Zephurah/ME250-103/MS5 Submission/ME 250 Team 103 CAD Drawings _ Screenshots.pdf

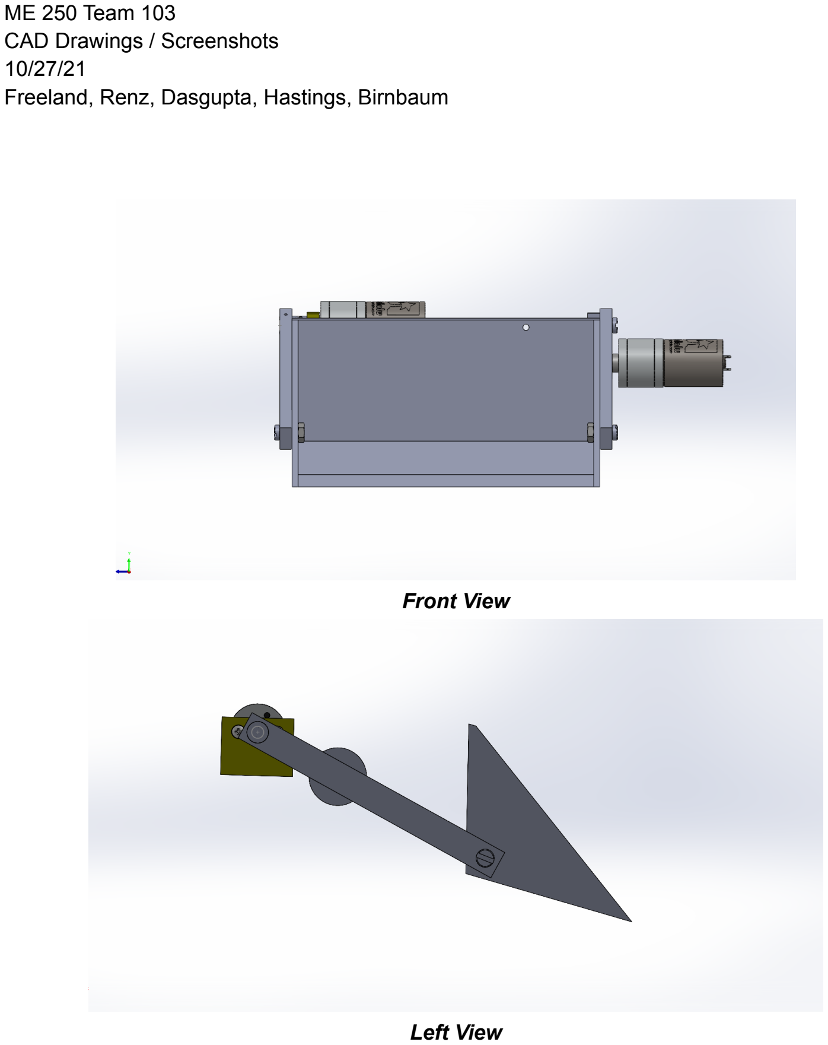
[picture p1: page 1]

ME 250 Team 103
CAD Drawings / Screenshots
10/27/21
Freeland, Renz, Dasgupta, Hastings, Birnbaum

Front View

Left View

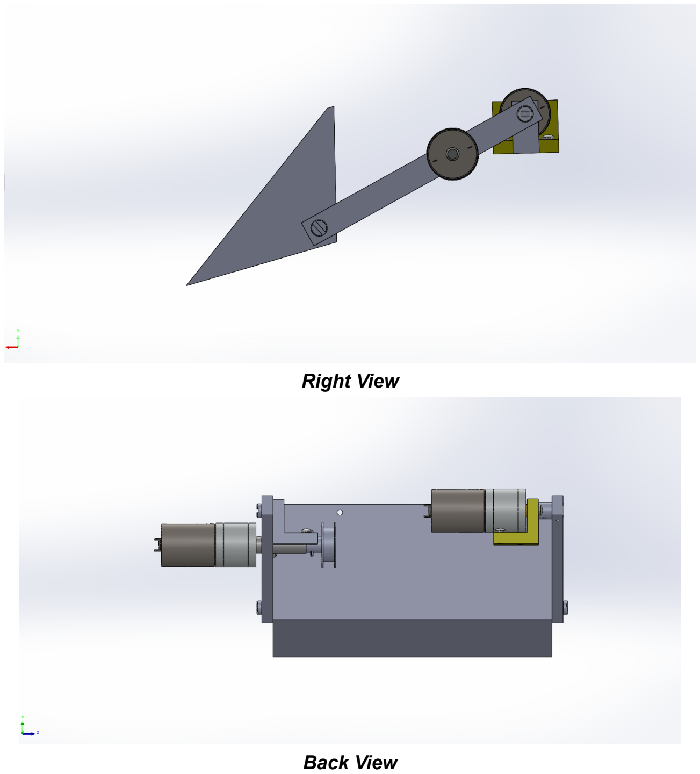
[picture p2: page 2]

Right View

Back View

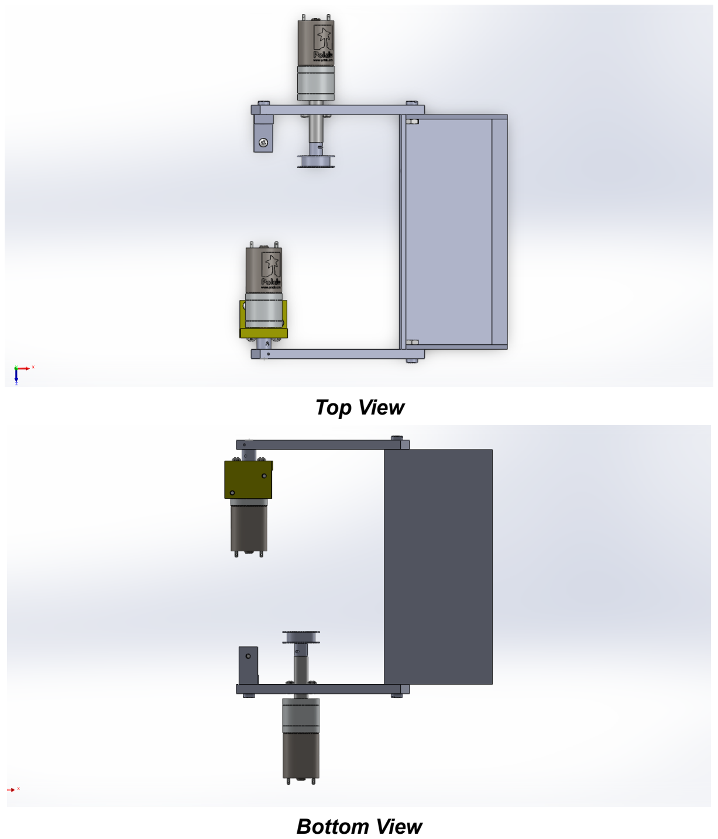
[picture p3: page 3]

Top View

Bottom View

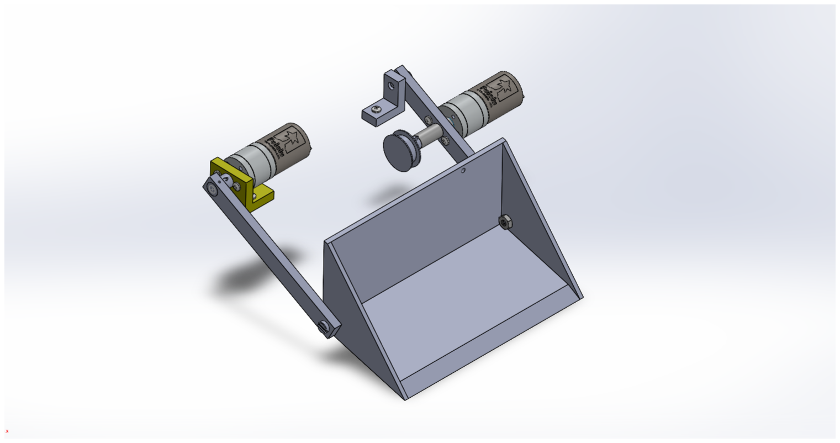
[picture p4: figure]

Isometric 1

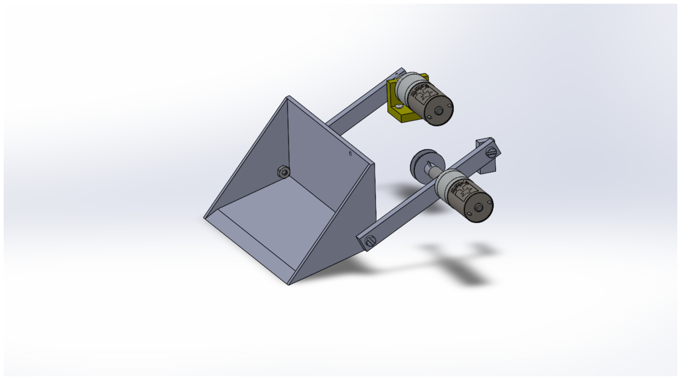
[picture p5: figure]

Isometric 2
