Zephurah/ME250-103/CAD RMP/111 Pre-made parts/Example SetScrew SpringPin/Screenshot.pdf

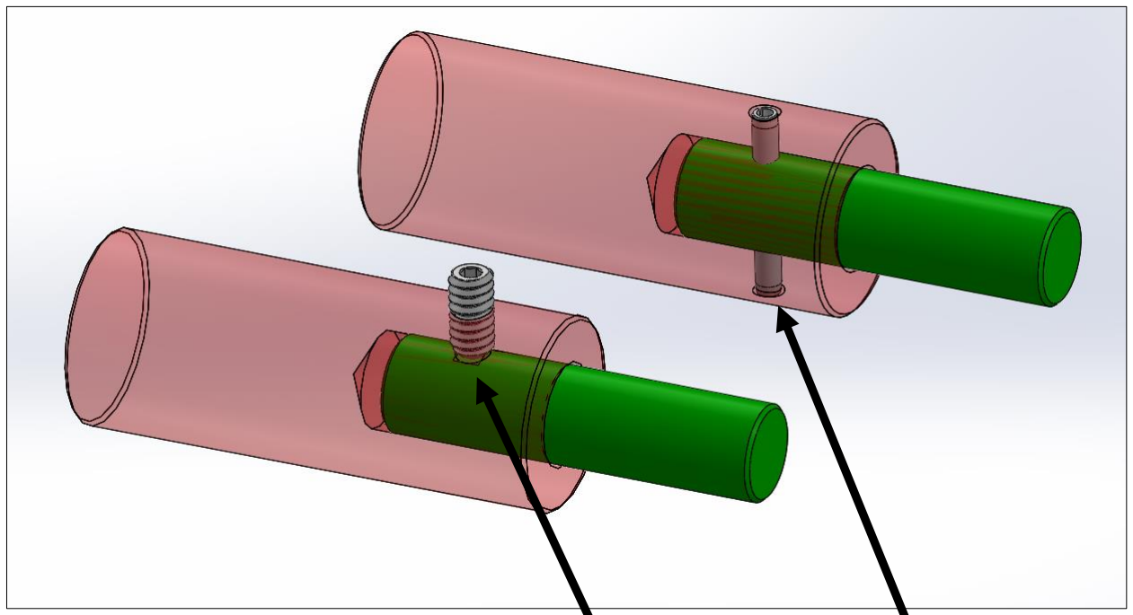
[picture p6: figure]

Set Screw Spring Pin
