Zephurah/ME250-103/CAD RMP/111 Pre-made parts/Planetary Gear Box/TanSunGear.SLDASM

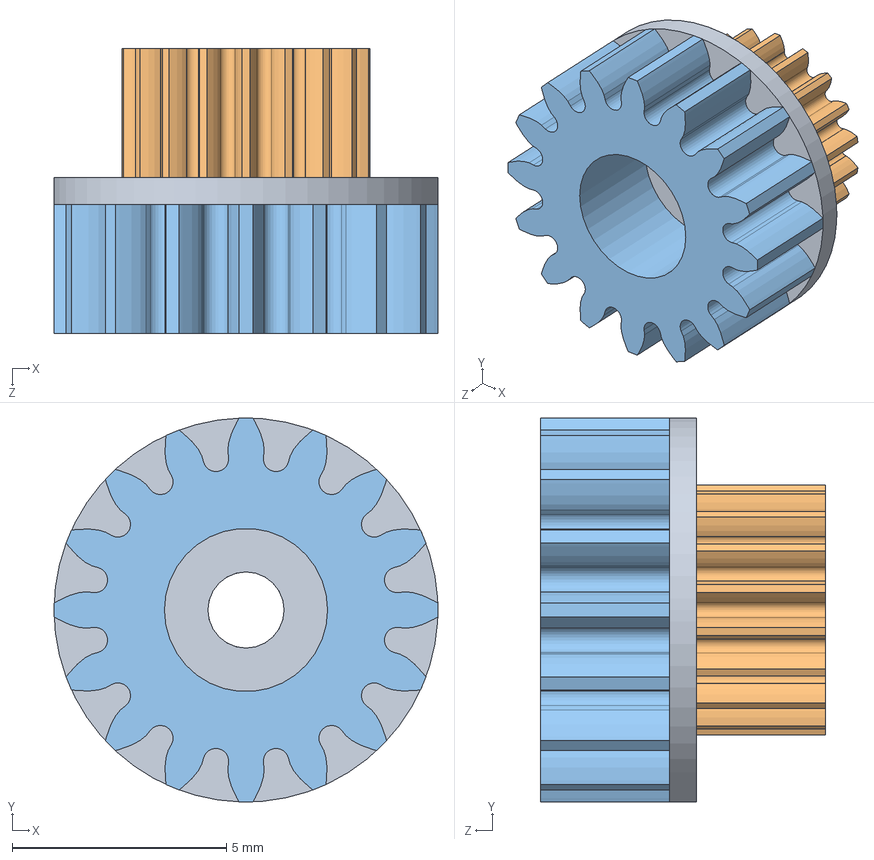
[picture p7: CAD file, 2021-10-25]
CAD RMP/111 Pre-made parts/Planetary Gear Box/TanSunGear.SLDASM
8.97 x 8.96 x 6.65 mm
TanIntermediaryPlate
TanSpurSmall
TanSpurLarge
