Zephurah/ME250-103/CAD RMP/Frame/Concept 4 WO frame.SLDASM

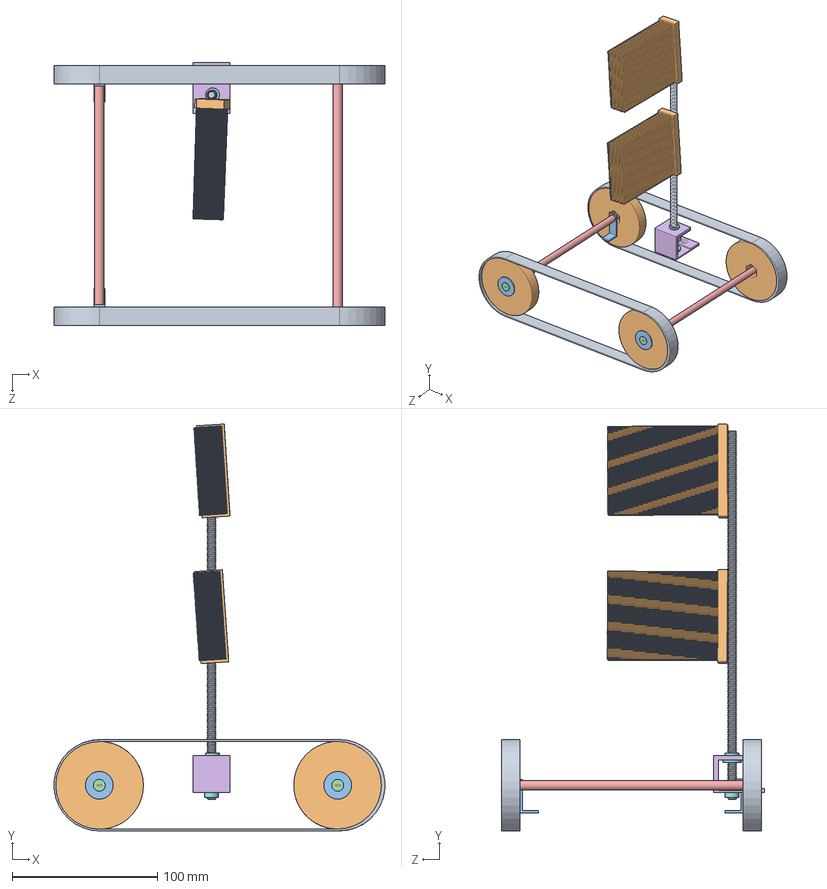
[picture p8: CAD file, 2021-10-25]
CAD RMP/Frame/Concept 4 WO frame.SLDASM
227.7 x 280.2 x 181.0 mm
RMPTread1 x 2
RMPWheel1 x 4
washer 3-4 OD 1-8 ID x 4
Screw 1-8in ID .75in length x 4
Axle x 2
Bracket
Locking pin
1-4 bushing x 2
94210A125_Medium-Strength Threaded Rod - 10in
Brush x 2
.3 X.5 .0625TH L bracket x 2
