Zephurah/ME250-103/CAD RMP/Wheel Axle/Front axle.SLDASM

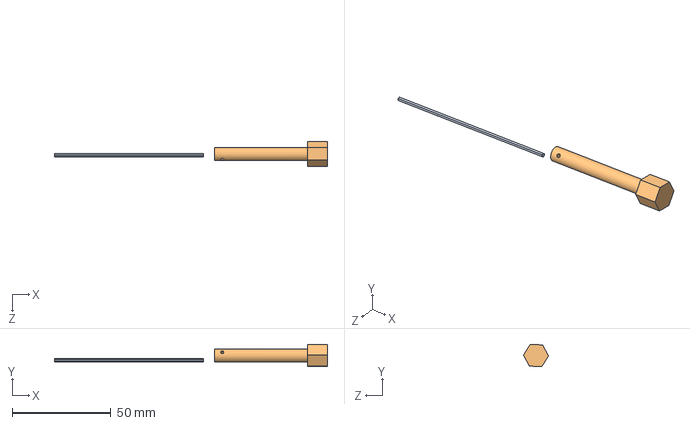
[picture p9: CAD file, 2021-11-29]
CAD RMP/Wheel Axle/Front axle.SLDASM
138.4 x 11.2 x 12.7 mm
motor shaft
Wheel axle
