Zephurah/ME250-103/CAD RMP/Brush/Brush Arm.SLDASM

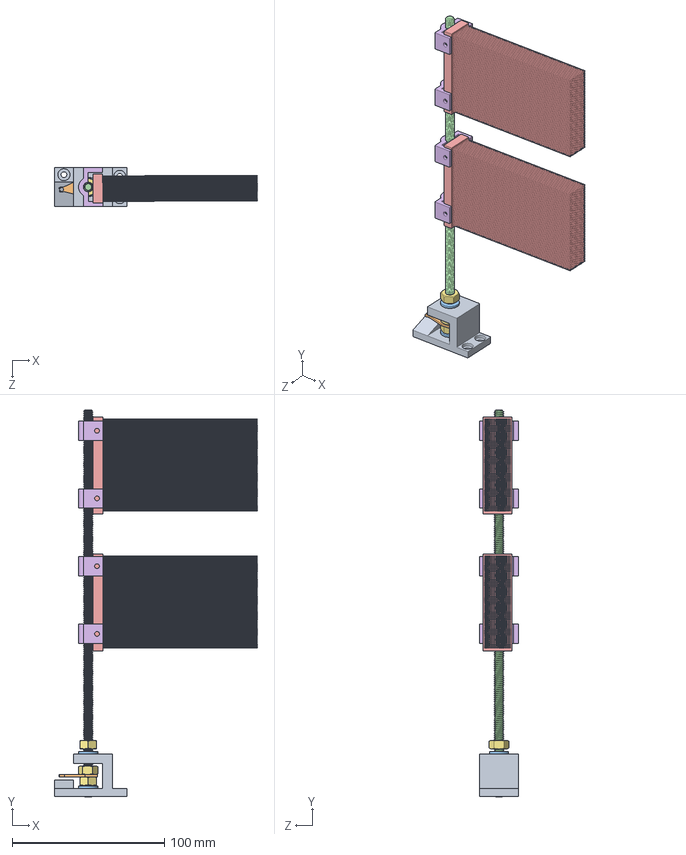
[picture p10: CAD file, 2021-11-11]
CAD RMP/Brush/Brush Arm.SLDASM
133.4 x 254.0 x 25.5 mm
Bracket
Locking pin
1-4 bushing x 2
94210A125_Medium-Strength Threaded Rod - 10in
Brush x 2
support x 4
95462A029_Medium-Strength Steel Hex Nut x 3
