Zephurah/ME250-103/CAD RMP/Frame/New final frame/New Frame with individual sides.SLDASM

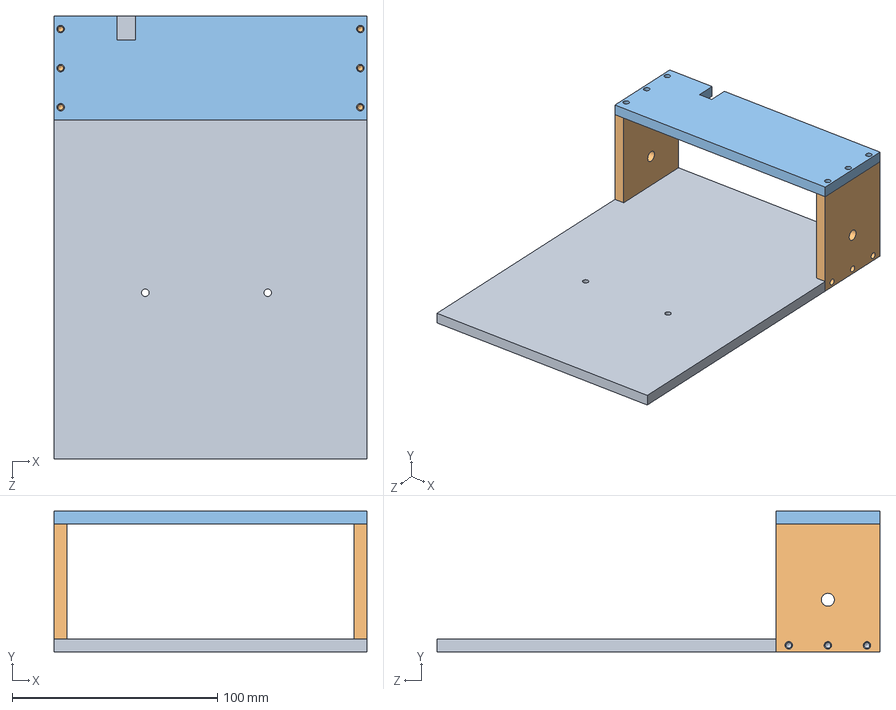
[picture p11: CAD file, 2021-11-11]
CAD RMP/Frame/New final frame/New Frame with individual sides.SLDASM
152.4 x 68.6 x 215.9 mm
Bottom frame
Side frame x 2
Top frame
