Zephurah/ME250-103/CAD RMP/Project/Gear Motor Bracket Assy with String.SLDASM

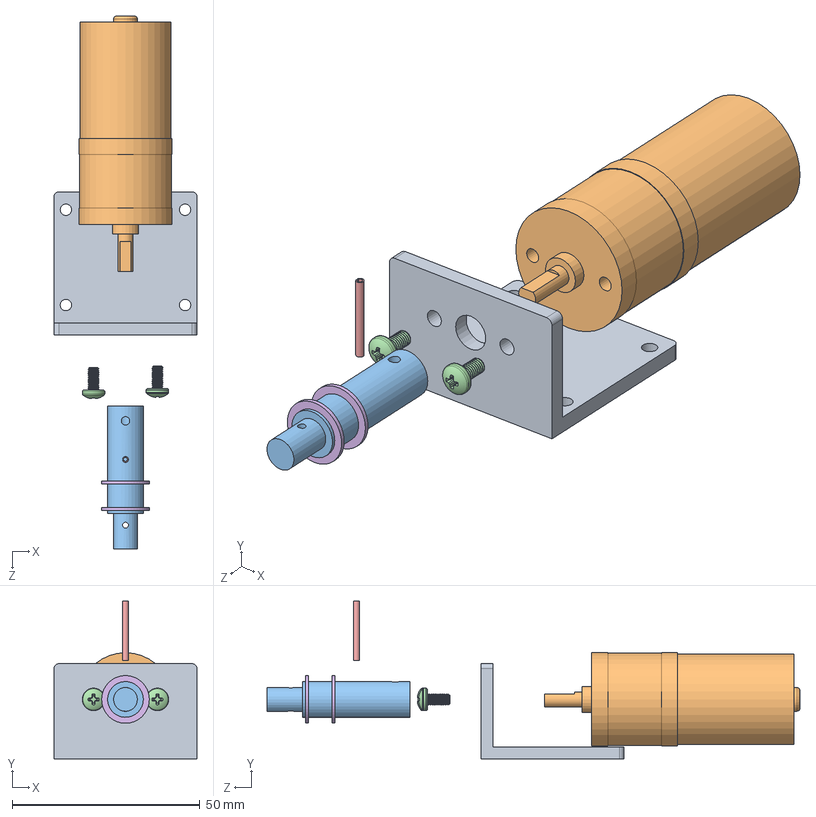
[picture p12: CAD file, 2021-11-11]
CAD RMP/Project/Gear Motor Bracket Assy with String.SLDASM
38.1 x 42.1 x 142.0 mm
Motor Bracket
Gear Motor
Connecting Shaft
3 mm screw x 2
Spring Pin
String Winder
