Zephurah/ME250-103/CAD RMP/Project/Treads/drive-download-20211011T011059Z-001/Finished treads with axle.SLDASM

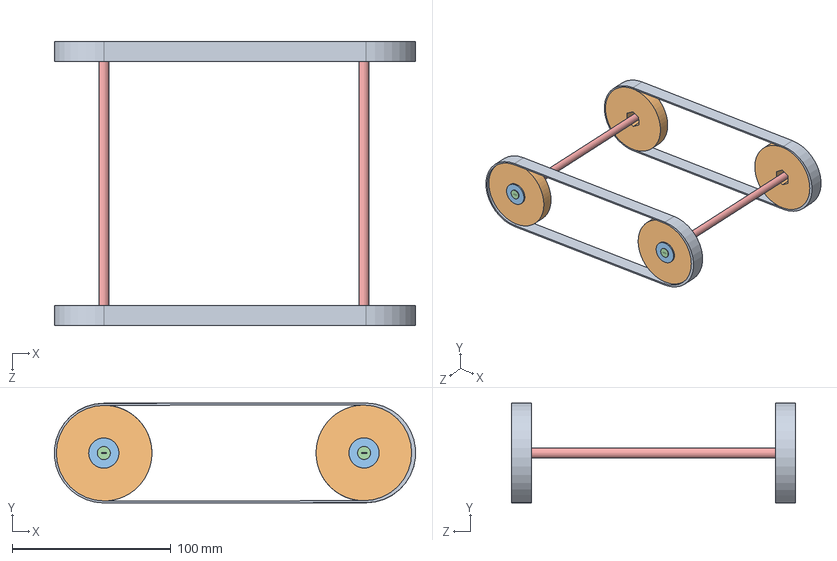
[picture p13: CAD file, 2021-10-25]
CAD RMP/Project/Treads/drive-download-20211011T011059Z-001/Finished treads with axle.SLDASM
227.7 x 63.0 x 179.1 mm
RMPTread1 x 2
RMPWheel1 x 4
washer 3-4 OD 1-8 ID x 4
Screw 1-8in ID .75in length x 4
Axle x 2
