Zephurah/ME250-103/CAD RMP/Treads/RMPtread_Wheel_final.SLDASM

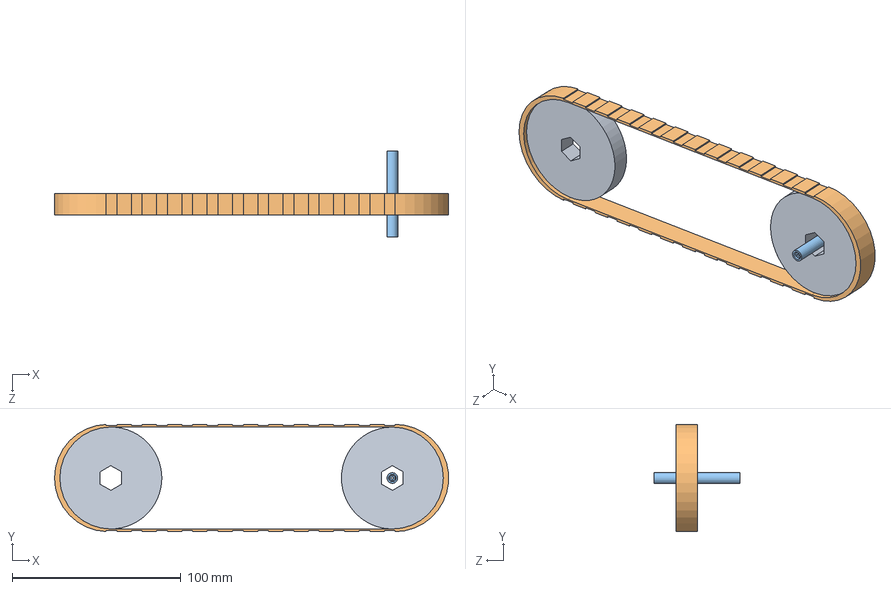
[picture p14: CAD file, 2021-11-06]
CAD RMP/Treads/RMPtread_Wheel_final.SLDASM
233.2 x 63.5 x 50.8 mm
RMPWheel1 x 2
RMPtreadFINALFINALFINAL
myAxle
