Zephurah/ME250-103/CAD RMP/Project/Final Arm Assembly.SLDASM

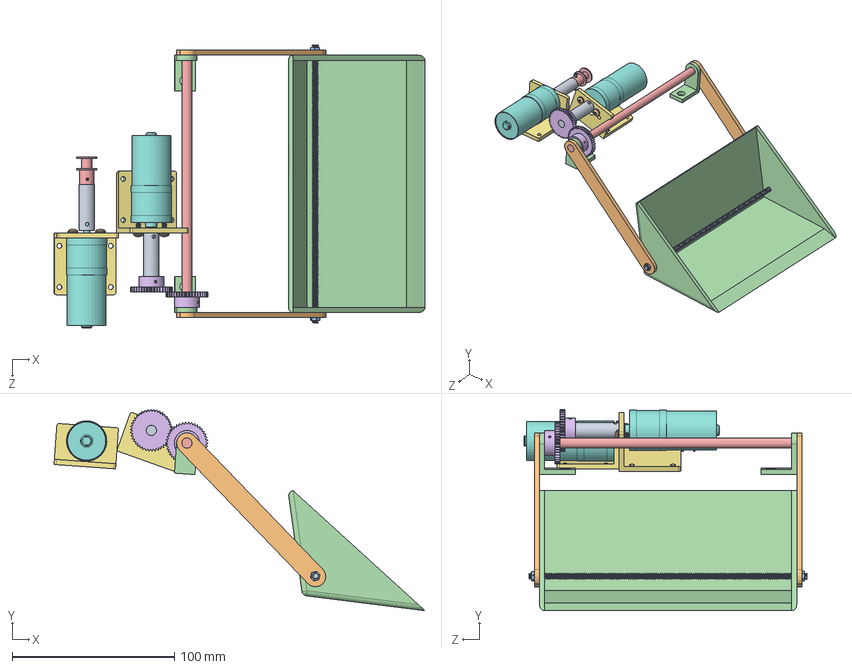
[picture p15: CAD file, 2021-11-11]
CAD RMP/Project/Final Arm Assembly.SLDASM
228.9 x 124.2 x 174.7 mm
Axel
lever Bar x 2
M3Nut x 2
Scooper
Gear Axel
Gear 1 x 2
Motor Bracket x 2
Gear Motor x 2
Connecting Shaft x 2
3 mm screw x 4
Spring Pin x 2
Small L Backet x 2
String Winder
