Zephurah/ME250-103/CAD RMP/Arm/Final Arm Assembly.SLDASM

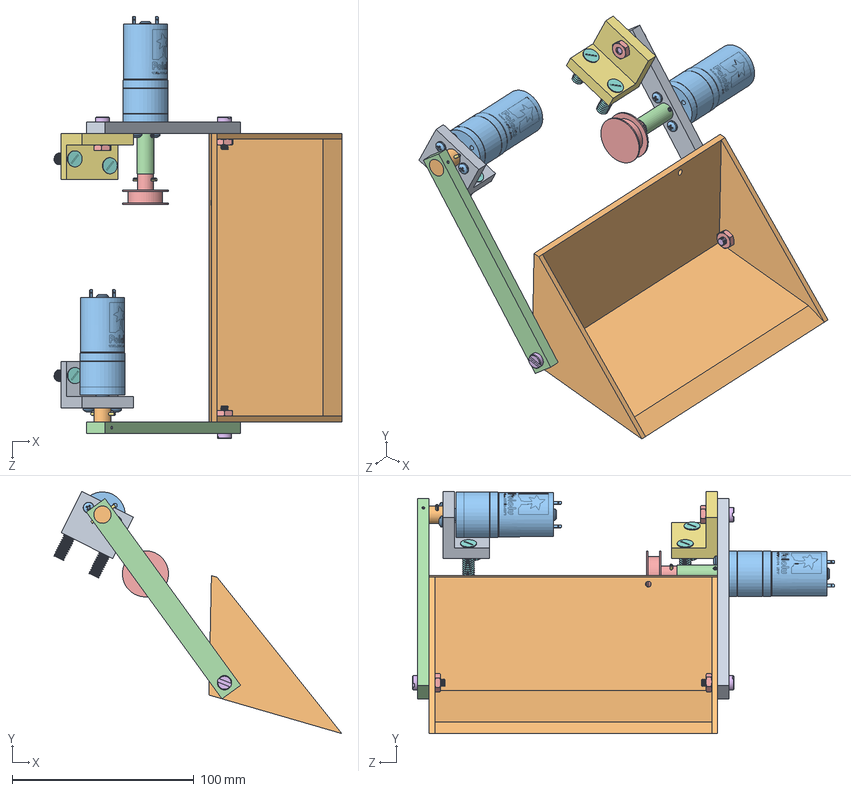
[picture p16: CAD file, 2021-11-05]
CAD RMP/Arm/Final Arm Assembly.SLDASM
158.4 x 133.3 x 232.2 mm
lever Bar
Scooper
Metal Motor x 2
Connecting Shaft
String Winder
screw with shoulder REAL x 3
Spring Pin x 2
4-40 set screw
Motor Bracket
Motor Arm Connecting shaft
3 mm screw x 4
lever Bar(DRIVING)
90480A009_Low-Strength Steel Hex Nut x 3
0.500 inch Spring Pin
Small L Bracket V2
Screw 1-4in ID .75in length x 4
