Zephurah/ME250-103/CAD RMP/Project/The Final Assembly.SLDASM

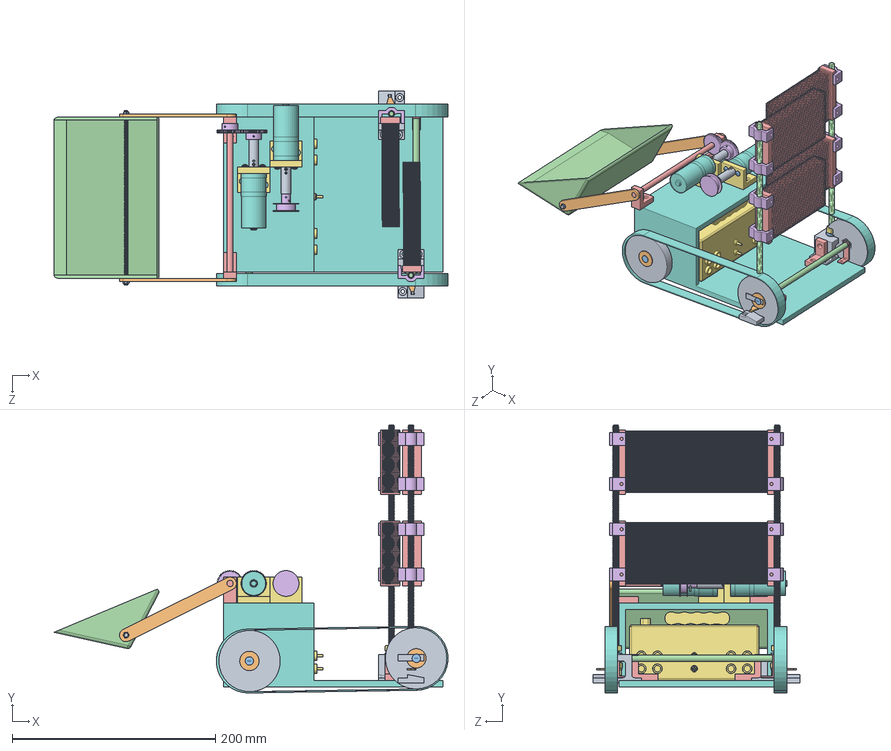
[picture p17: CAD file, 2021-11-11]
CAD RMP/Project/The Final Assembly.SLDASM
387.4 x 263.5 x 203.2 mm
Axel
lever Bar x 2
M3Nut x 2
Scooper
Gear Axel
Gear 1 x 2
Motor Bracket x 2
Gear Motor x 2
Connecting Shaft x 2
4-40 Set Screw x 2
3 mm screw x 4
Spring Pin x 2
Small L Backet x 4
String Winder
Control Box
Frame final
Bracket x 2
Locking pin x 2
1-4 bushing x 4
94210A125_Medium-Strength Threaded Rod - 10in x 2
Brush x 4
support x 8
95462A029_Medium-Strength Steel Hex Nut x 6
RMPTread1 x 2
RMPWheel1 x 4
washer 3-4 OD 1-8 ID x 4
Screw 1-8in ID .75in length x 4
Axle x 2
3 X.5 .0625TH L bracket x 2
