Zephurah/ME250-103/CAD RMP/Treads/Finished treads with axle.SLDASM

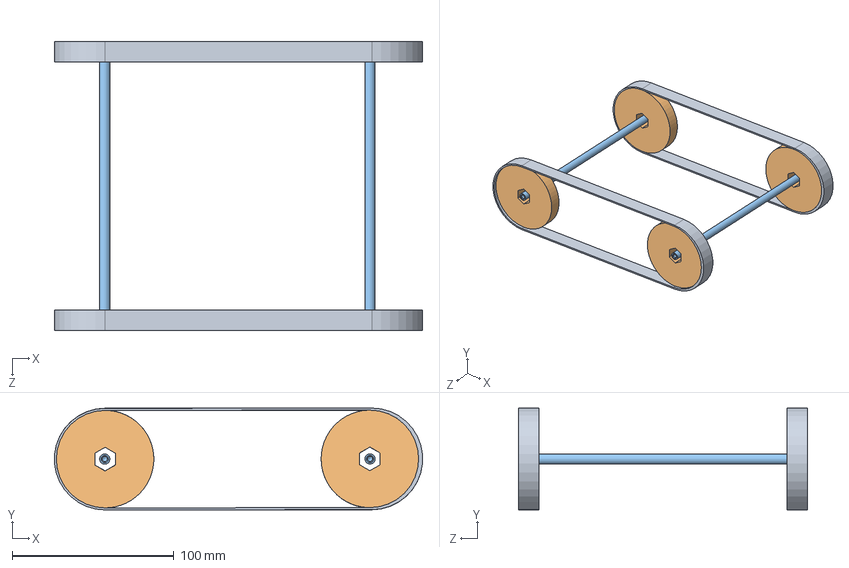
[picture p18: CAD file, 2021-11-06]
CAD RMP/Treads/Finished treads with axle.SLDASM
227.7 x 63.0 x 179.1 mm
RMPTread1 x 2
RMPWheel1 x 4
Axle x 2
