Zephurah/ME250-103/CAD RMP/Wheel Axle/Back wheel axle.SLDASM

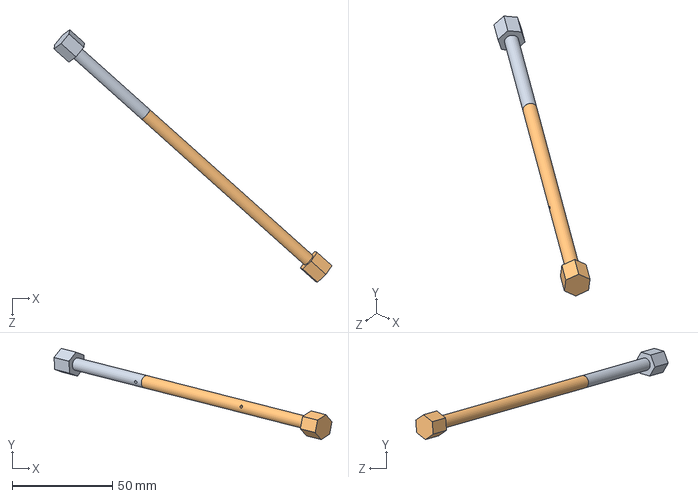
[picture p19: CAD file, 2021-11-09]
CAD RMP/Wheel Axle/Back wheel axle.SLDASM
138.8 x 45.6 x 126.1 mm
Wheel axle
Back axle
