Zephurah/ME250-103/CAD RMP/111 Pre-made parts/Mounting_Examples/Double GearBox Motor Base Plate.SLDASM

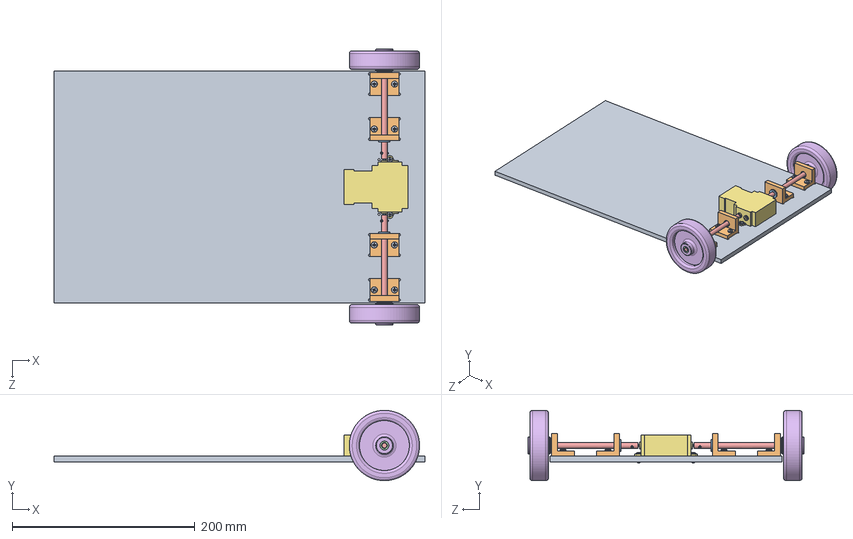
[picture p20: CAD file, 2021-10-25]
CAD RMP/111 Pre-made parts/Mounting_Examples/Double GearBox Motor Base Plate.SLDASM
406.4 x 77.0 x 302.1 mm
Base Plate with Bushing Mount pockets
Bushing Mount 2 x 4
Bushing x 4
Wheel Bushing x 2
Wheel connecting shaft x 2
Wheel for Slotbot x 2
Motor Blank
Motor Shaft
Pan Cross Head_AI x 10
Socket Set Screw Cup Point_AI x 4
