Zephurah/ME250-103/CAD RMP/Arm/Final Driving Lever Arm.SLDASM

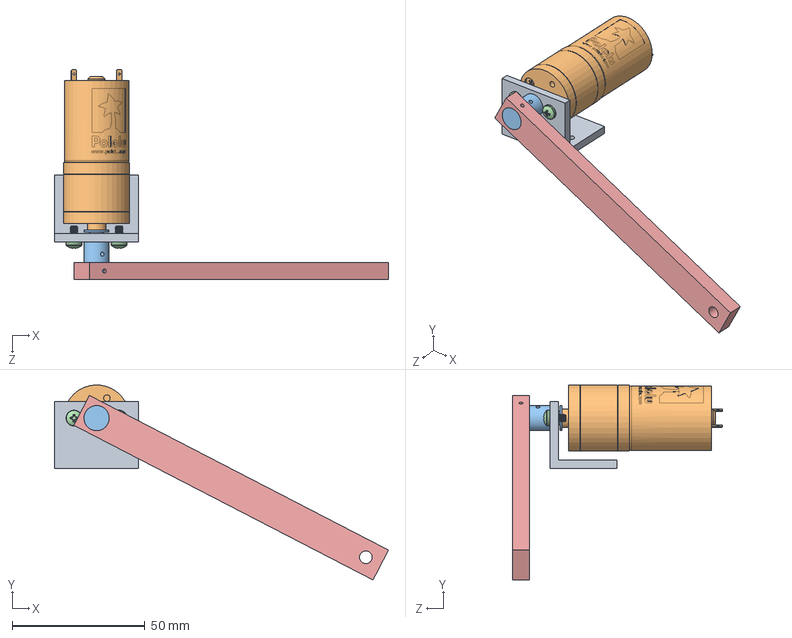
[picture p21: CAD file, 2021-11-04]
CAD RMP/Arm/Final Driving Lever Arm.SLDASM
126.0 x 73.5 x 79.1 mm
Motor Bracket
Metal Motor
Motor Arm Connecting shaft
3 mm screw x 2
lever Bar(DRIVING)
