Zephurah/ME250-103/CAD RMP/Project/Gear Motor Bracket Assy 2.SLDASM

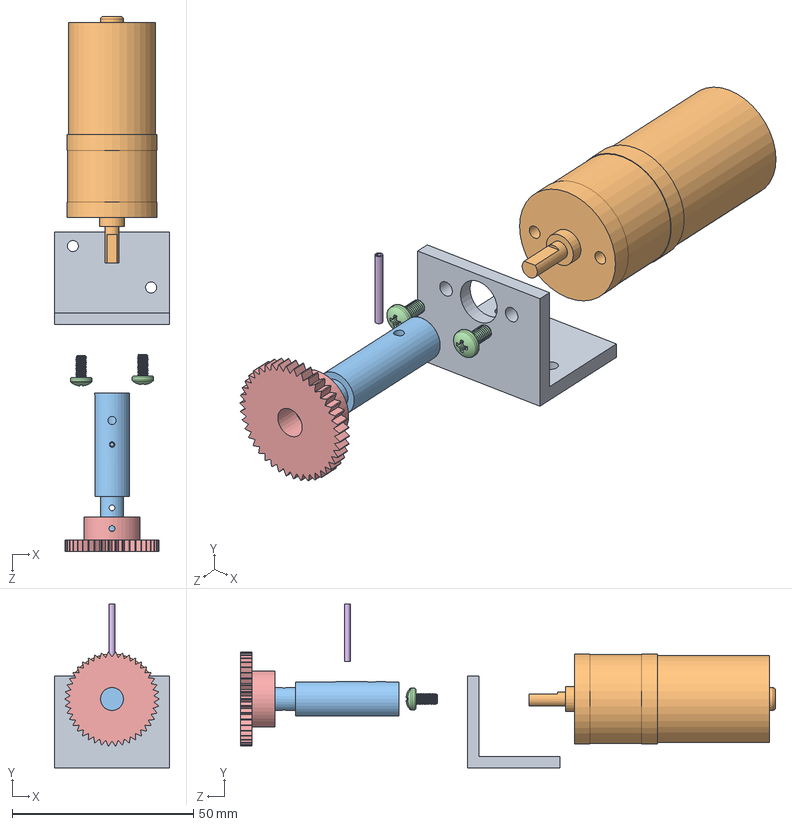
[picture p22: CAD file, 2021-11-11]
CAD RMP/Project/Gear Motor Bracket Assy 2.SLDASM
31.8 x 45.3 x 147.7 mm
Motor Bracket
Gear Motor
Connecting Shaft
3 mm screw x 2
Gear 1
Spring Pin
