Zephurah/ME250-103/CAD RMP/Treads/WheelTreadAssem.SLDASM

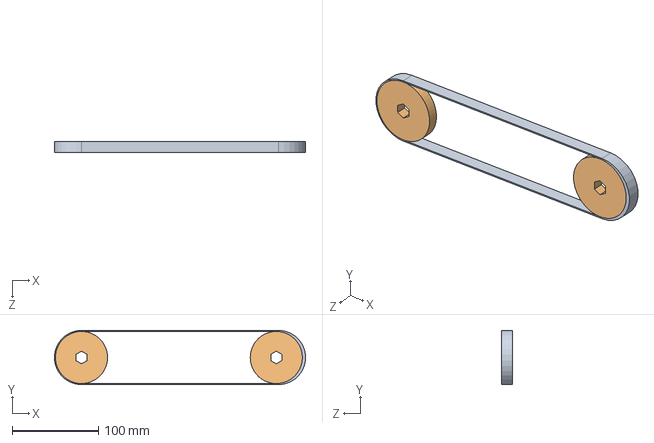
[picture p23: CAD file, 2021-11-01]
CAD RMP/Treads/WheelTreadAssem.SLDASM
290.5 x 62.9 x 12.7 mm
RMPTread1
RMPWheel1 x 2
