Zephurah/ME250-103/CAD RMP/111 Pre-made parts/Mounting_Examples/Assembled Shaft Mount Bracket and Bushing.SLDASM

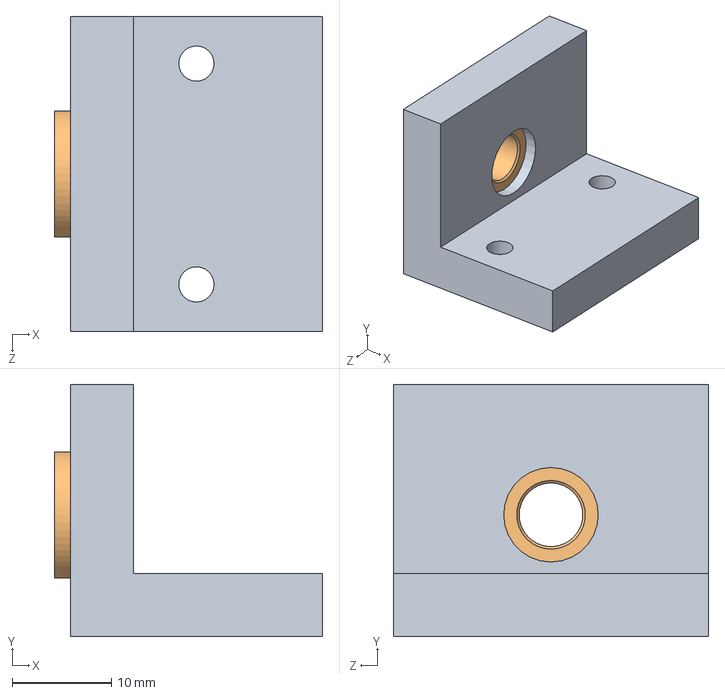
[picture p24: CAD file, 2021-10-25]
CAD RMP/111 Pre-made parts/Mounting_Examples/Assembled Shaft Mount Bracket and Bushing.SLDASM
27.0 x 25.4 x 31.8 mm
Bushing Mount 2
Bushing
