Zephurah/ME250-103/CAD RMP/111 Pre-made parts/Mounting_Examples/24 tooth Gear.SLDASM

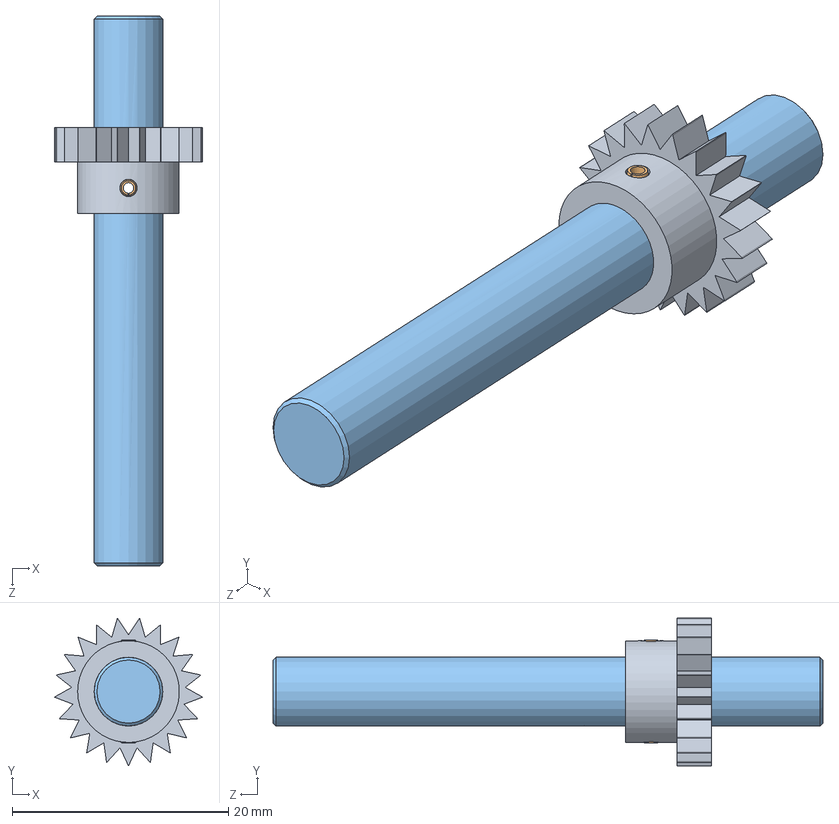
[picture p25: CAD file, 2021-10-25]
CAD RMP/111 Pre-made parts/Mounting_Examples/24 tooth Gear.SLDASM
13.7 x 13.6 x 50.8 mm
24 tooth Gear
Spring Pin Slotted_AI
Sample Gear Shaft 24 tooth
