Zephurah/ME250-103/CAD RMP/111 Pre-made parts/Mounting_Examples/Exploded Gear Rack Assy..SLDASM

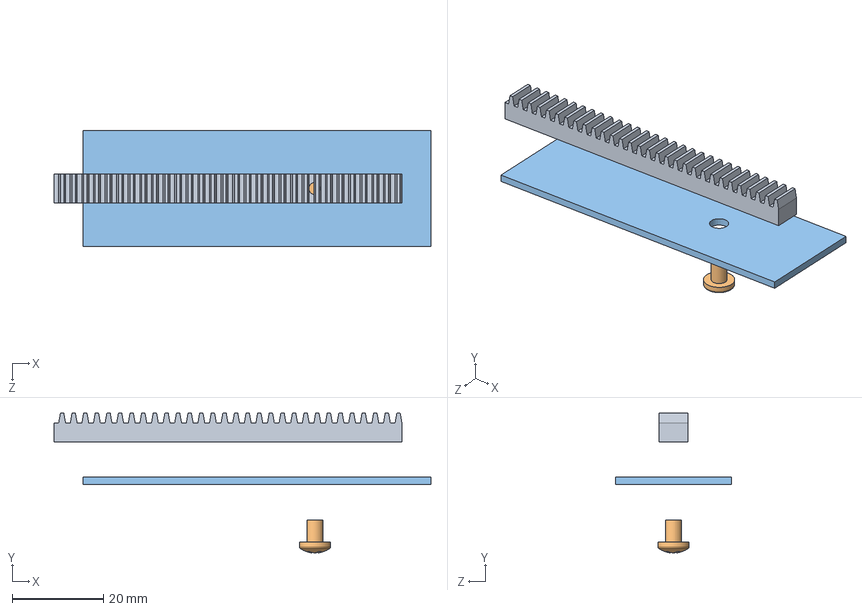
[picture p26: CAD file, 2021-10-25]
CAD RMP/111 Pre-made parts/Mounting_Examples/Exploded Gear Rack Assy..SLDASM
82.6 x 30.6 x 25.4 mm
Gear Rack Example
Pan Cross Head_AI
.063 Alum Plate
