Zephurah/ME250-103/CAD RMP/111 Pre-made parts/Mounting_Examples/Motor Assem.SLDASM

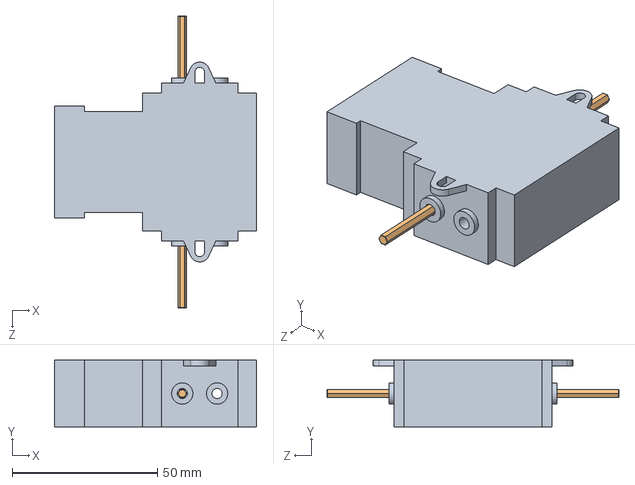
[picture p27: CAD file, 2021-10-25]
CAD RMP/111 Pre-made parts/Mounting_Examples/Motor Assem.SLDASM
69.6 x 23.0 x 100.5 mm
Motor Blank
Motor Shaft
