Zephurah/ME250-103/CAD RMP/111 Pre-made parts/Planetary Gear Box/OrangeDriveDiskCut.SLDASM

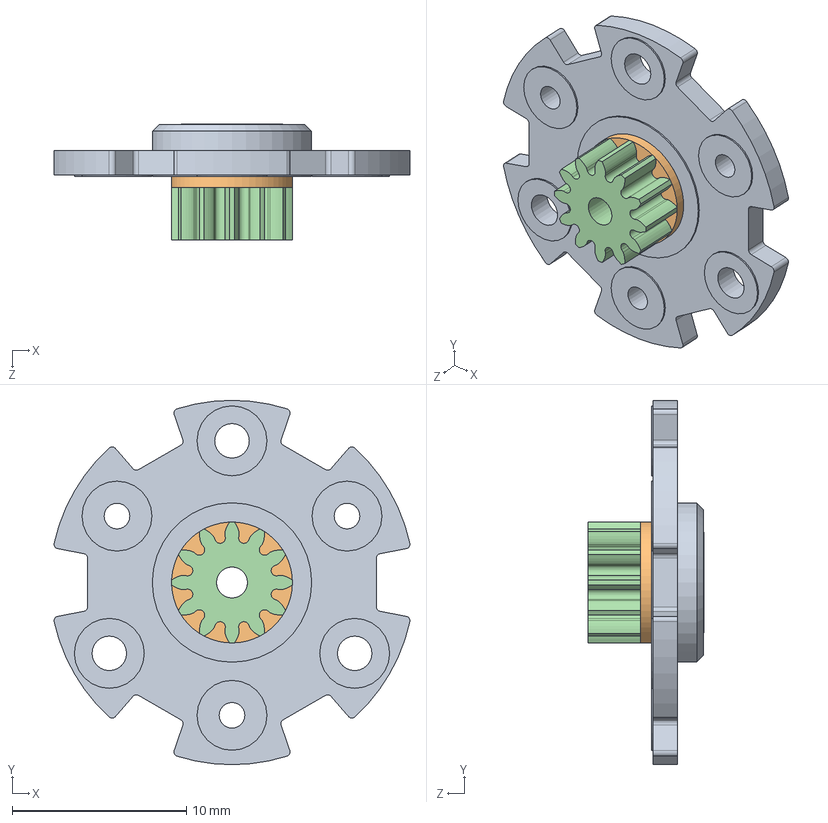
[picture p28: CAD file, 2021-10-25]
CAD RMP/111 Pre-made parts/Planetary Gear Box/OrangeDriveDiskCut.SLDASM
20.4 x 20.9 x 6.64 mm
OrangeDriveDisk
OrangeIntermediaryPlate
OrangeSpurSmall
OrangeSpurLarge
