Zephurah/ME250-103/CAD RMP/111 Pre-made parts/Planetary Gear Box/A_Outlet.SLDASM

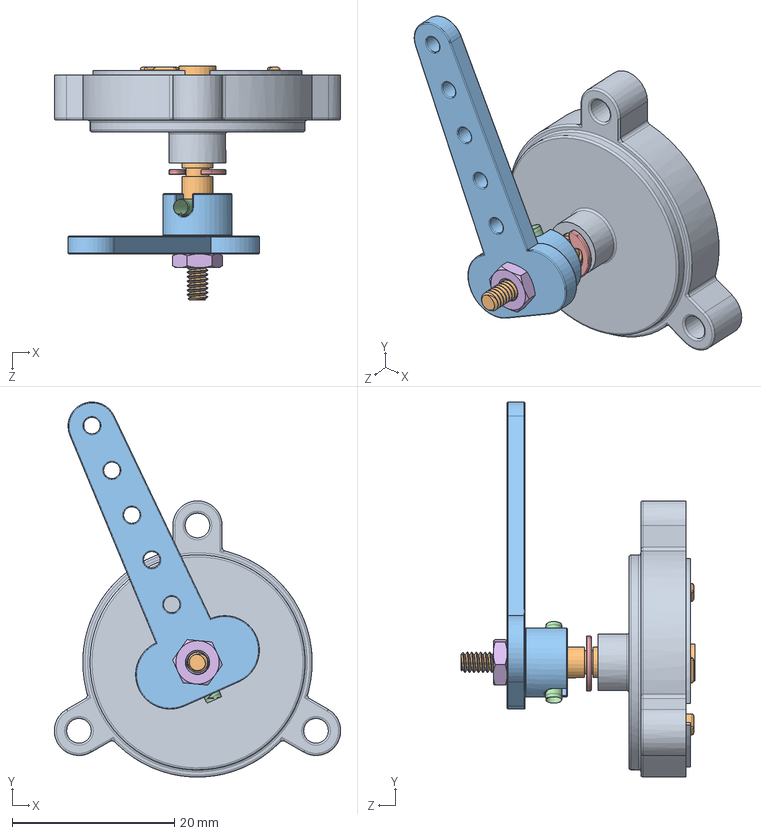
[picture p29: CAD file, 2021-10-25]
CAD RMP/111 Pre-made parts/Planetary Gear Box/A_Outlet.SLDASM
35.4 x 46.3 x 28.8 mm
OutletCase
DriveDiskJoint
SingleHorn
SpringPin
EClip
M3Nut
