Zephurah/ME250-103/CAD RMP/111 Pre-made parts/Planetary Gear Box/A_TanSet.SLDASM

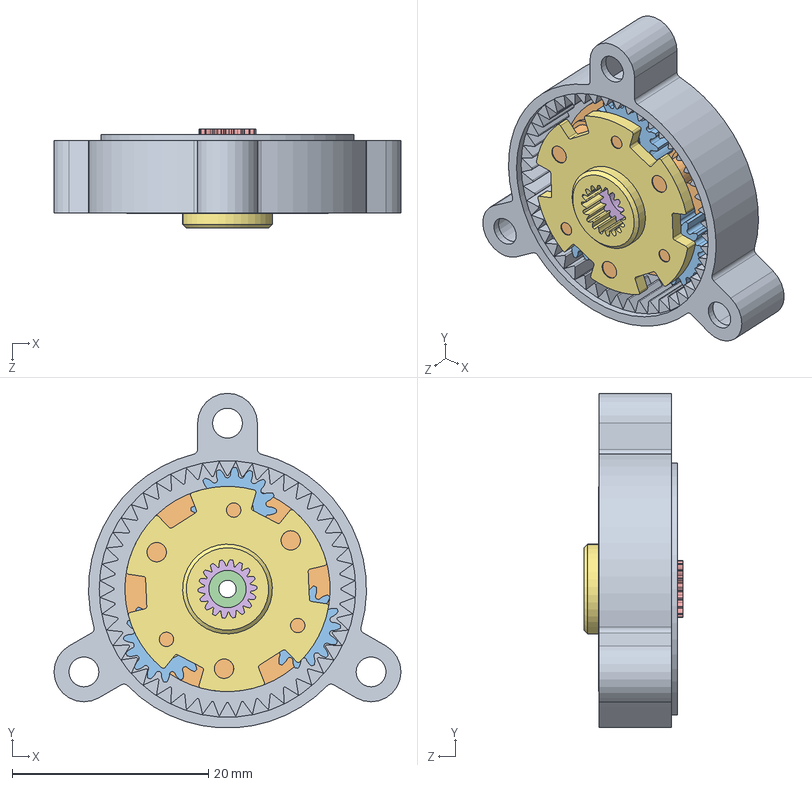
[picture p30: CAD file, 2021-10-25]
CAD RMP/111 Pre-made parts/Planetary Gear Box/A_TanSet.SLDASM
35.4 x 34.1 x 10.1 mm
HousingCase
TanArmDisk
TanPlanetGear x 3
TanIntermediaryPlate
TanSpurSmall
TanSpurLarge
TanDriveDisk
