Zephurah/ME250-103/CAD RMP/111 Pre-made parts/Planetary Gear Box/TanStack.SLDASM

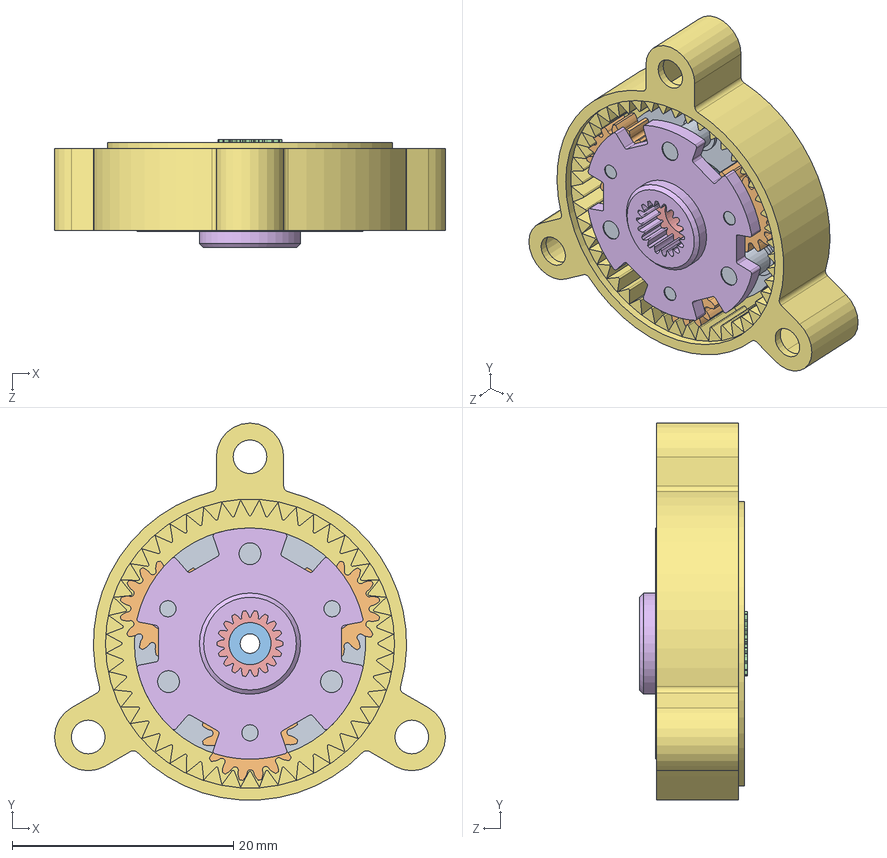
[picture p31: CAD file, 2021-10-25]
CAD RMP/111 Pre-made parts/Planetary Gear Box/TanStack.SLDASM
35.4 x 34.1 x 9.80 mm
TanArmDisk
TanPlanetGear x 3
TanIntermediaryPlate
TanSpurSmall
TanSpurLarge
HousingCase
