Zephurah/ME250-103/CAD RMP/111 Pre-made parts/Planetary Gear Box/TanSet.SLDASM

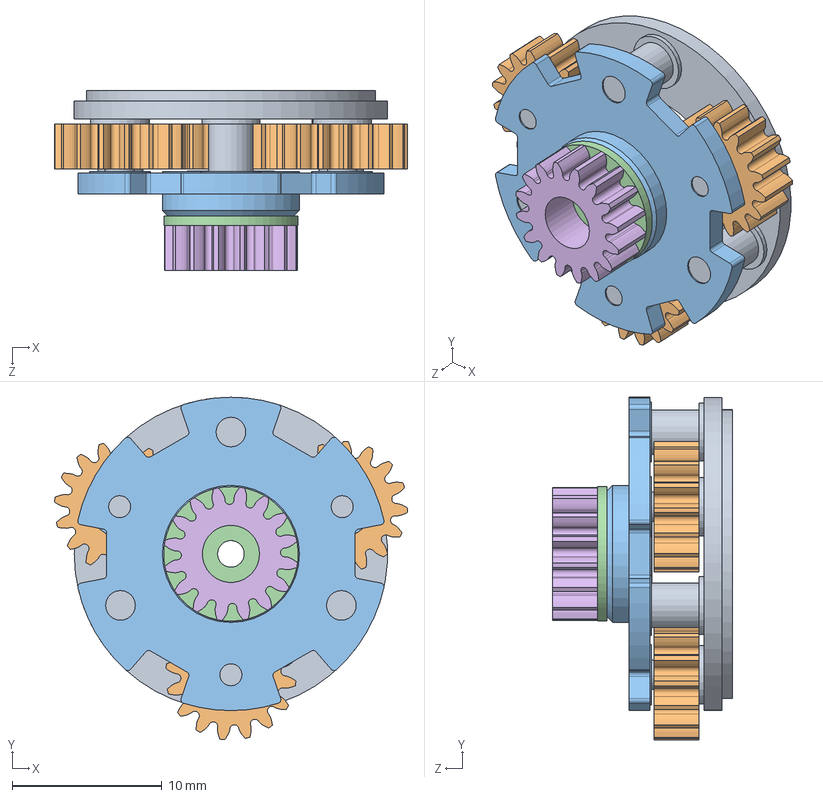
[picture p33: CAD file, 2021-10-25]
CAD RMP/111 Pre-made parts/Planetary Gear Box/TanSet.SLDASM
23.5 x 22.9 x 12.0 mm
TanArmDisk
TanPlanetGear x 3
TanDriveDisk
TanIntermediaryPlate
TanSpurSmall
TanSpurLarge
