Zephurah/ME250-103/CAD RMP/111 Pre-made parts/Mounting_Examples/Gear Assy..SLDASM

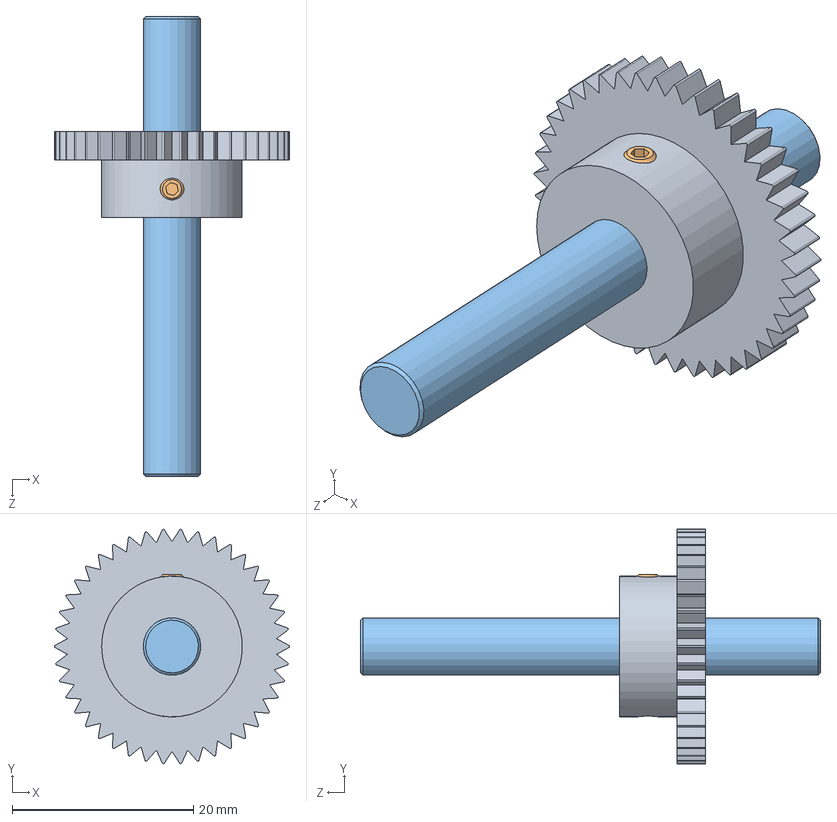
[picture p34: CAD file, 2021-10-25]
CAD RMP/111 Pre-made parts/Mounting_Examples/Gear Assy..SLDASM
26.0 x 25.9 x 50.8 mm
Gear
Socket Set Screw Cup Point_AI
Sample Gear Shaft
