Zephurah/ME250-103/CAD RMP/111 Pre-made parts/Planetary Gear Box/A_PlanetaryGearbox.SLDASM

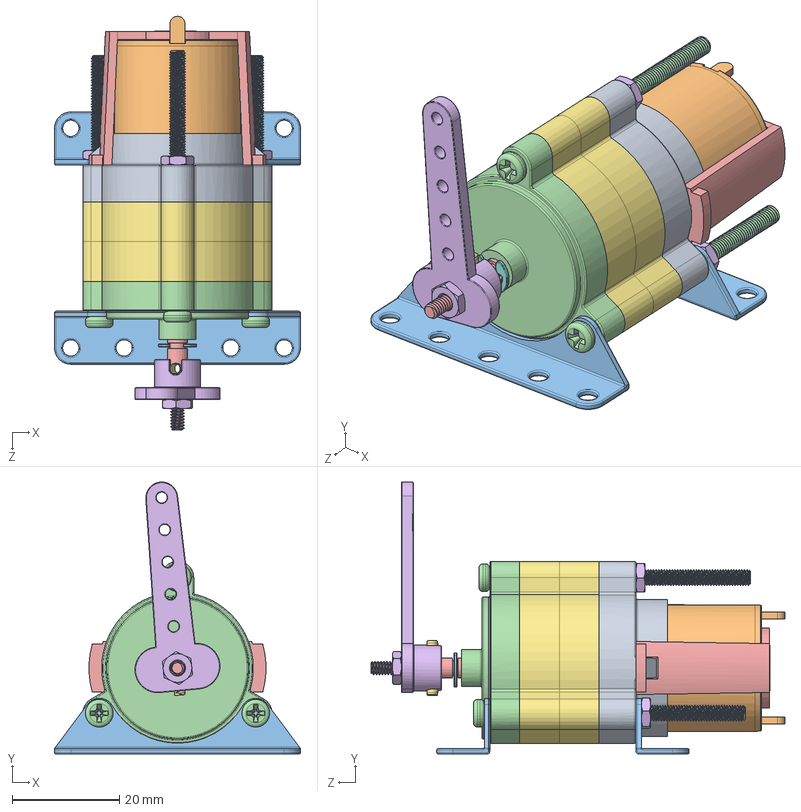
[picture p35: CAD file, 2021-10-25]
CAD RMP/111 Pre-made parts/Planetary Gear Box/A_PlanetaryGearbox.SLDASM
46.0 x 50.8 x 77.3 mm
MotorCase
Motor
GearboxMount x 2
M3TieBolt x 3
MotorStay
M3Nut x 4
HousingCase x 2
OrangeArmDisk
OrangePlanetGear x 3
OrangeIntermediaryPlate
OrangeSpurSmall
OrangeSpurLarge
OrangeDriveDisk
TanArmDisk
TanPlanetGear x 3
TanIntermediaryPlate
TanSpurSmall
TanSpurLarge
TanDriveDisk
OutletCase
DriveDiskJoint
SingleHorn
SpringPin
EClip
