Zephurah/ME250-103/CAD RMP/111 Pre-made parts/Mounting_Examples/Full length Gear Rack Example.SLDPRT

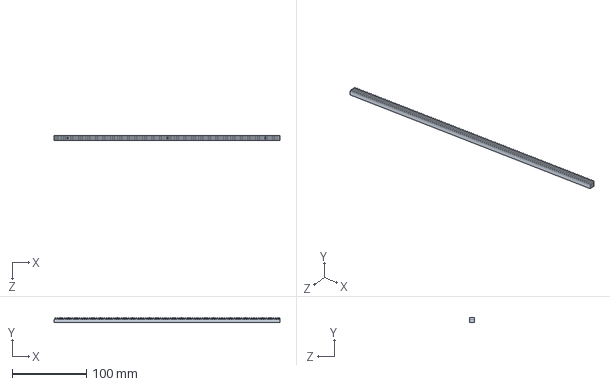
[picture p36: CAD file, 2021-10-25]
CAD RMP/111 Pre-made parts/Mounting_Examples/Full length Gear Rack Example.SLDPRT
304.8 x 6.35 x 6.35 mm
