Zephurah/ME250-103/CAD RMP/111 Pre-made parts/Planetary Gear Box/A_Root.SLDASM

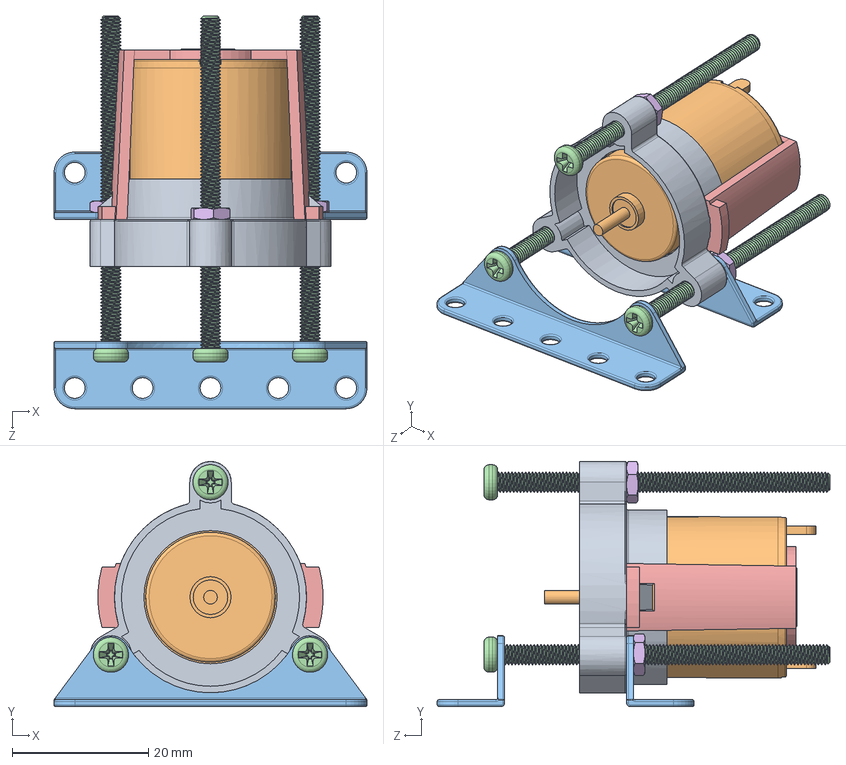
[picture p37: CAD file, 2021-10-25]
CAD RMP/111 Pre-made parts/Planetary Gear Box/A_Root.SLDASM
46.0 x 36.0 x 57.7 mm
MotorCase
Motor
GearboxMount x 2
M3TieBolt x 3
MotorStay
M3Nut x 3
