Zephurah/ME250-103/CAD RMP/111 Pre-made parts/Mounting_Examples/Gear Motor Bracket Assy..SLDASM

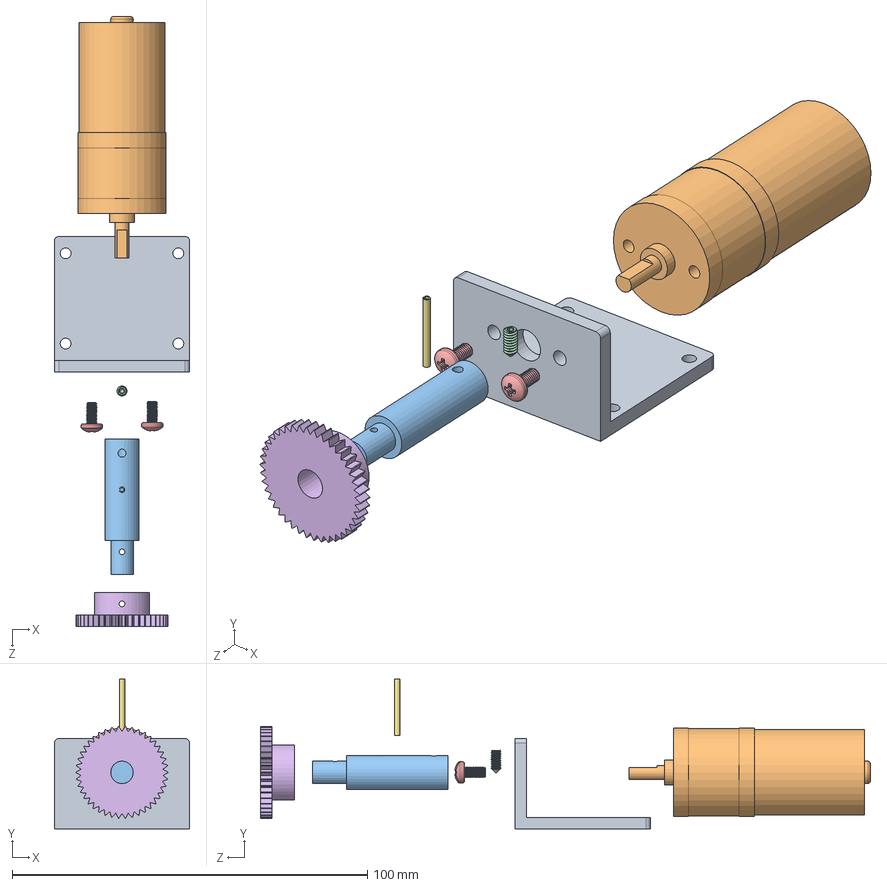
[picture p38: CAD file, 2021-10-25]
CAD RMP/111 Pre-made parts/Mounting_Examples/Gear Motor Bracket Assy..SLDASM
38.1 x 42.1 x 171.7 mm
Motor Bracket
Gear Motor
Connecting Shaft
4-40 Set Screw
3 mm screw x 2
Gear 1
Spring Pin
