Zephurah/ME250-103/CAD RMP/111 Pre-made parts/Planetary Gear Box/A_OrangeSet.SLDASM

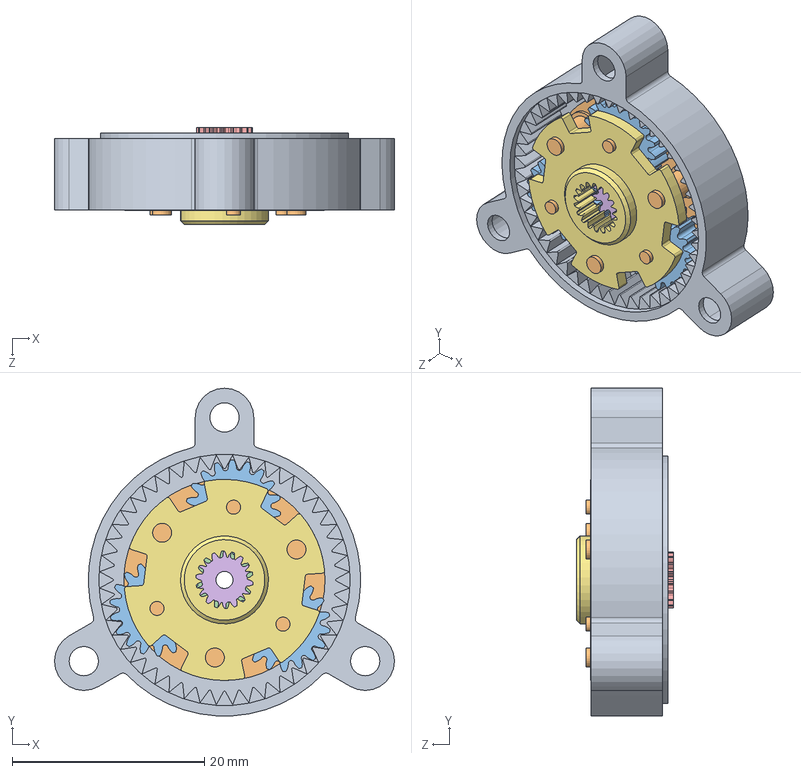
[picture p39: CAD file, 2021-10-25]
CAD RMP/111 Pre-made parts/Planetary Gear Box/A_OrangeSet.SLDASM
35.4 x 34.1 x 10.1 mm
HousingCase
OrangeArmDisk
OrangePlanetGear x 3
OrangeIntermediaryPlate
OrangeSpurSmall
OrangeSpurLarge
OrangeDriveDisk
