Zephurah/ME250-103/CAD RMP/111 Pre-made parts/Planetary Gear Box/OrangeSet.SLDASM

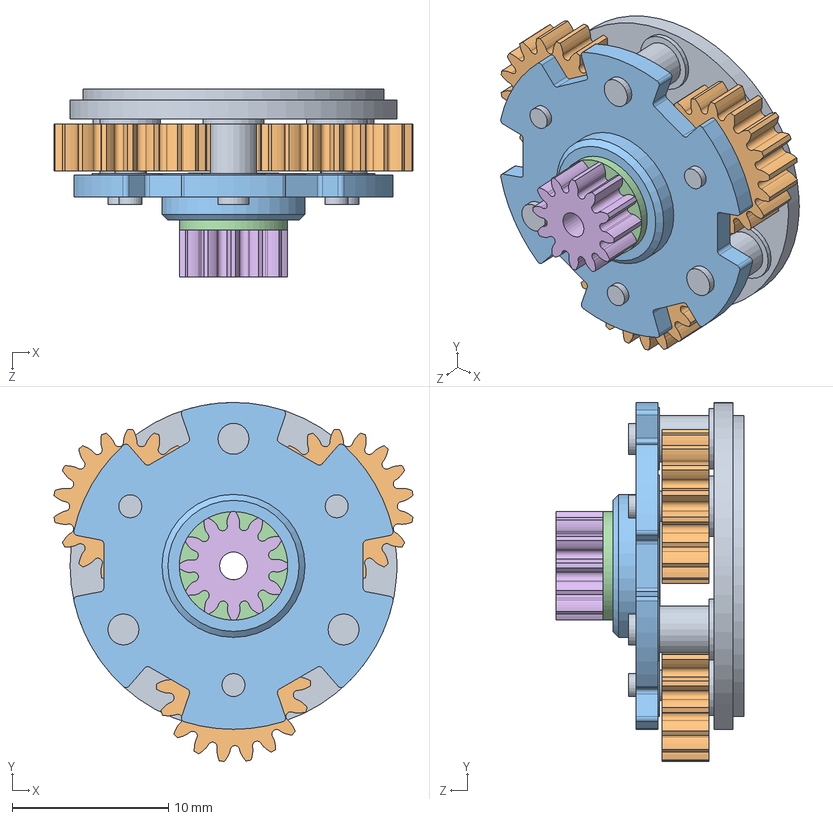
[picture p40: CAD file, 2021-10-25]
CAD RMP/111 Pre-made parts/Planetary Gear Box/OrangeSet.SLDASM
23.0 x 23.0 x 12.0 mm
OrangeArmDisk
OrangePlanetGear x 3
OrangeDriveDisk
OrangeIntermediaryPlate
OrangeSpurSmall
OrangeSpurLarge
