Zephurah/ME250-103/CAD RMP/111 Pre-made parts/Planetary Gear Box/OrangeSunGear.SLDASM

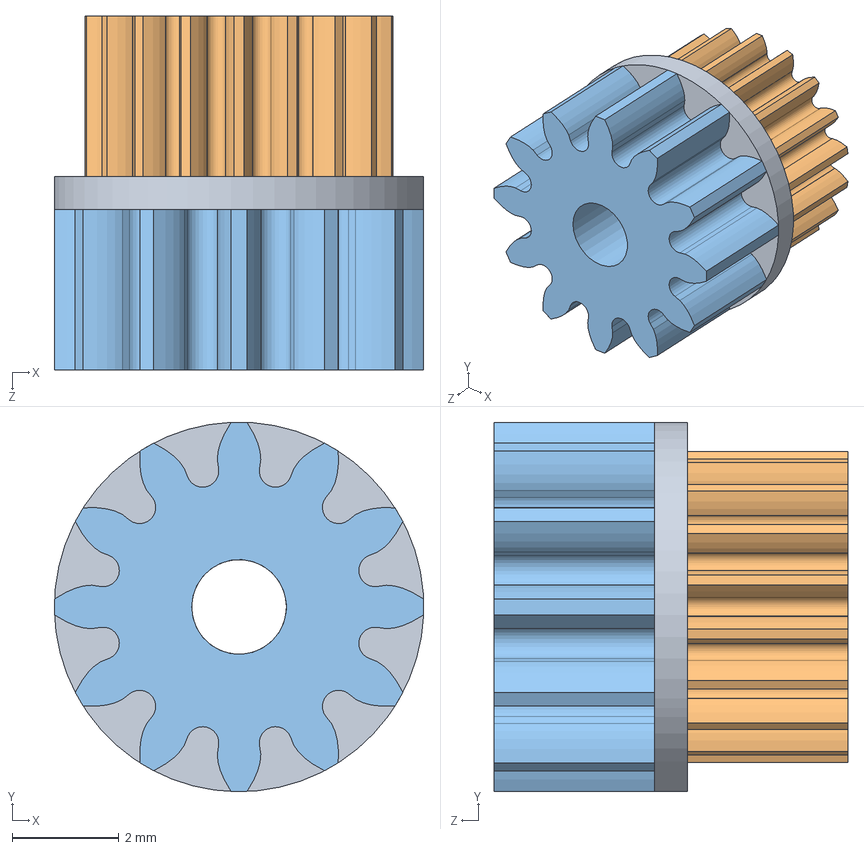
[picture p41: CAD file, 2021-10-25]
CAD RMP/111 Pre-made parts/Planetary Gear Box/OrangeSunGear.SLDASM
6.93 x 6.93 x 6.64 mm
OrangeIntermediaryPlate
OrangeSpurSmall
OrangeSpurLarge
