Zephurah/ME250-103/CAD RMP/111 Pre-made parts/Planetary Gear Box/OrangeStack.SLDASM

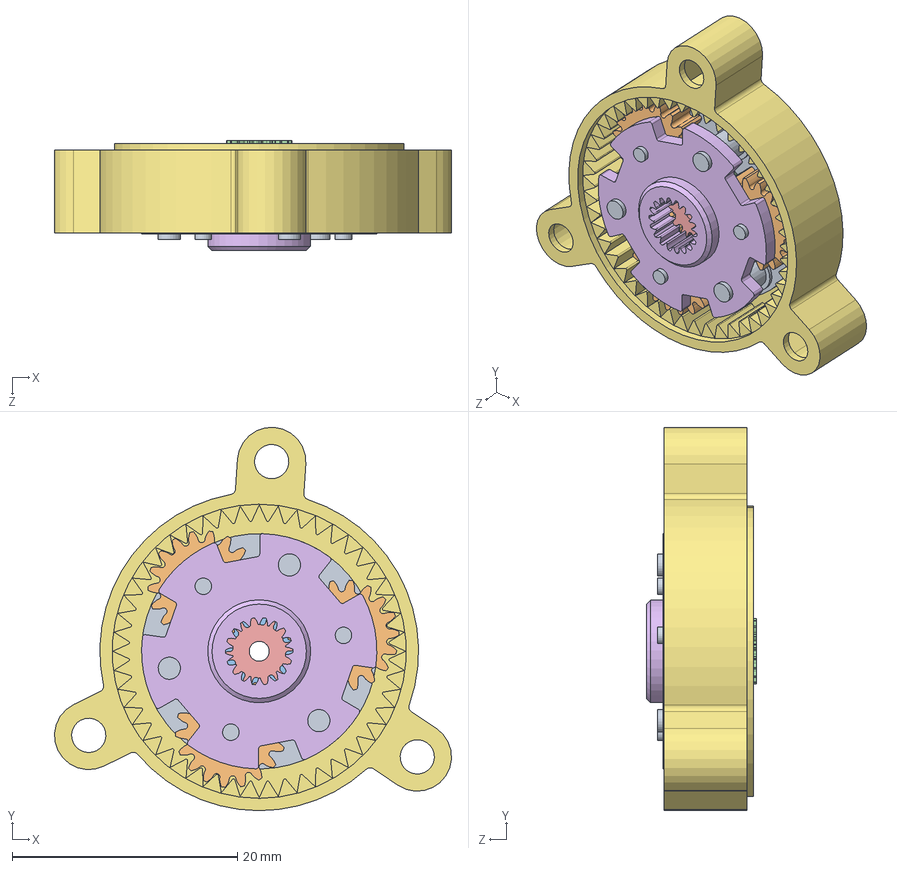
[picture p42: CAD file, 2021-10-25]
CAD RMP/111 Pre-made parts/Planetary Gear Box/OrangeStack.SLDASM
35.3 x 34.1 x 9.79 mm
OrangeArmDisk
OrangePlanetGear x 3
OrangeIntermediaryPlate
OrangeSpurSmall
OrangeSpurLarge
HousingCase
