Zephurah/ME250-103/CAD RMP/Arm/Small L Bracket V2.SLDPRT

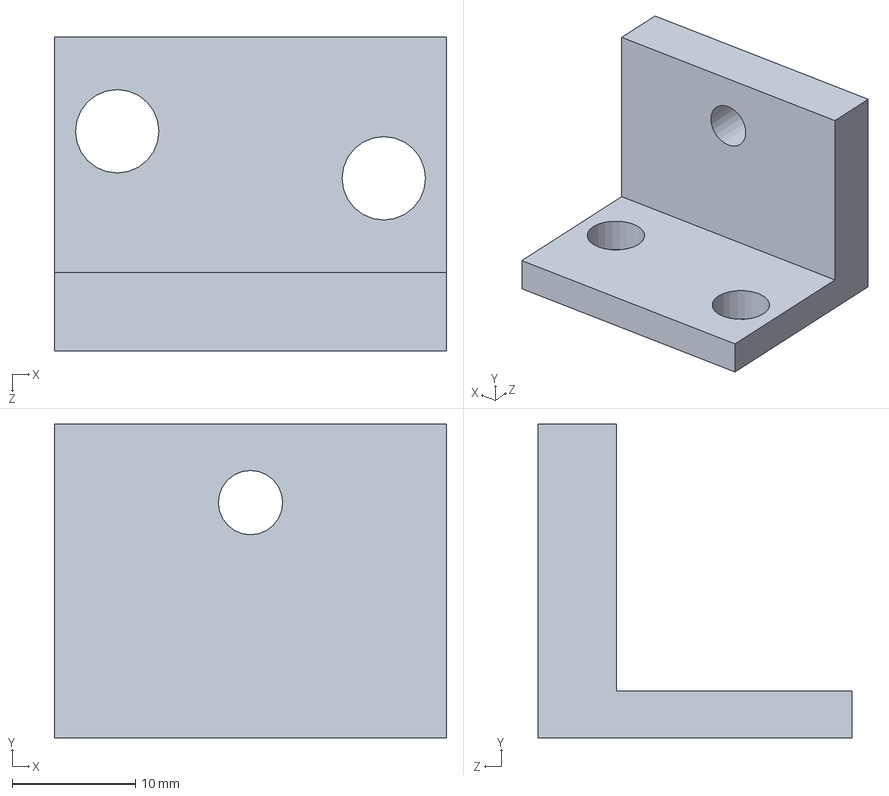
[picture p43: CAD file, 2021-11-22]
CAD RMP/Arm/Small L Bracket V2.SLDPRT
31.8 x 25.4 x 25.4 mm
