Zephurah/ME250-103/CAD RMP/Brush/support.SLDPRT

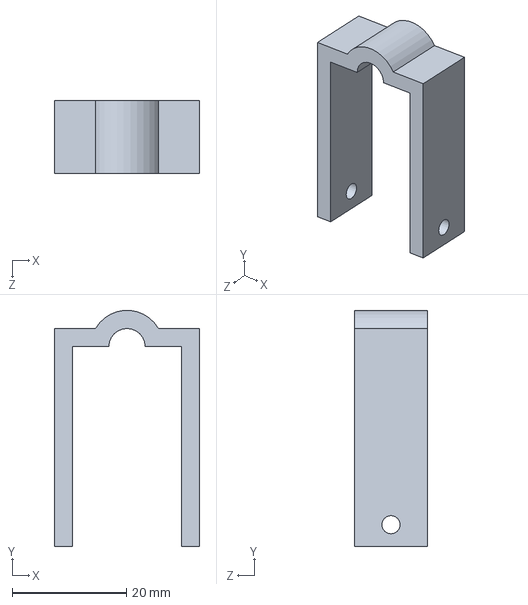
[picture p44: CAD file, 2021-12-02]
CAD RMP/Brush/support.SLDPRT
25.4 x 41.2 x 12.7 mm
