Zephurah/ME250-103/CAD RMP/Frame/New final frame/Bottom frame.SLDPRT

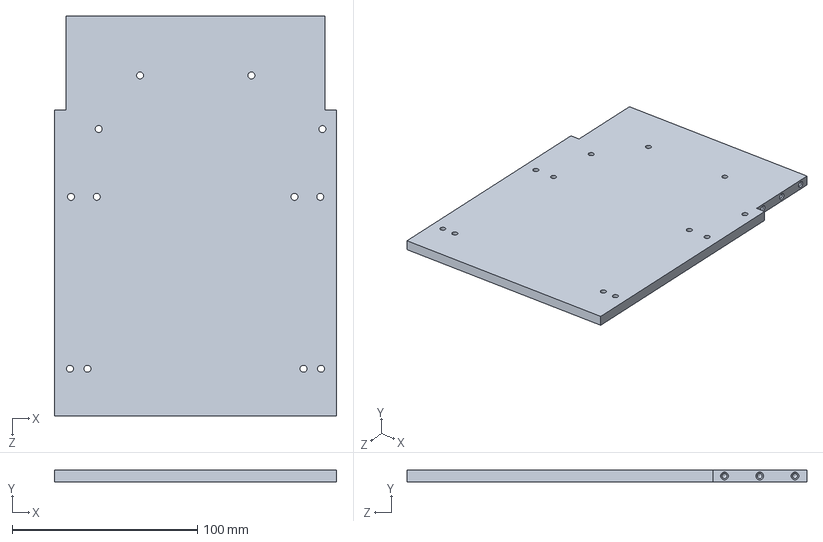
[picture p45: CAD file, 2021-11-24]
CAD RMP/Frame/New final frame/Bottom frame.SLDPRT
152.4 x 6.35 x 215.9 mm
