Zephurah/ME250-103/CAD RMP/MS4/Small parts/.3 X.5 .0625TH L bracket.SLDPRT

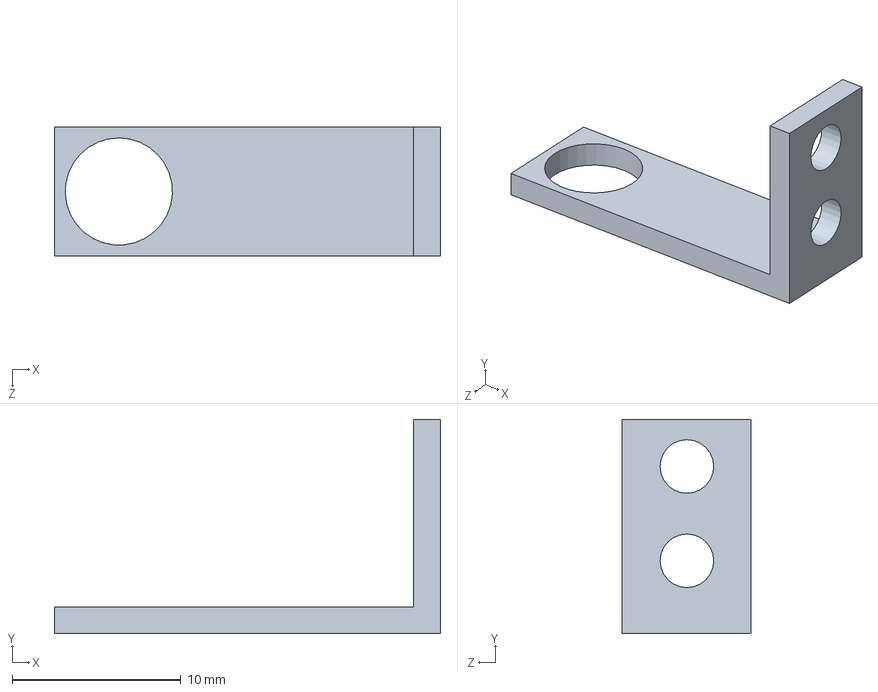
[picture p46: CAD file, 2021-10-25]
CAD RMP/MS4/Small parts/.3 X.5 .0625TH L bracket.SLDPRT
22.9 x 12.7 x 7.62 mm
