Zephurah/ME250-103/CAD RMP/Pre-made parts/Mounting_Examples/.063 Alum Plate.SLDPRT

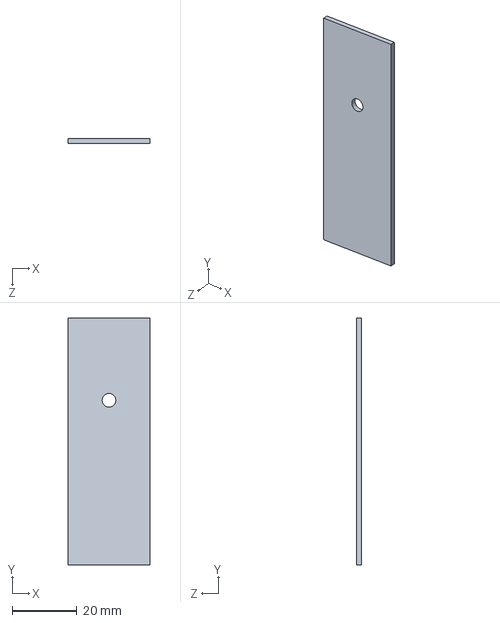
[picture p47: CAD file, 2021-10-25]
CAD RMP/Pre-made parts/Mounting_Examples/.063 Alum Plate.SLDPRT
25.4 x 76.2 x 1.60 mm
