Zephurah/ME250-103/CAD RMP/Project/square bracket.SLDPRT

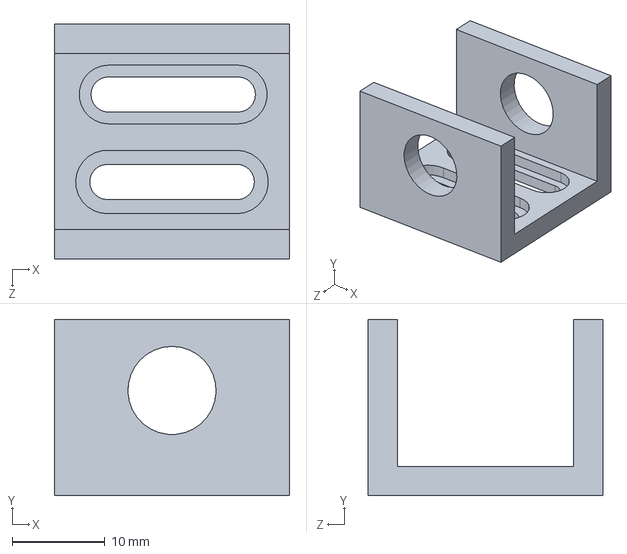
[picture p48: CAD file, 2021-11-12]
CAD RMP/Project/square bracket.SLDPRT
25.4 x 19.1 x 25.4 mm
