Zephurah/ME250-103/CAD RMP/111 Pre-made parts/Metal Motor.SLDPRT

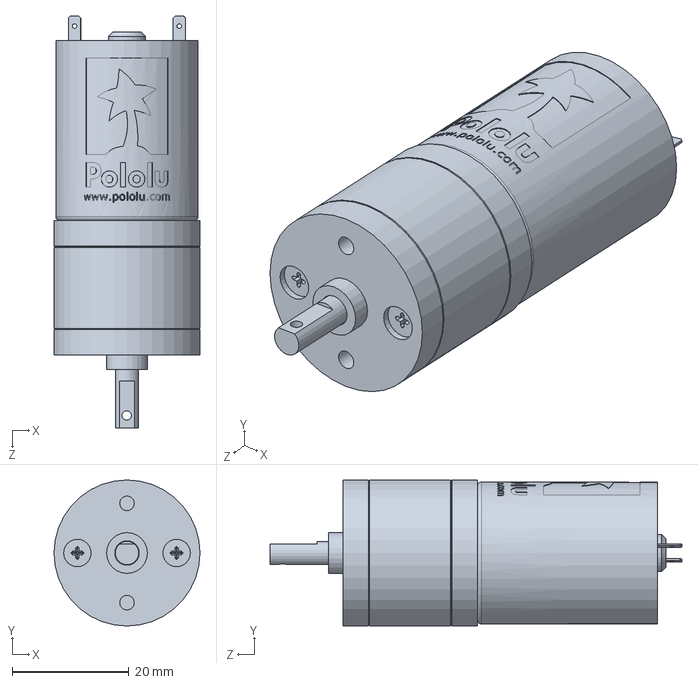
[picture p49: CAD file, 2021-11-04]
CAD RMP/111 Pre-made parts/Metal Motor.SLDPRT
25.0 x 25.0 x 70.5 mm
