Zephurah/ME250-103/CAD RMP/111 Pre-made parts/Planetary Gear Box/TanArmDisk.SLDPRT

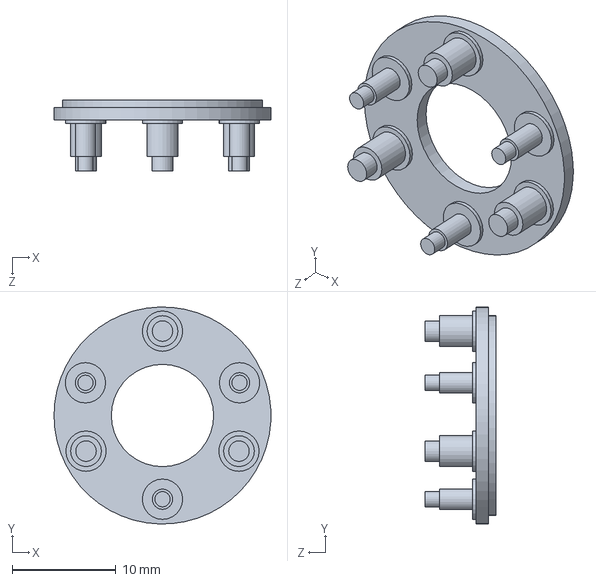
[picture p50: CAD file, 2021-10-25]
CAD RMP/111 Pre-made parts/Planetary Gear Box/TanArmDisk.SLDPRT
20.9 x 20.9 x 6.81 mm
