Zephurah/ME250-103/CAD RMP/Arm/Connecting Shaft.SLDPRT

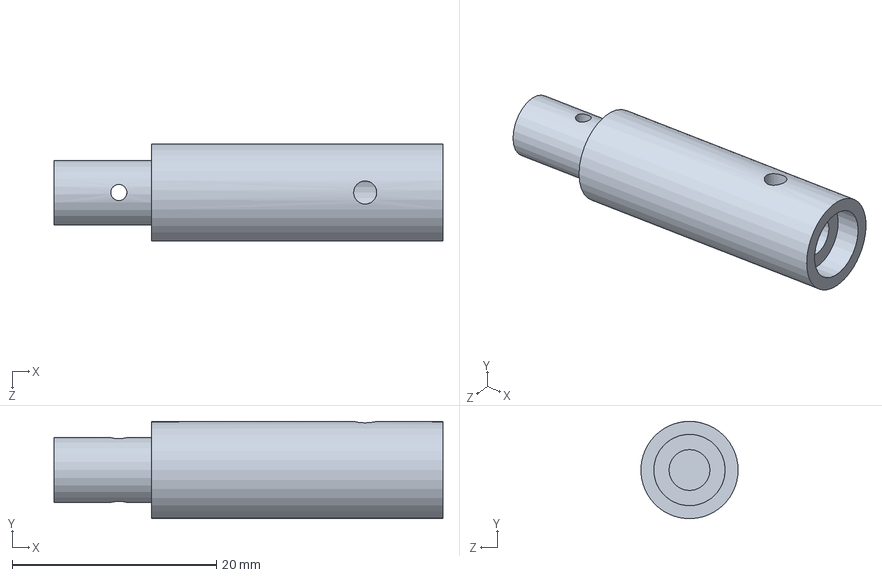
[picture p51: CAD file, 2021-11-22]
CAD RMP/Arm/Connecting Shaft.SLDPRT
38.1 x 9.52 x 9.53 mm
