Zephurah/ME250-103/CAD RMP/Frame/Frame final.SLDPRT

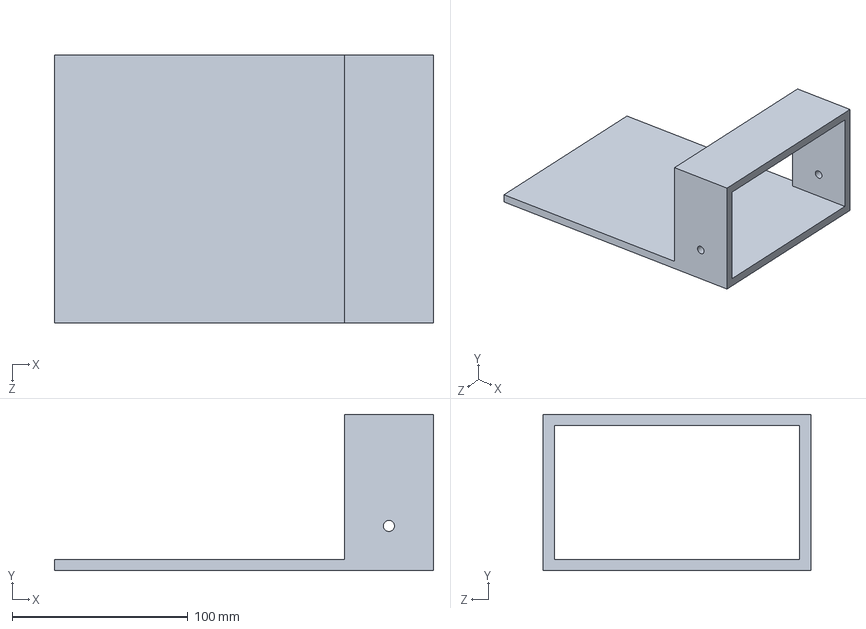
[picture p52: CAD file, 2021-10-25]
CAD RMP/Frame/Frame final.SLDPRT
215.9 x 88.9 x 152.4 mm
