Zephurah/ME250-103/CAD RMP/Wheel Axle/Wheel axle.SLDPRT

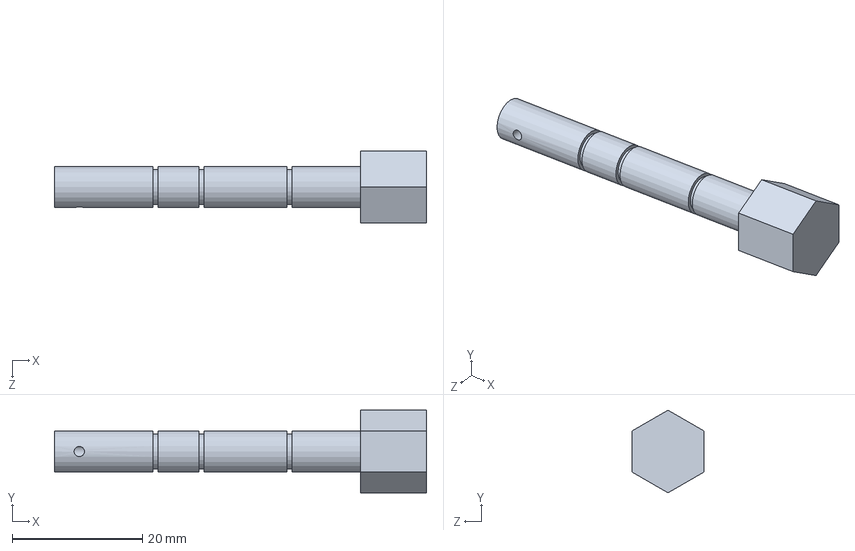
[picture p53: CAD file, 2021-11-29]
CAD RMP/Wheel Axle/Wheel axle.SLDPRT
57.1 x 12.7 x 11.0 mm
