Zephurah/ME250-103/CAD RMP/111 Pre-made parts/Mounting_Examples/Spring Pin.SLDPRT

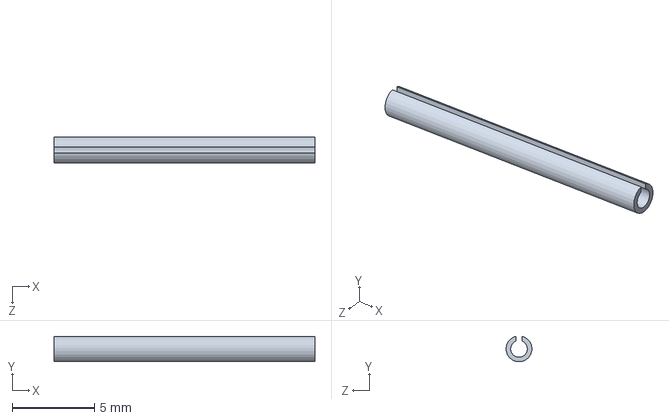
[picture p54: CAD file, 2021-10-28]
CAD RMP/111 Pre-made parts/Mounting_Examples/Spring Pin.SLDPRT
15.9 x 1.55 x 1.57 mm
