Zephurah/ME250-103/CAD RMP/111 Pre-made parts/Planetary Gear Box/OrangeIntermediaryPlate.SLDPRT

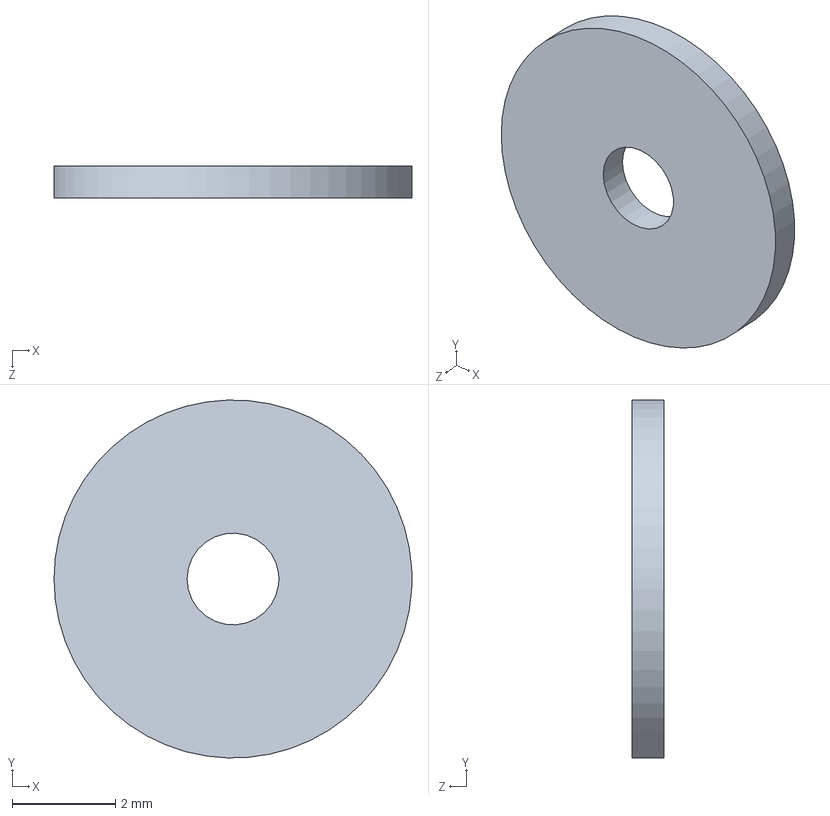
[picture p55: CAD file, 2021-10-25]
CAD RMP/111 Pre-made parts/Planetary Gear Box/OrangeIntermediaryPlate.SLDPRT
6.93 x 6.93 x 0.622 mm
