Zephurah/ME250-103/CAD RMP/Arm/Motor Arm Connecting shaft.SLDPRT

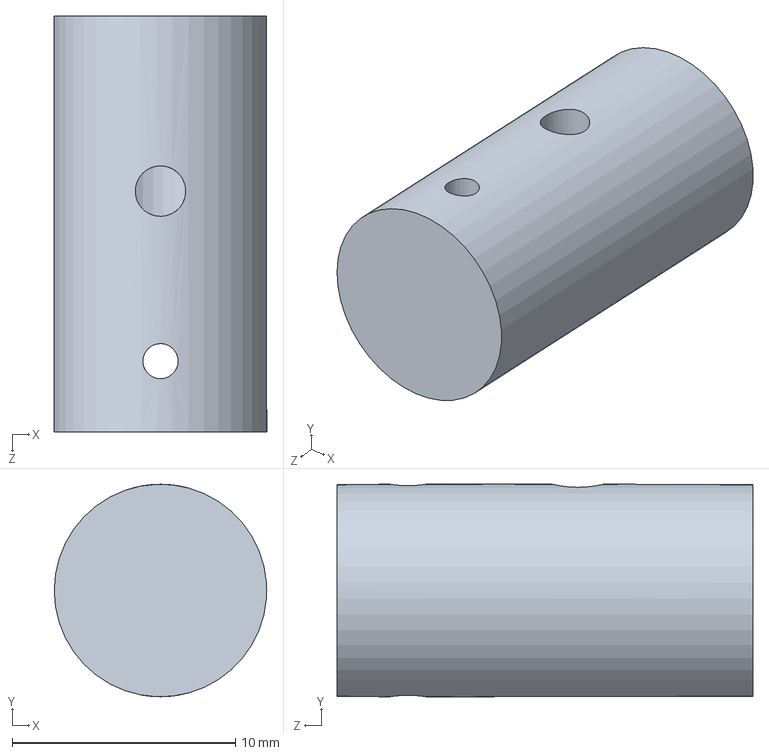
[picture p56: CAD file, 2021-11-22]
CAD RMP/Arm/Motor Arm Connecting shaft.SLDPRT
9.53 x 9.53 x 18.6 mm
