Zephurah/ME250-103/CAD RMP/Brush/Bracket.SLDPRT

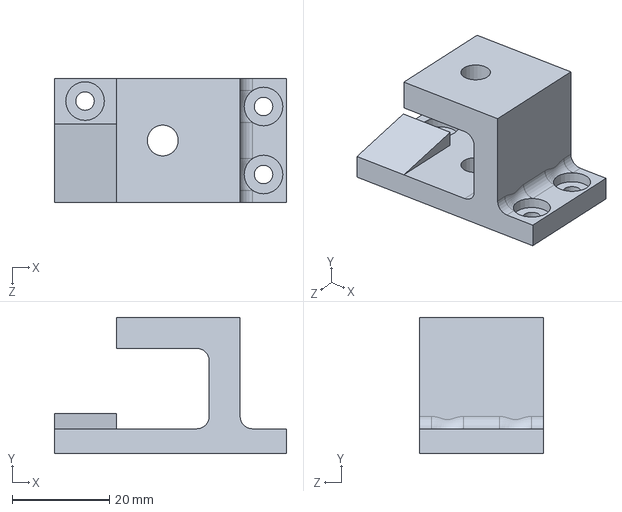
[picture p57: CAD file, 2021-11-09]
CAD RMP/Brush/Bracket.SLDPRT
47.6 x 27.9 x 25.4 mm
