Zephurah/ME250-103/CAD RMP/Frame/New final frame/Side frame.SLDPRT

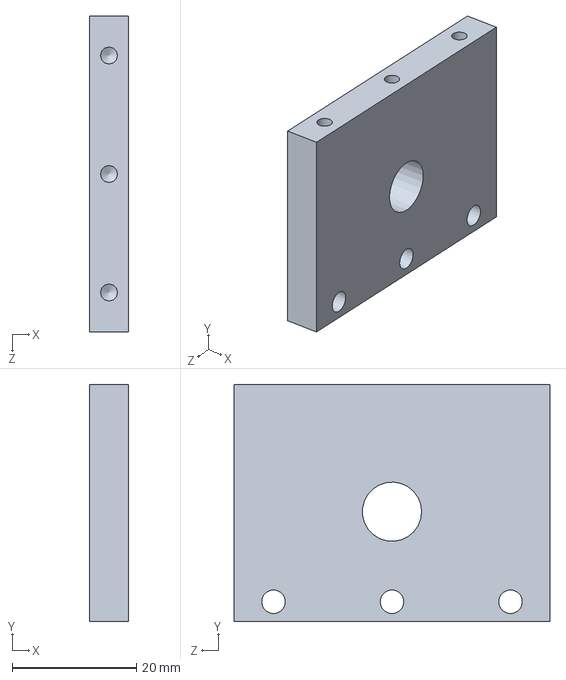
[picture p58: CAD file, 2021-11-09]
CAD RMP/Frame/New final frame/Side frame.SLDPRT
6.35 x 38.1 x 50.8 mm
