Zephurah/ME250-103/CAD RMP/Project/Treads/drive-download-20211011T011059Z-001/RMPTread1.SLDPRT

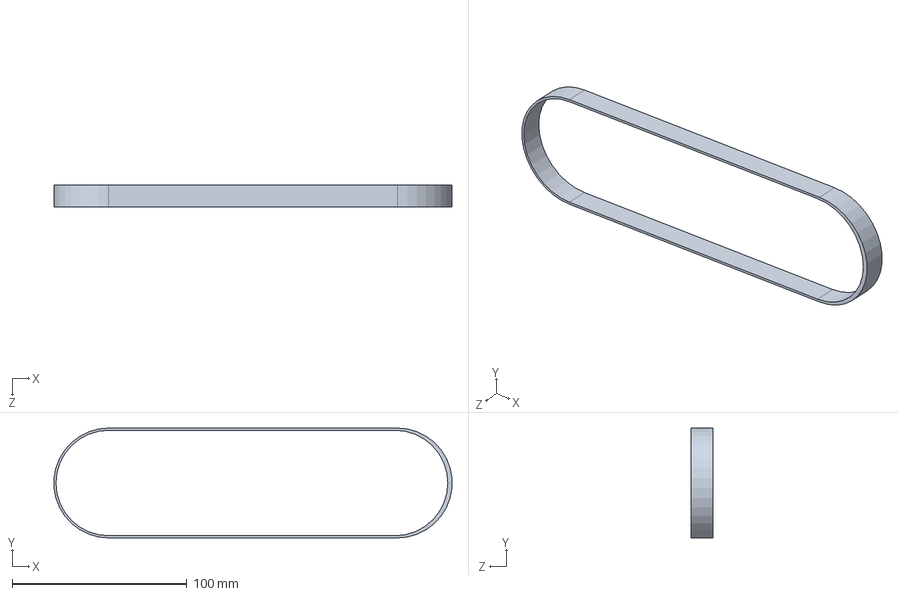
[picture p59: CAD file, 2021-10-25]
CAD RMP/Project/Treads/drive-download-20211011T011059Z-001/RMPTread1.SLDPRT
227.7 x 62.9 x 12.7 mm
