Zephurah/ME250-103/CAD RMP/Treads/RMPtreadV1.SLDPRT

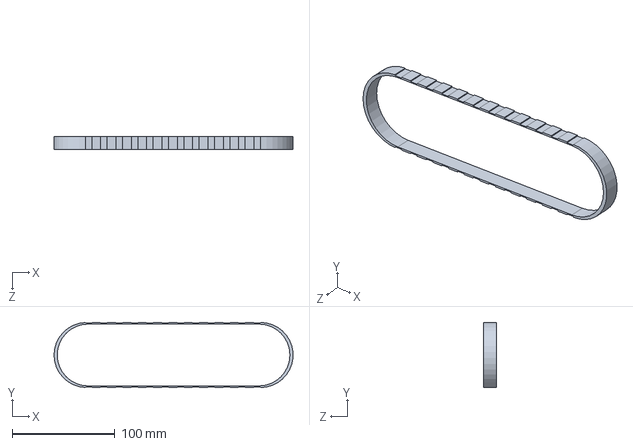
[picture p60: CAD file, 2021-11-06]
CAD RMP/Treads/RMPtreadV1.SLDPRT
233.2 x 63.5 x 12.7 mm
