Zephurah/ME250-103/CAD RMP/Wheel Axle/Back axle.SLDPRT

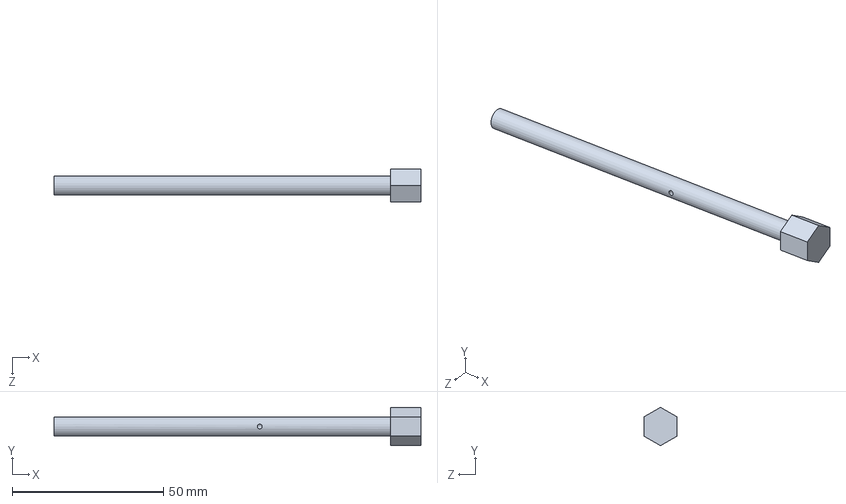
[picture p61: CAD file, 2021-11-09]
CAD RMP/Wheel Axle/Back axle.SLDPRT
121.4 x 12.7 x 11.0 mm
