Zephurah/ME250-103/CAD RMP/111 Pre-made parts/Mounting_Examples/Wheel for Slotbot.SLDPRT

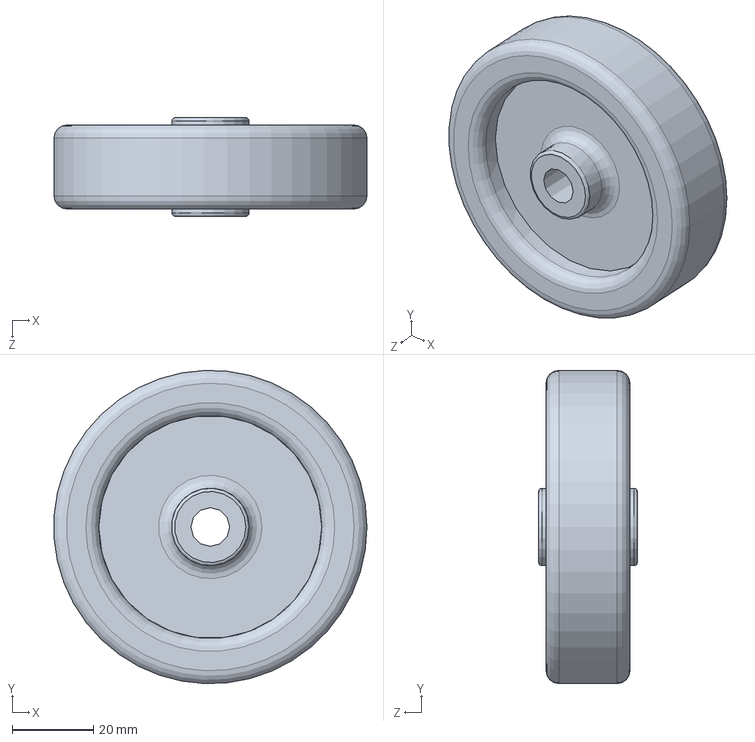
[picture p62: CAD file, 2021-10-25]
CAD RMP/111 Pre-made parts/Mounting_Examples/Wheel for Slotbot.SLDPRT
76.9 x 76.9 x 24.3 mm
