Zephurah/ME250-103/CAD RMP/111 Pre-made parts/Planetary Gear Box/M3Nut.SLDPRT

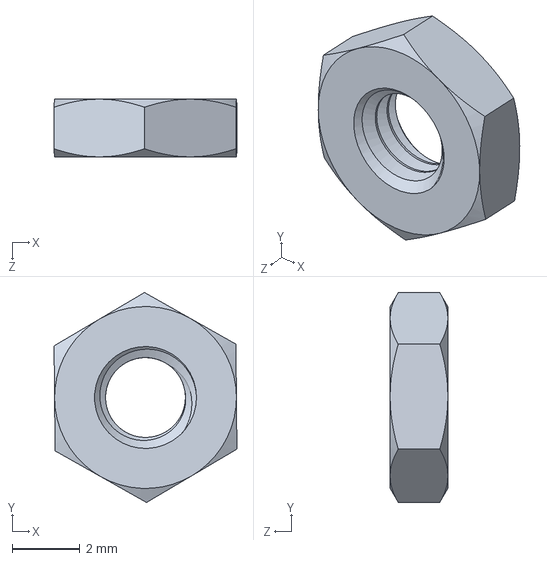
[picture p63: CAD file, 2021-10-25]
CAD RMP/111 Pre-made parts/Planetary Gear Box/M3Nut.SLDPRT
5.38 x 6.18 x 1.70 mm
