Zephurah/ME250-103/CAD RMP/Brush/Brush.SLDPRT

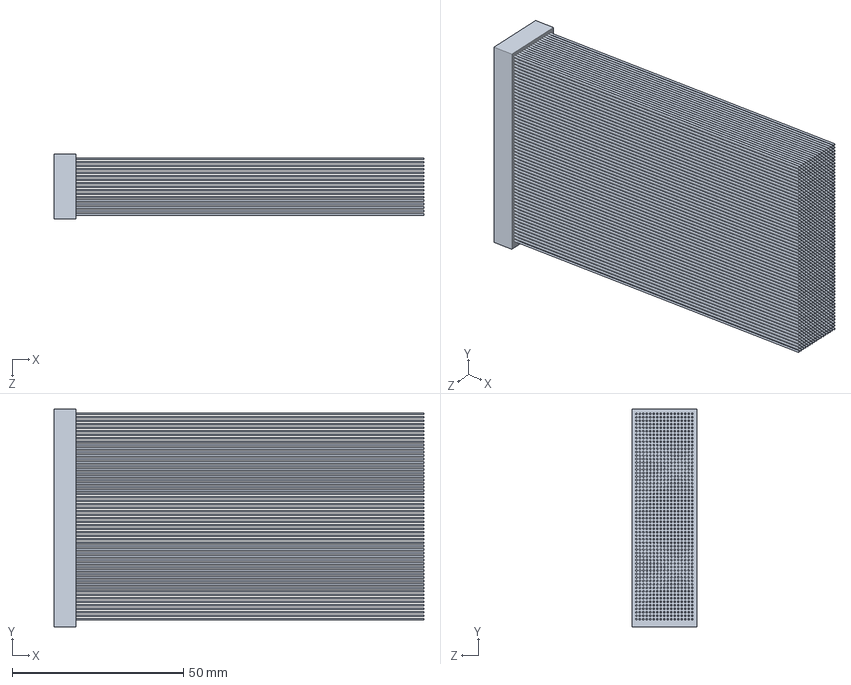
[picture p64: CAD file, 2021-11-06]
CAD RMP/Brush/Brush.SLDPRT
108.0 x 63.5 x 19.1 mm
