Zephurah/ME250-103/CAD RMP/Frame/New final frame/Top frame.SLDPRT

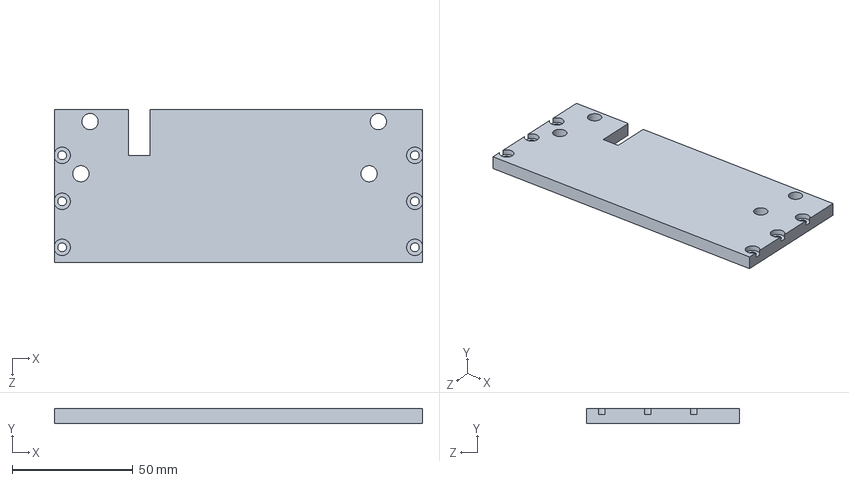
[picture p65: CAD file, 2021-11-06]
CAD RMP/Frame/New final frame/Top frame.SLDPRT
152.4 x 6.35 x 63.5 mm
