Zephurah/ME250-103/CAD RMP/Project/Treads/drive-download-20211011T011059Z-001/RMPWheel1.SLDPRT

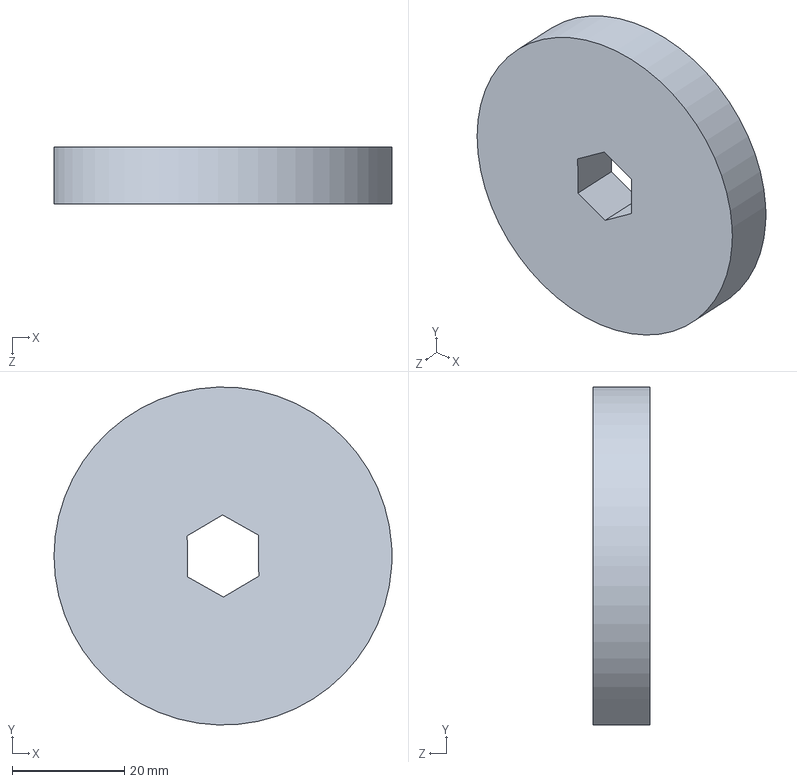
[picture p66: CAD file, 2021-10-25]
CAD RMP/Project/Treads/drive-download-20211011T011059Z-001/RMPWheel1.SLDPRT
60.3 x 60.3 x 10.2 mm
