Zephurah/ME250-103/CAD RMP/111 Pre-made parts/New Control Box rough dimensions.SLDPRT

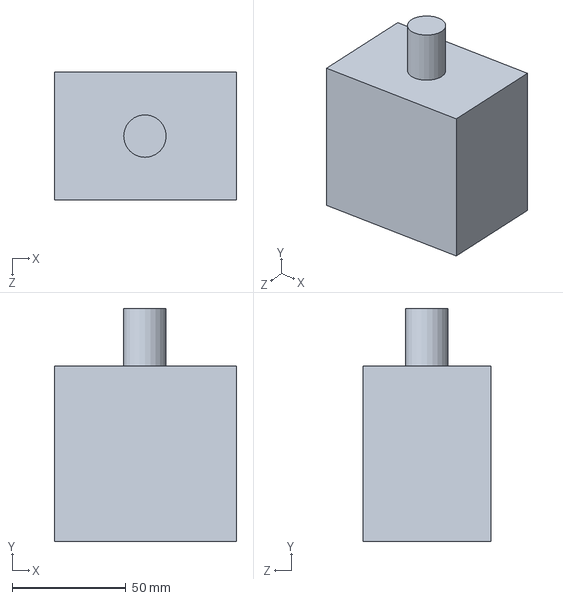
[picture p67: CAD file, 2021-11-02]
CAD RMP/111 Pre-made parts/New Control Box rough dimensions.SLDPRT
80.3 x 102.6 x 56.4 mm
