Zephurah/ME250-103/CAD RMP/111 Pre-made parts/Planetary Gear Box/DriveDiskJoint.SLDPRT

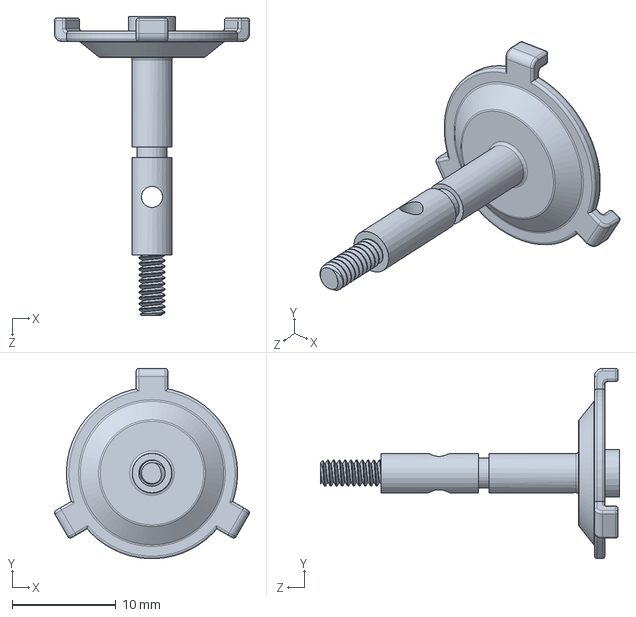
[picture p68: CAD file, 2021-10-25]
CAD RMP/111 Pre-made parts/Planetary Gear Box/DriveDiskJoint.SLDPRT
18.8 x 18.3 x 28.8 mm
