Zephurah/ME250-103/CAD RMP/Brush/Locking pin.SLDPRT

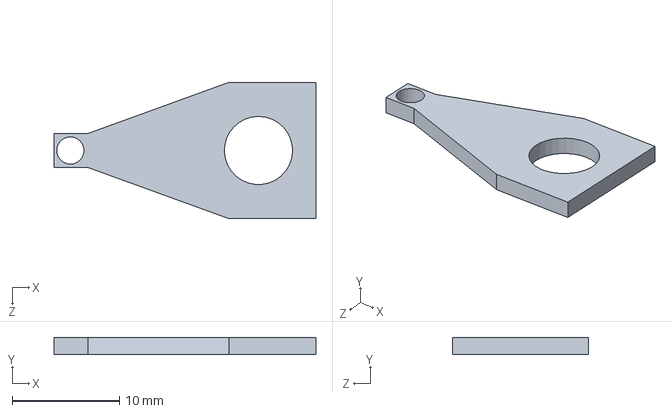
[picture p69: CAD file, 2021-11-01]
CAD RMP/Brush/Locking pin.SLDPRT
24.4 x 1.59 x 12.7 mm
