Zephurah/ME250-103/CAD RMP/111 Pre-made parts/Planetary Gear Box/TanPlanetGear.SLDPRT

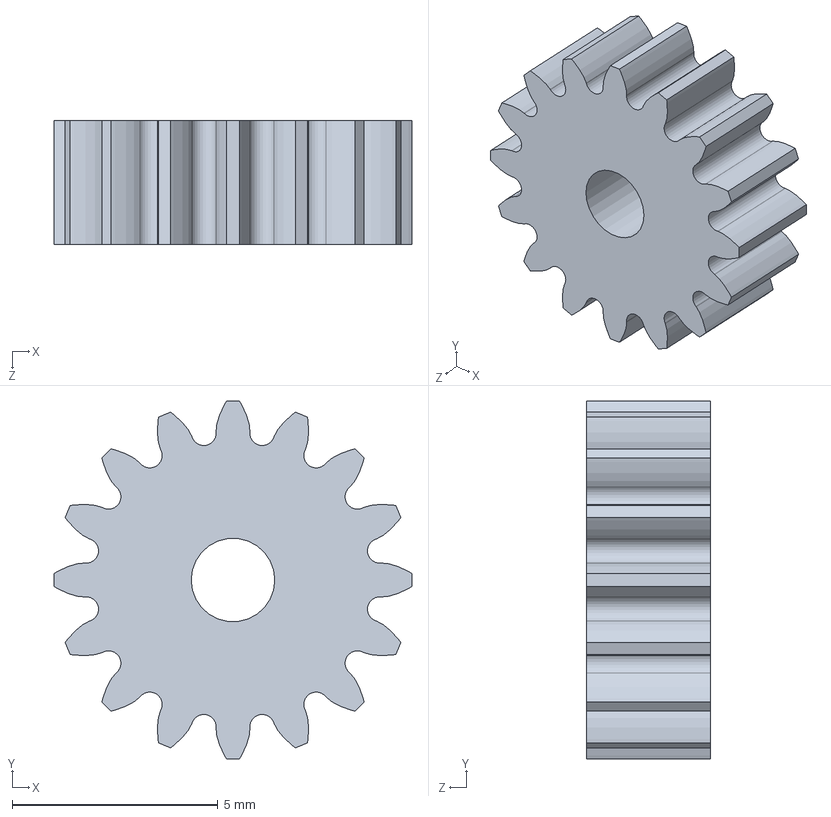
[picture p70: CAD file, 2021-10-25]
CAD RMP/111 Pre-made parts/Planetary Gear Box/TanPlanetGear.SLDPRT
8.71 x 8.71 x 3.01 mm
