Zephurah/ME250-103/CAD RMP/Brush/Brush arm bracket mirrored.SLDPRT

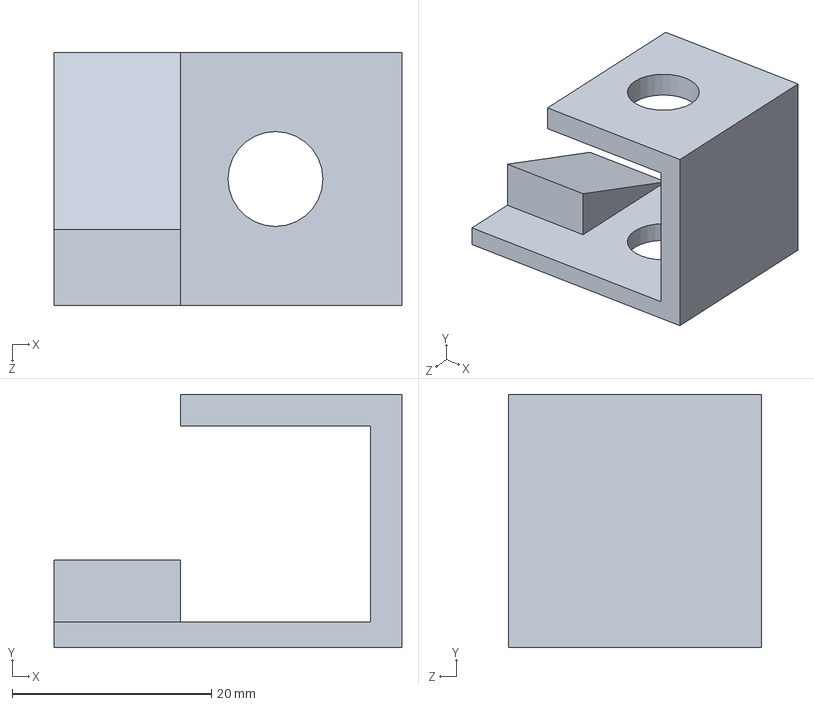
[picture p71: CAD file, 2021-11-01]
CAD RMP/Brush/Brush arm bracket mirrored.SLDPRT
34.9 x 25.4 x 25.4 mm
