Zephurah/ME250-103/CAD RMP/Project/Axle and Brush Bracket.SLDPRT

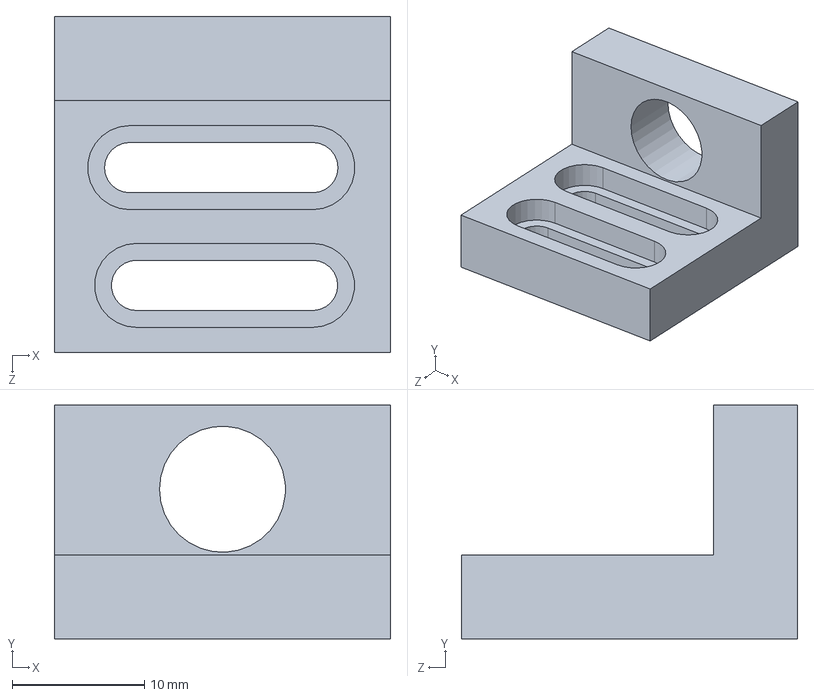
[picture p72: CAD file, 2021-11-05]
CAD RMP/Project/Axle and Brush Bracket.SLDPRT
25.4 x 17.7 x 25.4 mm
