Zephurah/ME250-103/CAD RMP/Wheel Axle/motor shaft.SLDPRT

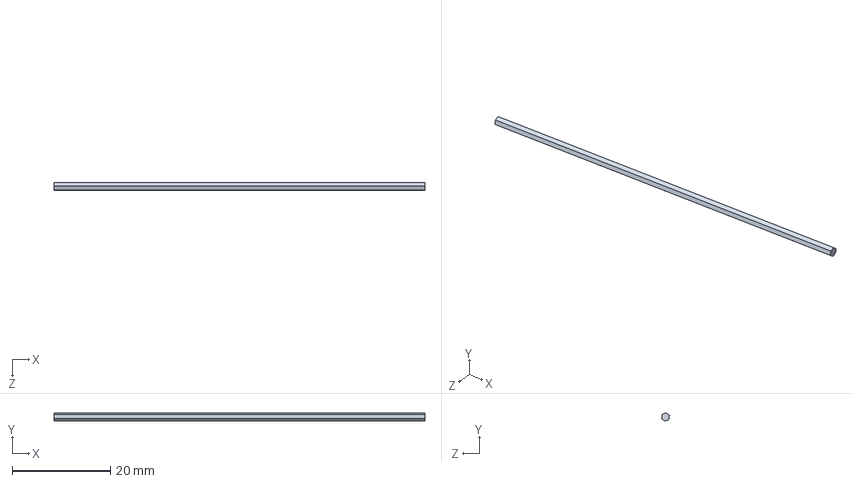
[picture p73: CAD file, 2021-11-05]
CAD RMP/Wheel Axle/motor shaft.SLDPRT
75.4 x 1.72 x 1.59 mm
