Zephurah/ME250-103/CAD RMP/111 Pre-made parts/Planetary Gear Box/OutletCase.SLDPRT

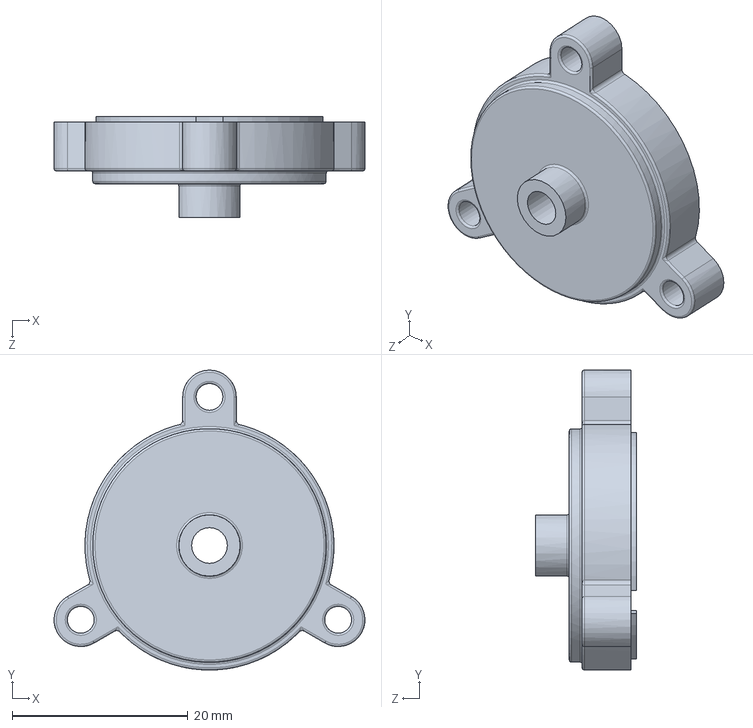
[picture p74: CAD file, 2021-10-25]
CAD RMP/111 Pre-made parts/Planetary Gear Box/OutletCase.SLDPRT
35.4 x 34.1 x 11.4 mm
