Zephurah/ME250-103/CAD RMP/Arm/Motor Bracket.SLDPRT

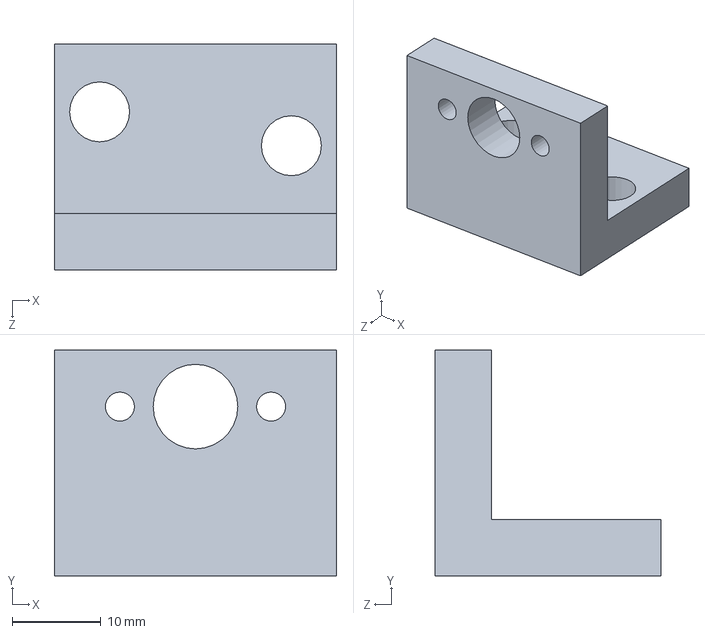
[picture p75: CAD file, 2021-11-04]
CAD RMP/Arm/Motor Bracket.SLDPRT
31.8 x 25.4 x 25.4 mm
