Zephurah/ME250-103/CAD RMP/Brush/1-4 bushing.SLDPRT

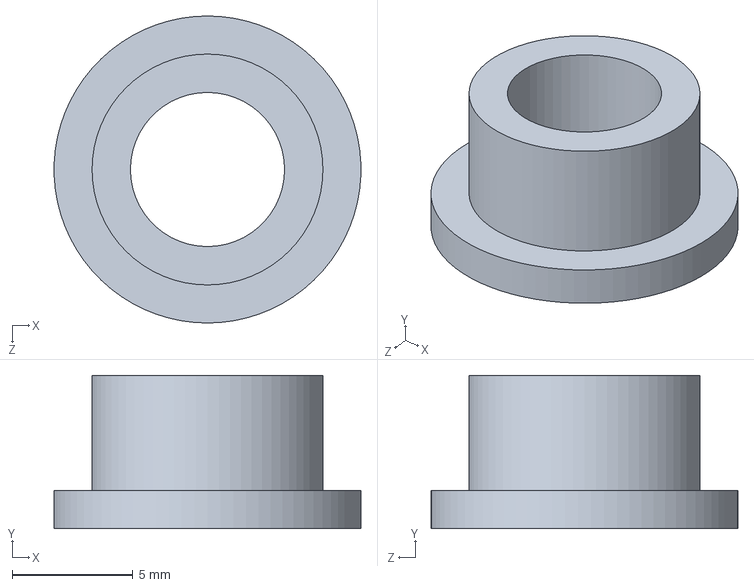
[picture p76: CAD file, 2021-10-25]
CAD RMP/Brush/1-4 bushing.SLDPRT
12.7 x 6.35 x 12.7 mm
