Zephurah/ME250-103/CAD RMP/Project/Small L Backet.SLDPRT

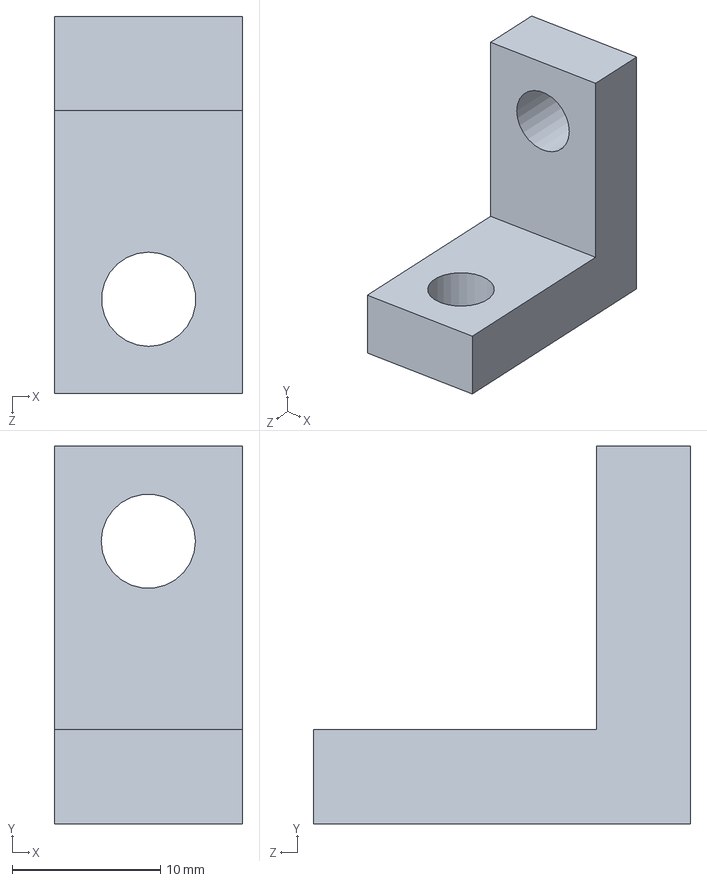
[picture p77: CAD file, 2021-10-27]
CAD RMP/Project/Small L Backet.SLDPRT
12.7 x 25.5 x 25.4 mm
