Zephurah/ME250-103/CAD RMP/Treads/Axle.SLDPRT

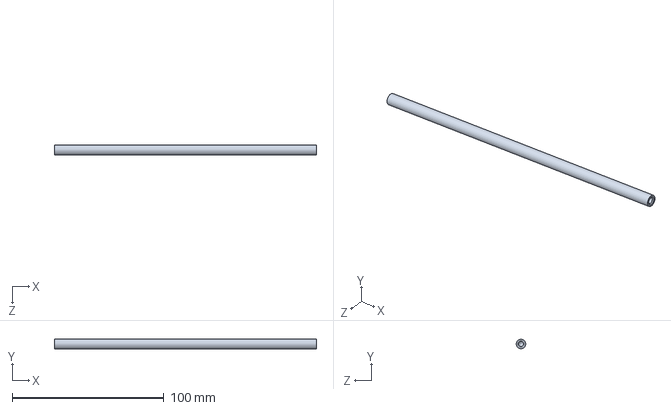
[picture p78: CAD file, 2021-10-25]
CAD RMP/Treads/Axle.SLDPRT
172.7 x 6.35 x 6.35 mm
