Zephurah/ME250-103/CAD RMP/111 Pre-made parts/Planetary Gear Box/OrangePlanetGear.SLDPRT

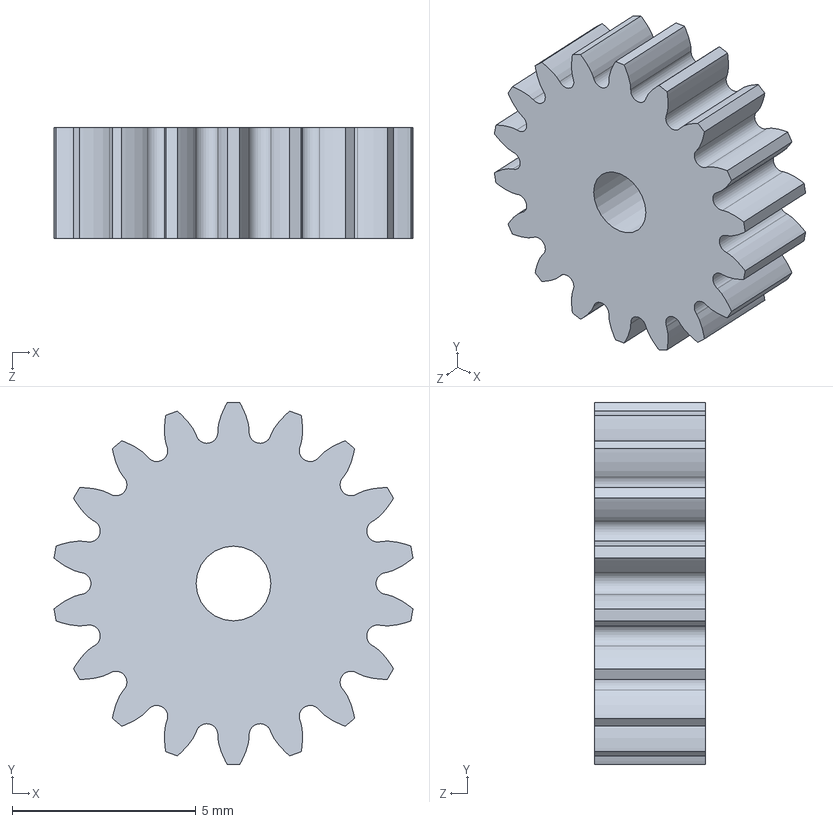
[picture p79: CAD file, 2021-10-25]
CAD RMP/111 Pre-made parts/Planetary Gear Box/OrangePlanetGear.SLDPRT
9.76 x 9.85 x 3.01 mm
