Zephurah/ME250-103/CAD RMP/Arm/lever Bar.SLDPRT

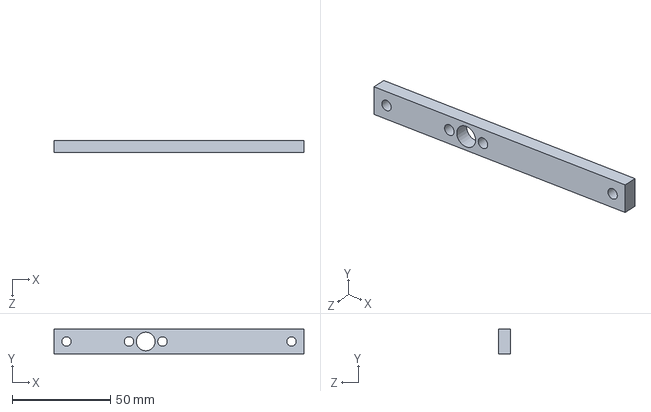
[picture p80: CAD file, 2021-11-01]
CAD RMP/Arm/lever Bar.SLDPRT
127.0 x 12.7 x 6.35 mm
