Zephurah/ME250-103/CAD RMP/Project/Control Box.SLDPRT

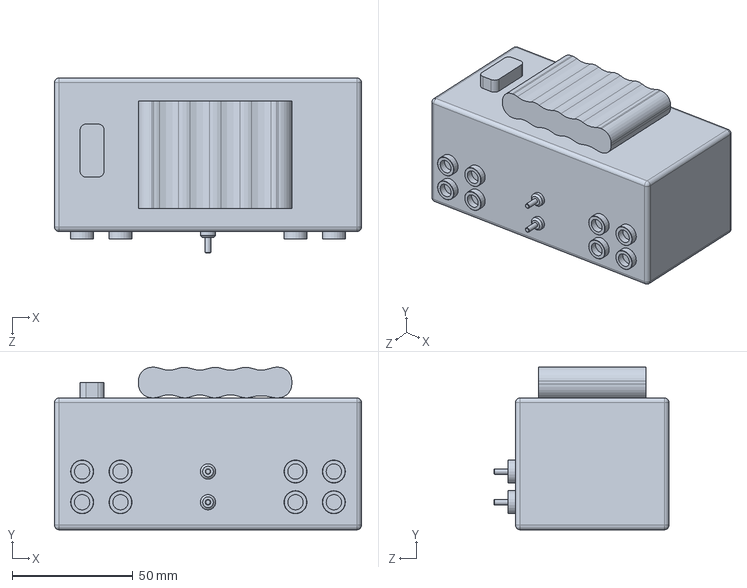
[picture p81: CAD file, 2021-10-25]
CAD RMP/Project/Control Box.SLDPRT
127.0 x 67.3 x 72.4 mm
