Zephurah/ME250-103/CAD RMP/111 Pre-made parts/Mounting_Examples/Bushing Mount 2.SLDPRT

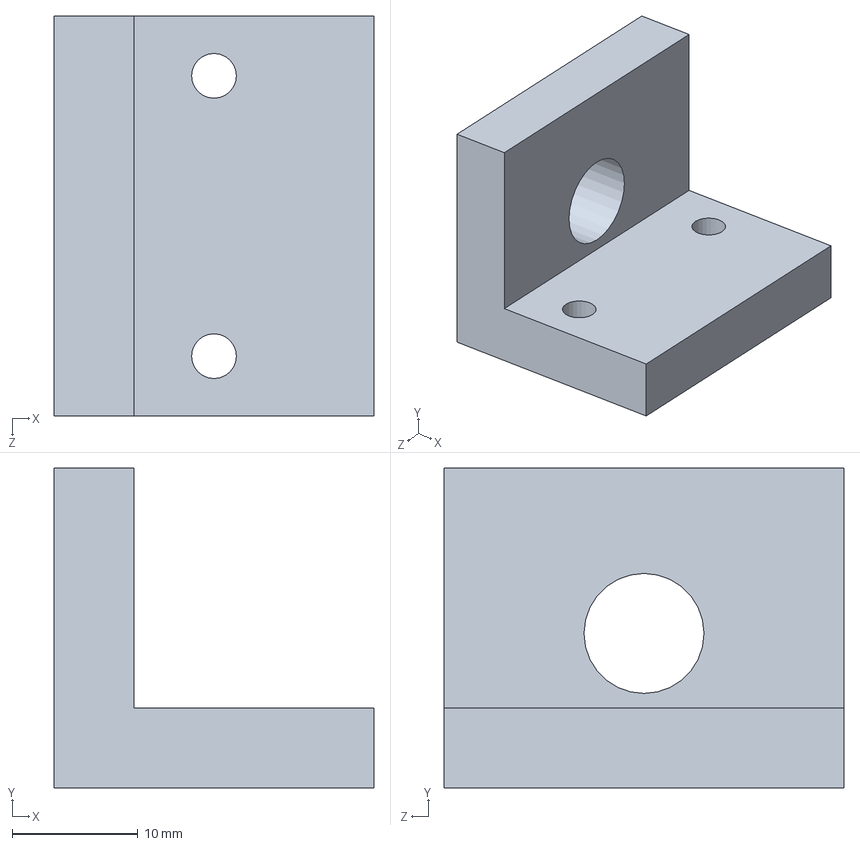
[picture p82: CAD file, 2021-10-25]
CAD RMP/111 Pre-made parts/Mounting_Examples/Bushing Mount 2.SLDPRT
25.4 x 25.4 x 31.8 mm
