Zephurah/ME250-103/CAD RMP/111 Pre-made parts/Planetary Gear Box/SingleHorn.SLDPRT

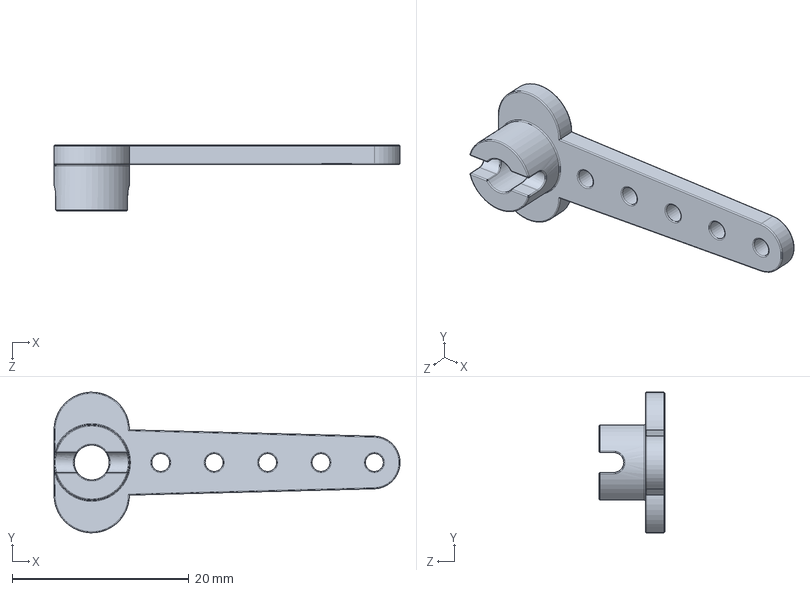
[picture p83: CAD file, 2021-10-25]
CAD RMP/111 Pre-made parts/Planetary Gear Box/SingleHorn.SLDPRT
39.2 x 15.9 x 7.44 mm
