Zephurah/ME250-103/CAD RMP/Arm/lever Bar(DRIVING).SLDPRT

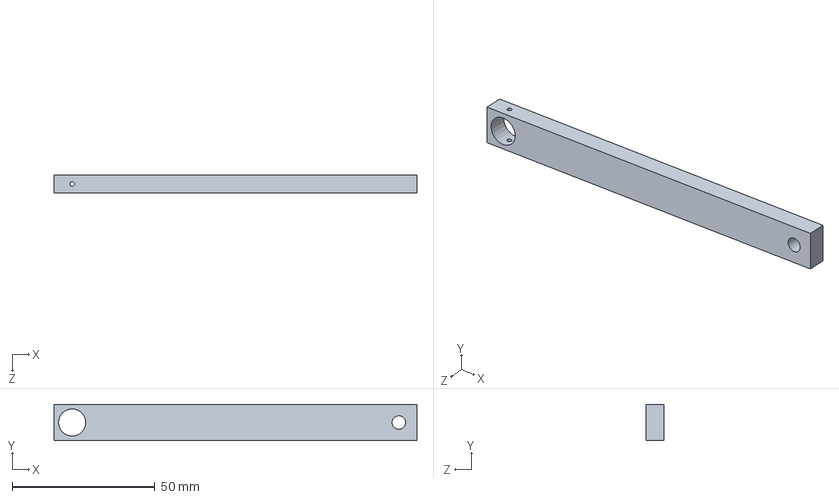
[picture p84: CAD file, 2021-10-27]
CAD RMP/Arm/lever Bar(DRIVING).SLDPRT
127.0 x 12.7 x 6.35 mm
