Zephurah/ME250-103/CAD RMP/Project/Frame final.SLDPRT

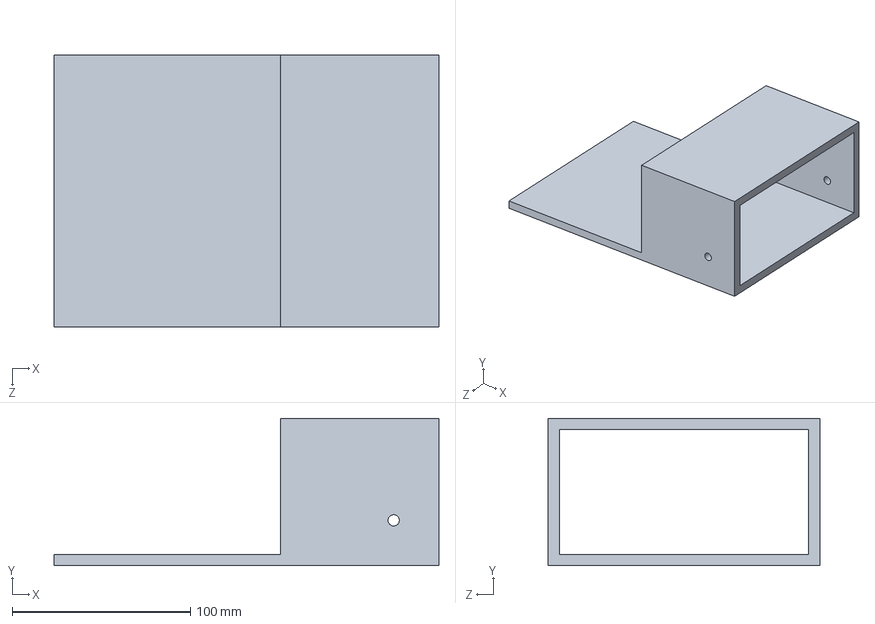
[picture p85: CAD file, 2021-10-25]
CAD RMP/Project/Frame final.SLDPRT
215.9 x 82.5 x 152.4 mm
