Zephurah/ME250-103/CAD RMP/Arm/String Winder.SLDPRT

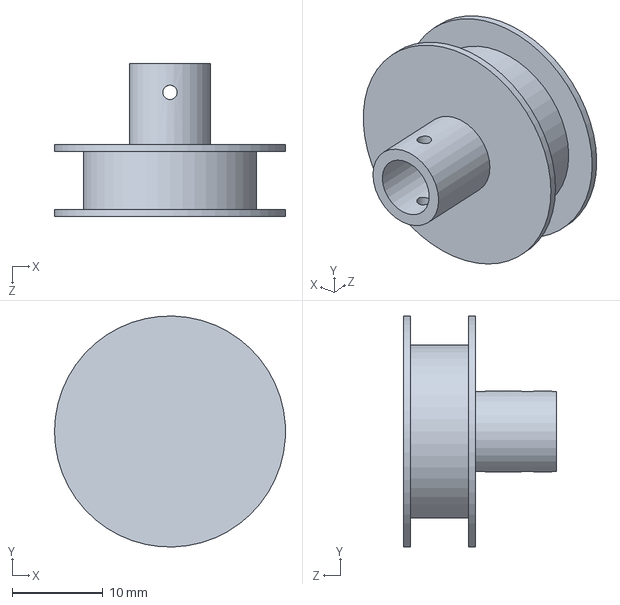
[picture p86: CAD file, 2021-10-26]
CAD RMP/Arm/String Winder.SLDPRT
25.4 x 25.4 x 16.8 mm
