Zephurah/ME250-103/CAD RMP/Project/Gear Motor.SLDPRT

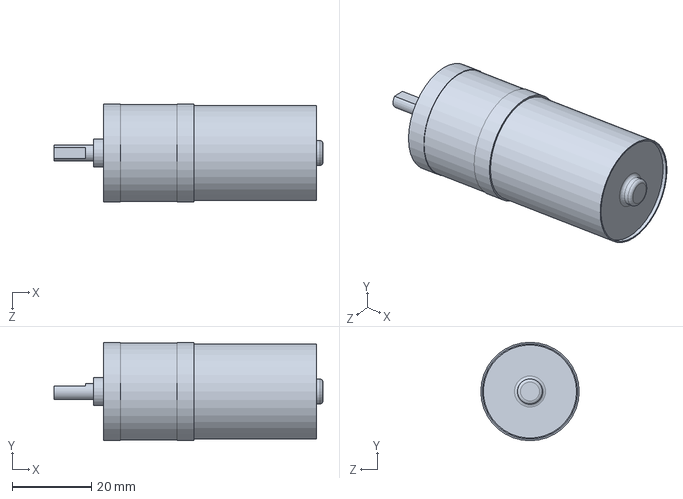
[picture p87: CAD file, 2021-10-25]
CAD RMP/Project/Gear Motor.SLDPRT
68.0 x 24.9 x 24.9 mm
