Zephurah/ME250-103/CAD RMP/111 Pre-made parts/Banebot rubber wheel.SLDPRT

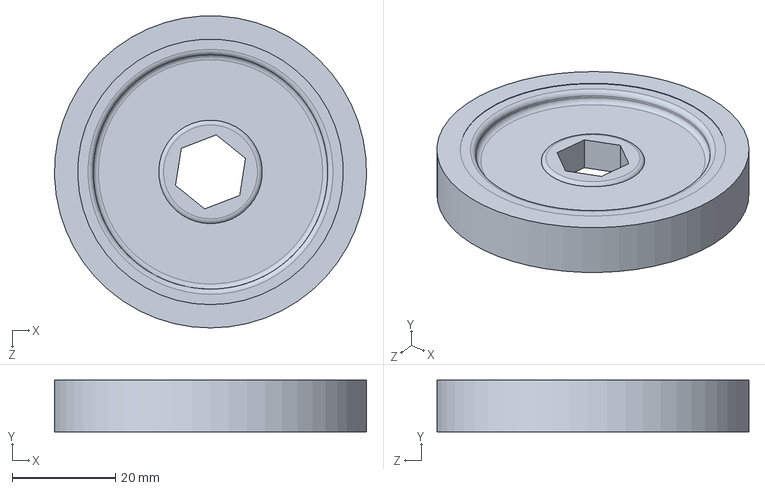
[picture p88: CAD file, 2021-10-25]
CAD RMP/111 Pre-made parts/Banebot rubber wheel.SLDPRT
60.3 x 10.0 x 60.3 mm
