Zephurah/ME250-103/CAD RMP/111 Pre-made parts/Mounting_Examples/Sample Gear Shaft.SLDPRT

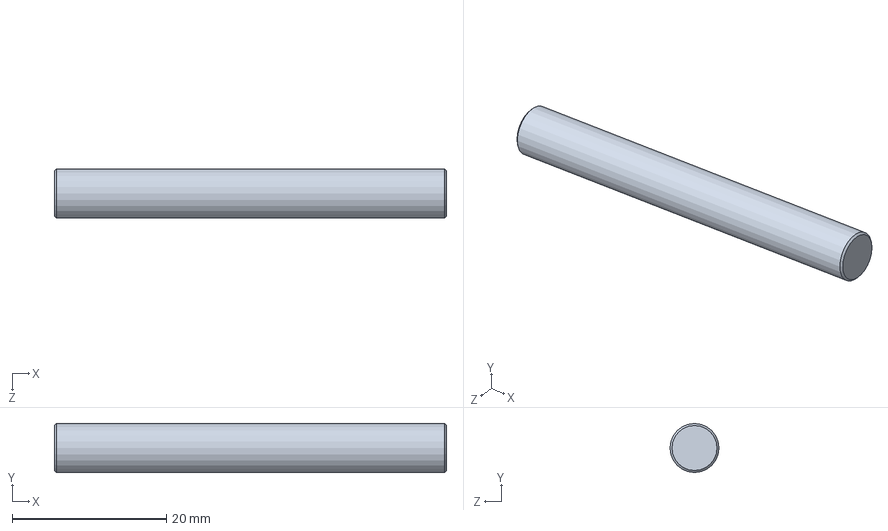
[picture p89: CAD file, 2021-10-25]
CAD RMP/111 Pre-made parts/Mounting_Examples/Sample Gear Shaft.SLDPRT
50.8 x 6.35 x 6.35 mm
