Zephurah/ME250-103/CAD RMP/111 Pre-made parts/Planetary Gear Box/TanSpurSmall.SLDPRT

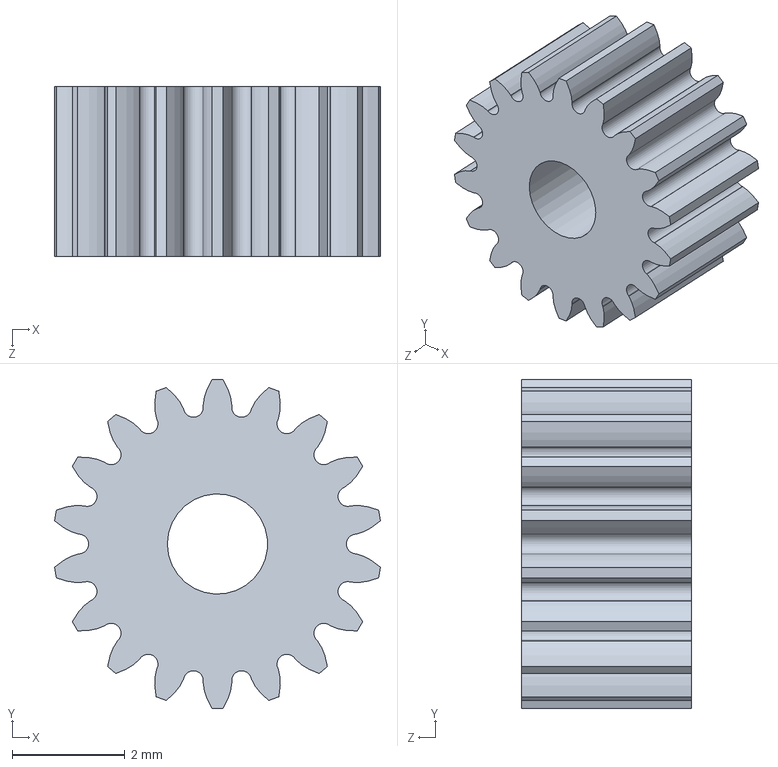
[picture p90: CAD file, 2021-10-25]
CAD RMP/111 Pre-made parts/Planetary Gear Box/TanSpurSmall.SLDPRT
5.78 x 5.84 x 3.01 mm
