Zephurah/ME250-103/CAD RMP/Arm/Scooper.SLDPRT

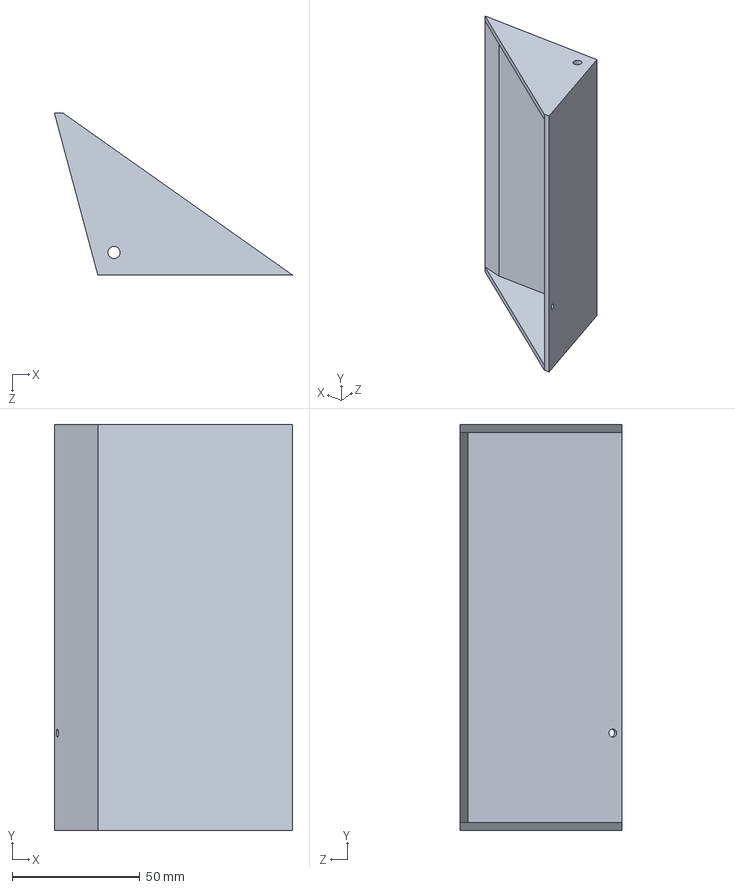
[picture p91: CAD file, 2021-10-25]
CAD RMP/Arm/Scooper.SLDPRT
93.2 x 158.8 x 63.5 mm
