Zephurah/ME250-103/CAD RMP/Project/Gear Axel.SLDPRT

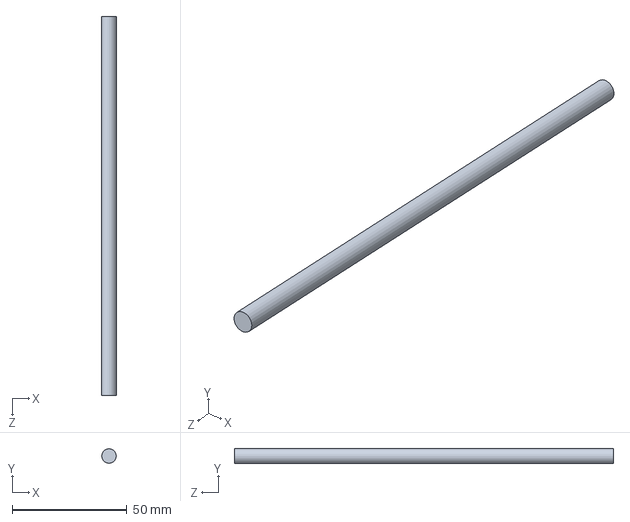
[picture p92: CAD file, 2021-10-25]
CAD RMP/Project/Gear Axel.SLDPRT
6.35 x 6.35 x 165.1 mm
