Zephurah/ME250-103/CAD RMP/111 Pre-made parts/Mounting_Examples/Gear Rack Example.SLDPRT

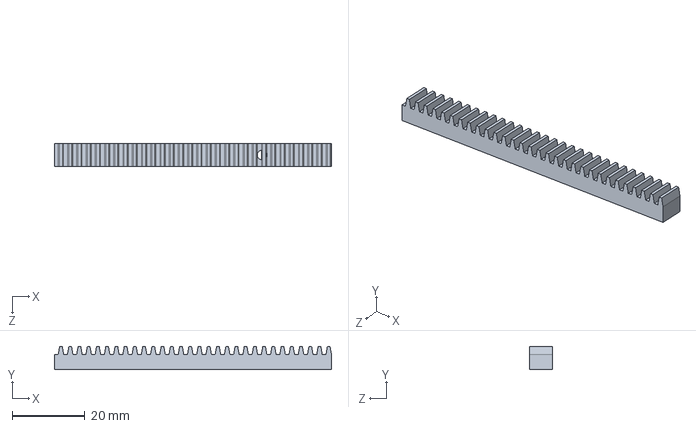
[picture p93: CAD file, 2021-10-25]
CAD RMP/111 Pre-made parts/Mounting_Examples/Gear Rack Example.SLDPRT
76.2 x 6.35 x 6.35 mm
