Zephurah/ME250-103/CAD RMP/111 Pre-made parts/Cube.SLDPRT

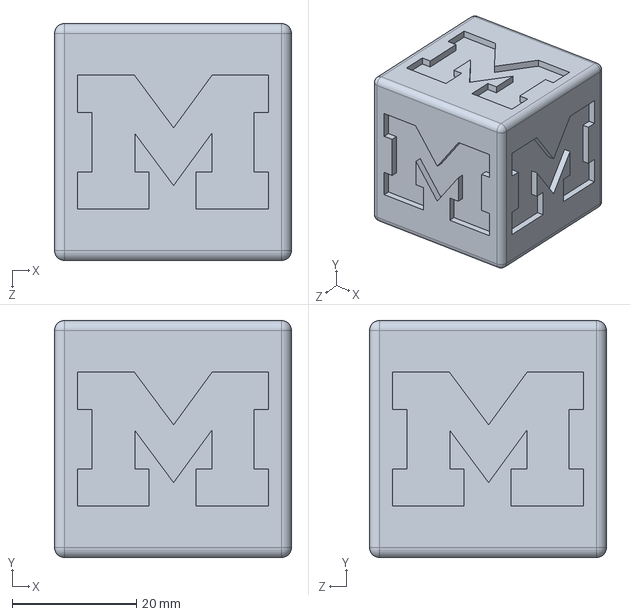
[picture p94: CAD file, 2021-10-25]
CAD RMP/111 Pre-made parts/Cube.SLDPRT
38.1 x 38.1 x 38.1 mm
