Zephurah/ME250-103/CAD RMP/Project/Gear 1.SLDPRT

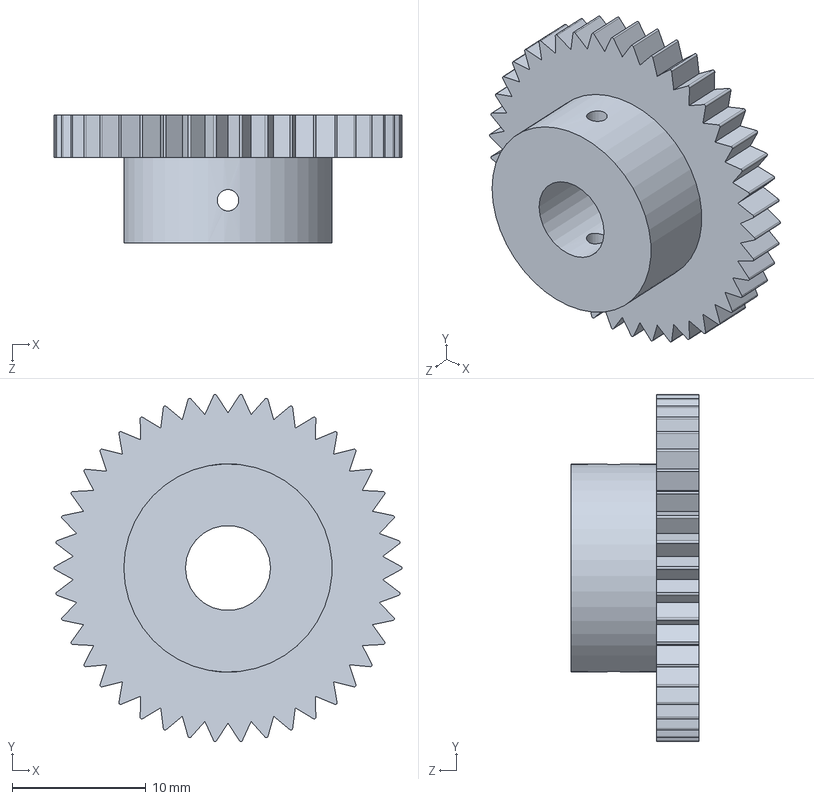
[picture p95: CAD file, 2021-10-25]
CAD RMP/Project/Gear 1.SLDPRT
26.0 x 25.9 x 9.53 mm
