Zephurah/ME250-103/CAD RMP/111 Pre-made parts/Mounting_Examples/Connecting Shaft.SLDPRT

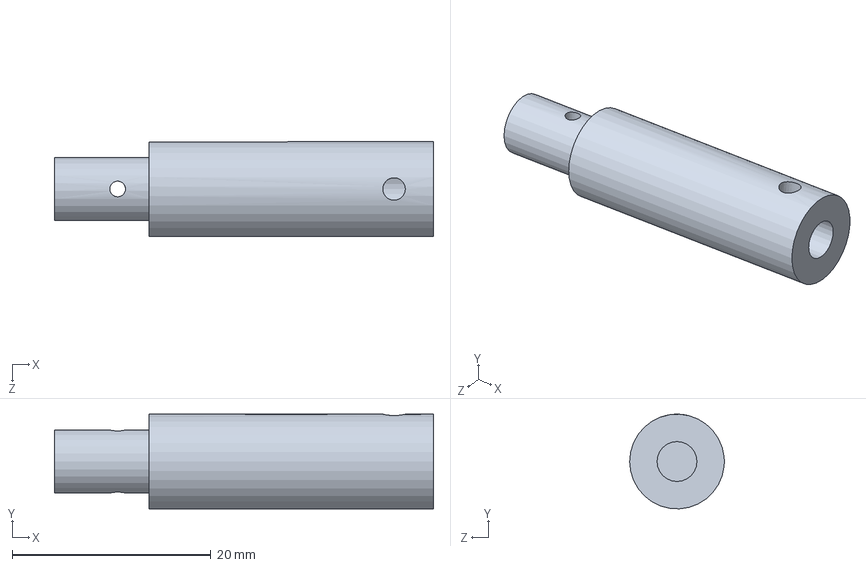
[picture p96: CAD file, 2021-10-25]
CAD RMP/111 Pre-made parts/Mounting_Examples/Connecting Shaft.SLDPRT
38.1 x 9.52 x 9.53 mm
