Zephurah/ME250-103/CAD RMP/111 Pre-made parts/Planetary Gear Box/Motor.SLDPRT

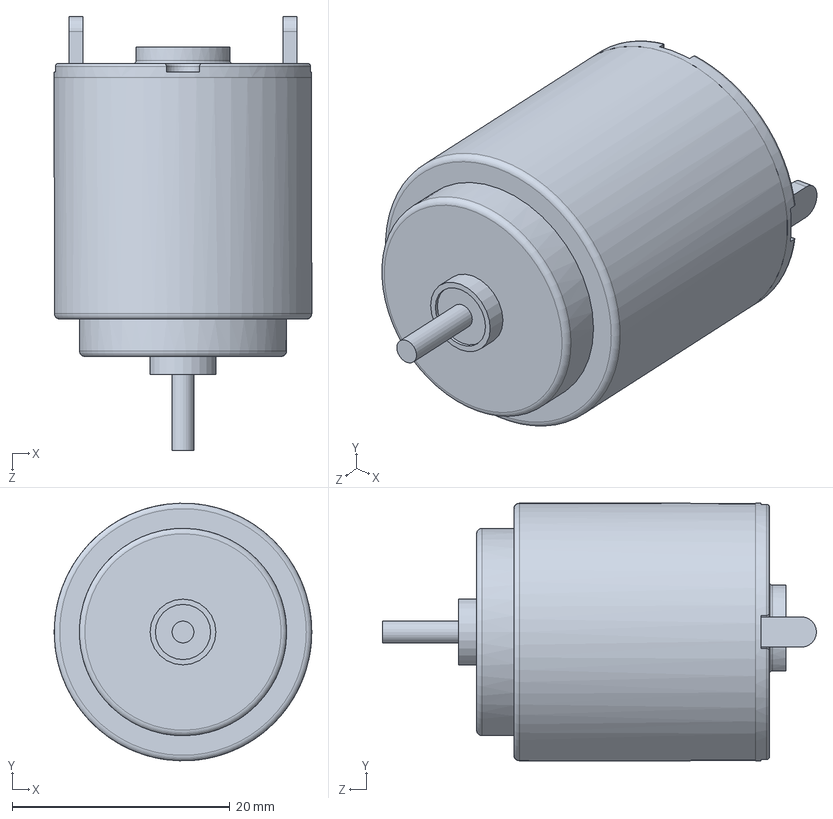
[picture p97: CAD file, 2021-10-25]
CAD RMP/111 Pre-made parts/Planetary Gear Box/Motor.SLDPRT
23.7 x 23.7 x 39.9 mm
