Zephurah/ME250-103/CAD RMP/Project/String Winder.SLDPRT

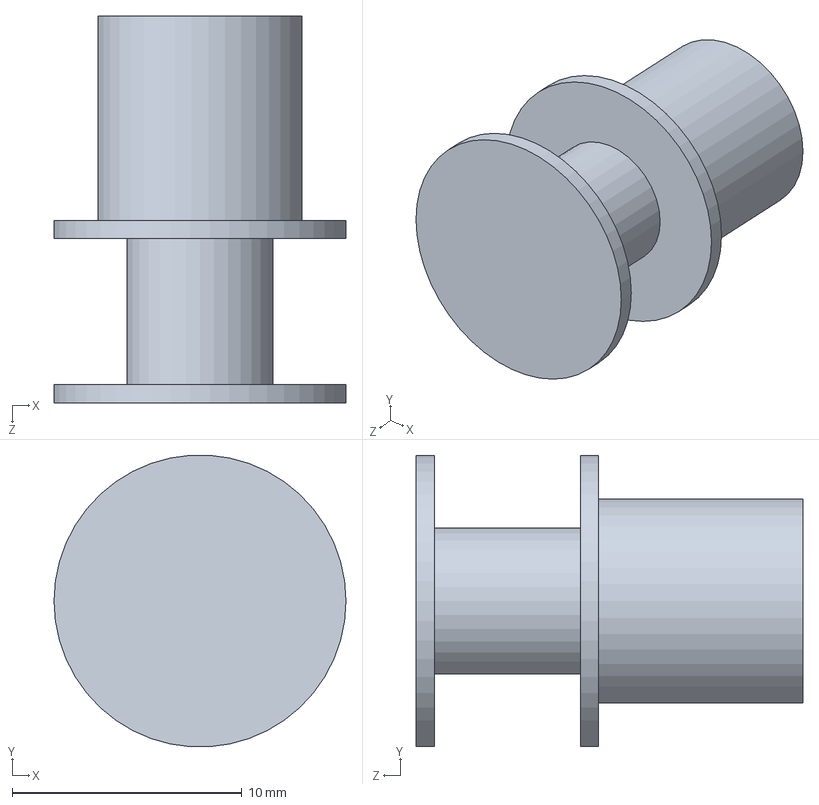
[picture p98: CAD file, 2021-10-25]
CAD RMP/Project/String Winder.SLDPRT
12.7 x 12.7 x 16.8 mm
