Zephurah/ME250-103/CAD RMP/111 Pre-made parts/Mounting_Examples/Motor Bracket.SLDPRT

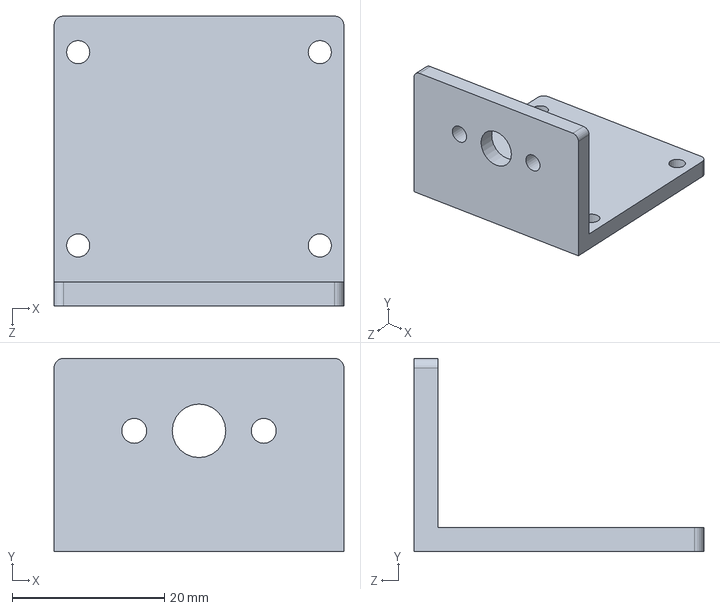
[picture p99: CAD file, 2021-10-25]
CAD RMP/111 Pre-made parts/Mounting_Examples/Motor Bracket.SLDPRT
38.1 x 25.4 x 38.1 mm
