Zephurah/ME250-103/CAD RMP/111 Pre-made parts/Mounting_Examples/Motor Blank.SLDPRT

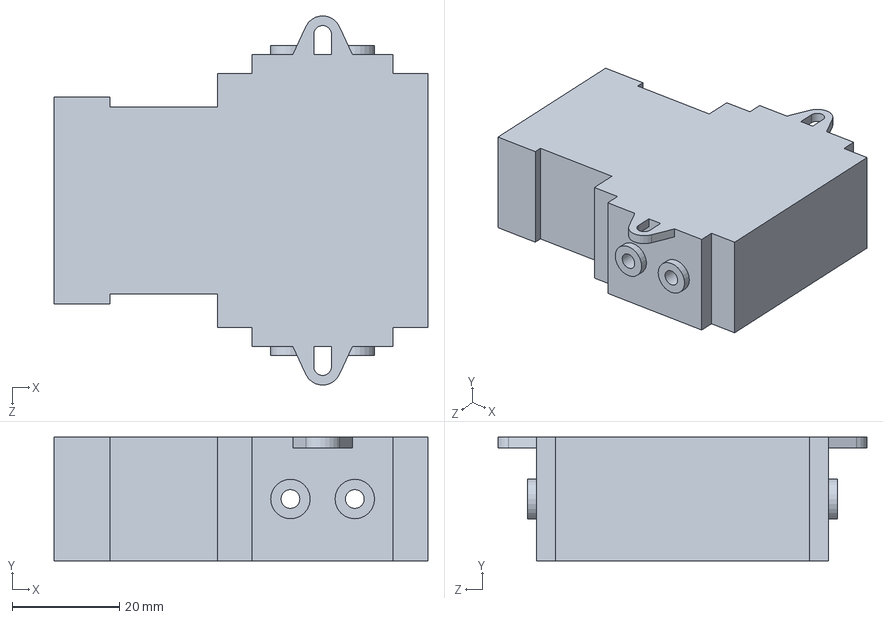
[picture p100: CAD file, 2021-10-25]
CAD RMP/111 Pre-made parts/Mounting_Examples/Motor Blank.SLDPRT
69.6 x 23.0 x 68.7 mm
