Zephurah/ME250-103/CAD RMP/111 Pre-made parts/Planetary Gear Box/MotorStay.SLDPRT

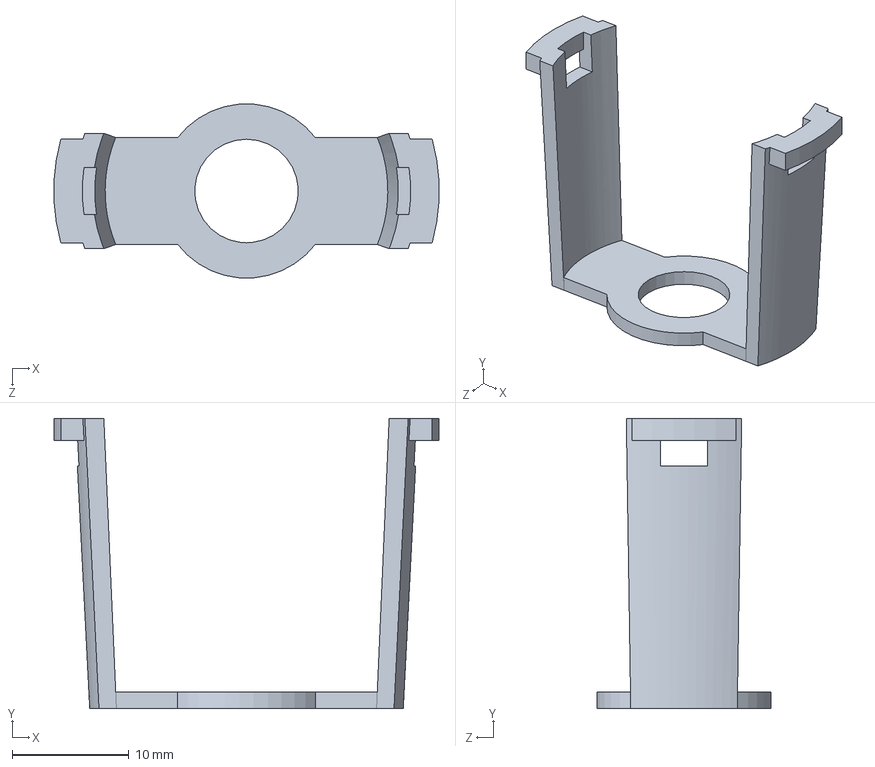
[picture p101: CAD file, 2021-10-25]
CAD RMP/111 Pre-made parts/Planetary Gear Box/MotorStay.SLDPRT
33.0 x 24.9 x 14.9 mm
