Zephurah/ME250-103/CAD RMP/Project/RMPTread1.SLDPRT

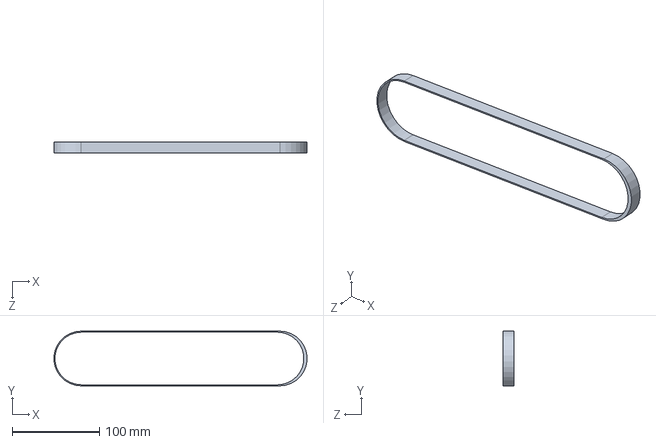
[picture p102: CAD file, 2021-10-25]
CAD RMP/Project/RMPTread1.SLDPRT
290.5 x 62.9 x 12.7 mm
