Zephurah/ME250-103/CAD RMP/111 Pre-made parts/Double Gear Box.SLDPRT

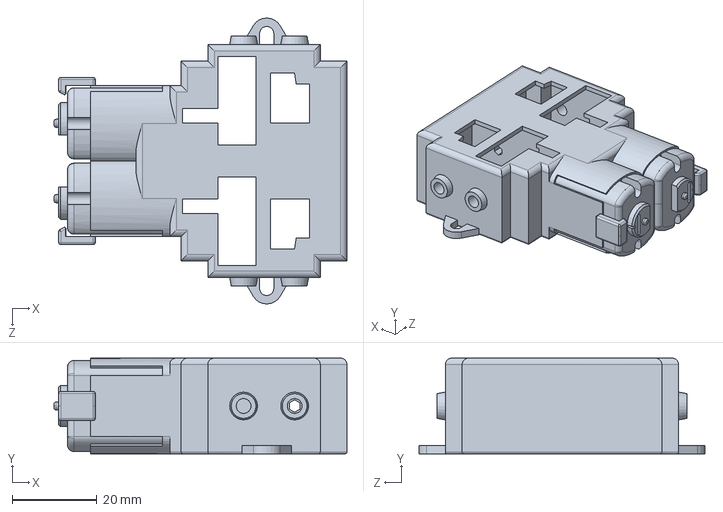
[picture p103: CAD file, 2021-10-25]
CAD RMP/111 Pre-made parts/Double Gear Box.SLDPRT
69.1 x 22.6 x 67.4 mm
