Zephurah/ME250-103/CAD RMP/111 Pre-made parts/Planetary Gear Box/GearboxMount.SLDPRT

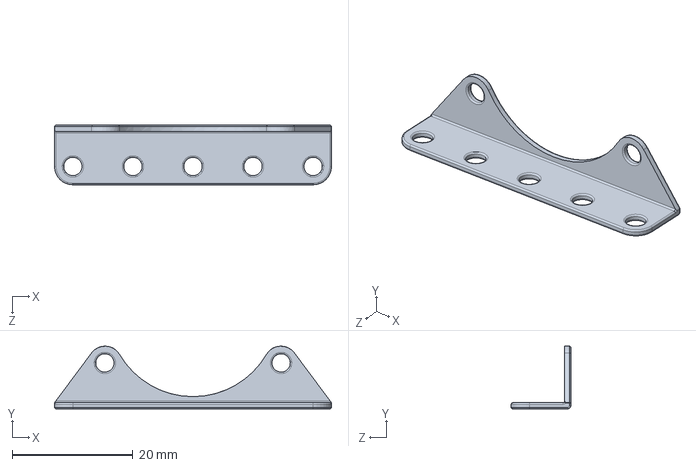
[picture p104: CAD file, 2021-10-25]
CAD RMP/111 Pre-made parts/Planetary Gear Box/GearboxMount.SLDPRT
46.0 x 10.4 x 9.91 mm
