Zephurah/ME250-103/CAD RMP/Project/lever Bar.SLDPRT

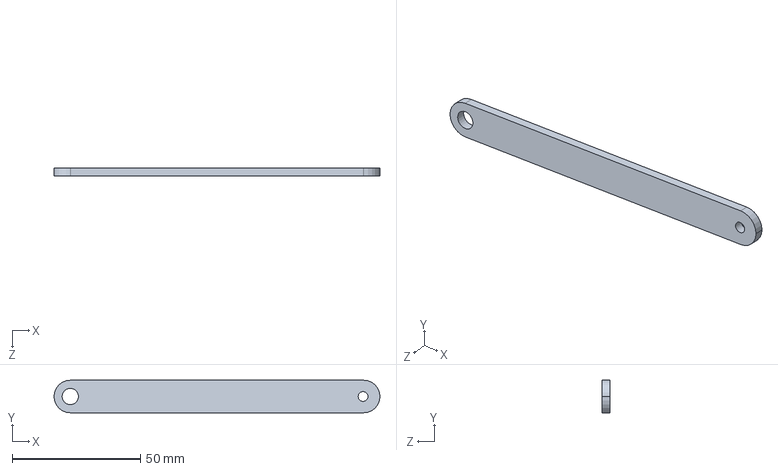
[picture p105: CAD file, 2021-10-25]
CAD RMP/Project/lever Bar.SLDPRT
127.0 x 12.7 x 3.17 mm
