Zephurah/ME250-103/CAD RMP/111 Pre-made parts/Planetary Gear Box/OrangeArmDisk.SLDPRT

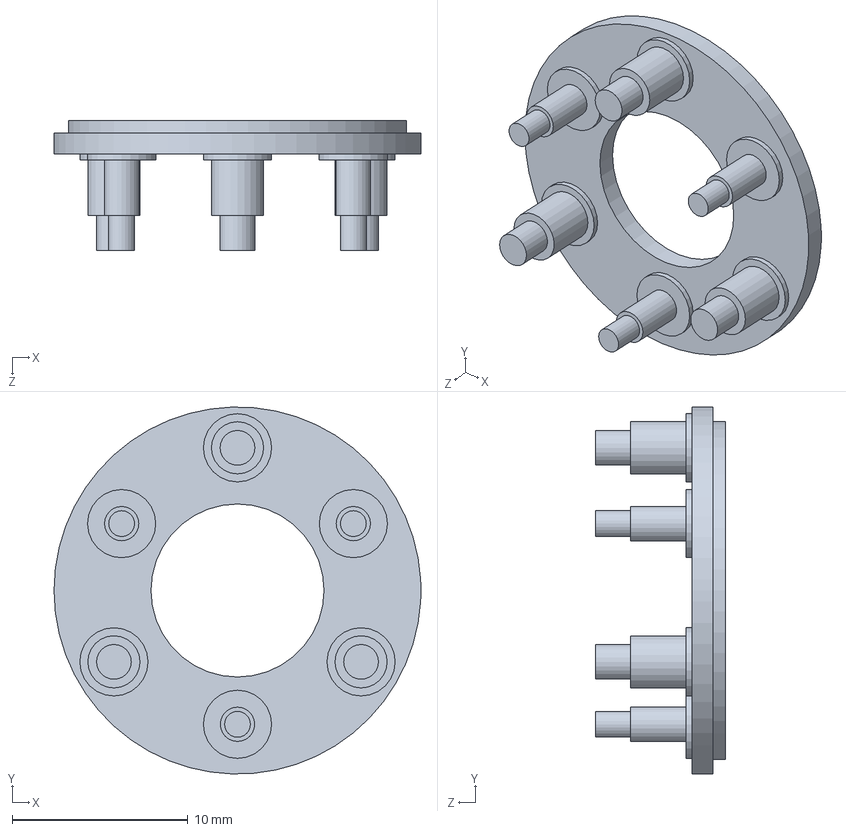
[picture p106: CAD file, 2021-10-25]
CAD RMP/111 Pre-made parts/Planetary Gear Box/OrangeArmDisk.SLDPRT
20.9 x 20.9 x 7.39 mm
