Zephurah/ME250-103/CAD RMP/Project/Scooper.SLDPRT

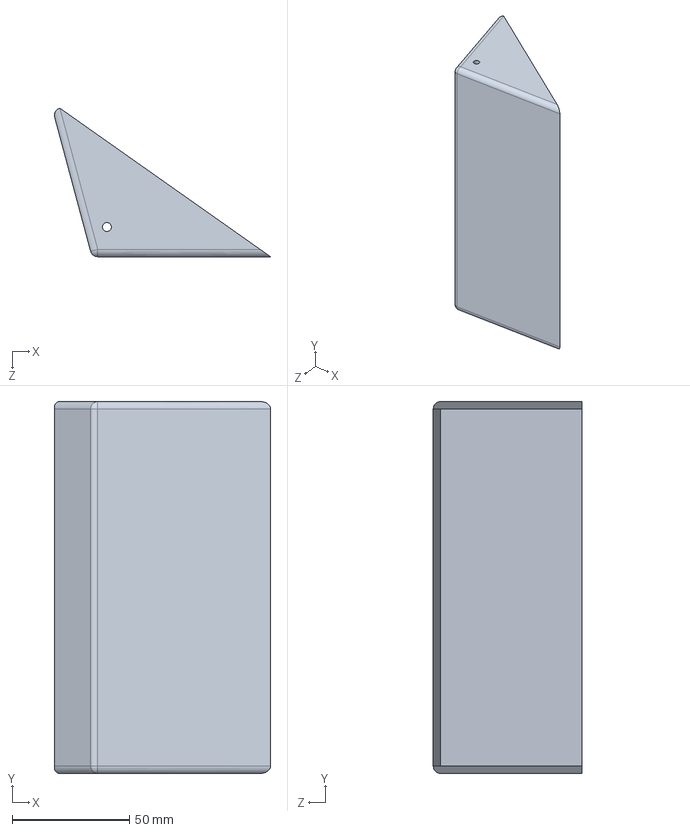
[picture p107: CAD file, 2021-10-25]
CAD RMP/Project/Scooper.SLDPRT
92.3 x 158.8 x 63.4 mm
