Zephurah/ME250-103/CAD RMP/Project/Axel.SLDPRT

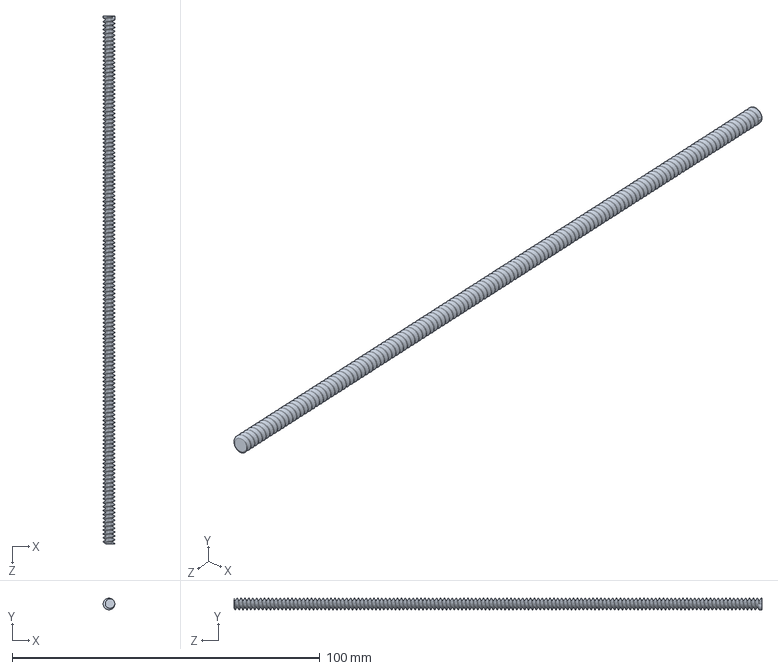
[picture p108: CAD file, 2021-10-25]
CAD RMP/Project/Axel.SLDPRT
3.81 x 3.81 x 171.4 mm
