Zephurah/ME250-103/CAD RMP/111 Pre-made parts/Mounting_Examples/Motor Shaft.SLDPRT

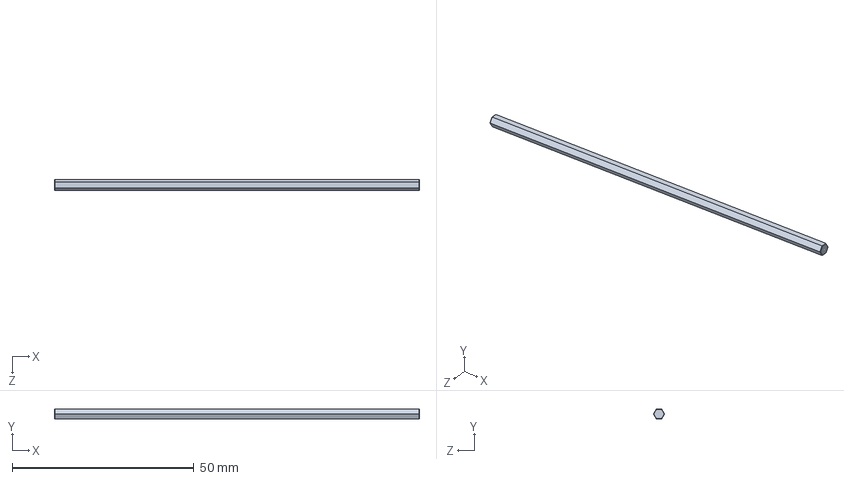
[picture p109: CAD file, 2021-10-25]
CAD RMP/111 Pre-made parts/Mounting_Examples/Motor Shaft.SLDPRT
100.5 x 2.67 x 3.08 mm
