Zephurah/ME250-103/CAD RMP/111 Pre-made parts/Planetary Gear Box/OrangeSpurLarge.SLDPRT

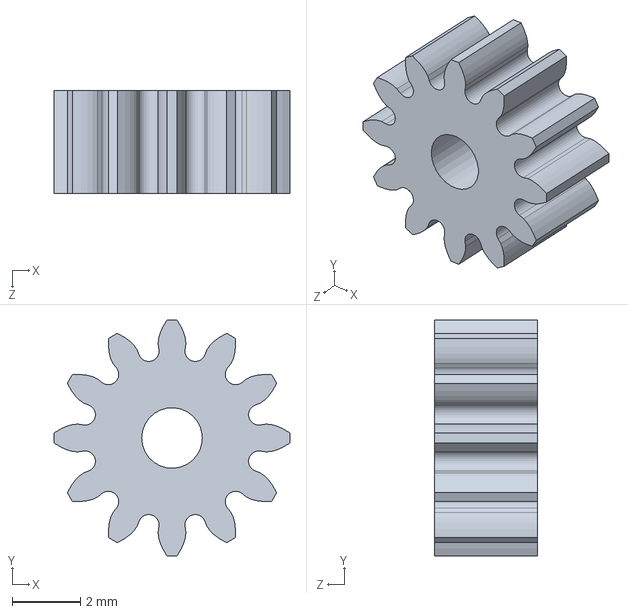
[picture p110: CAD file, 2021-10-25]
CAD RMP/111 Pre-made parts/Planetary Gear Box/OrangeSpurLarge.SLDPRT
6.93 x 6.93 x 3.01 mm
