Zephurah/ME250-103/CAD RMP/111 Pre-made parts/Mounting_Examples/Wheel connecting shaft.SLDPRT

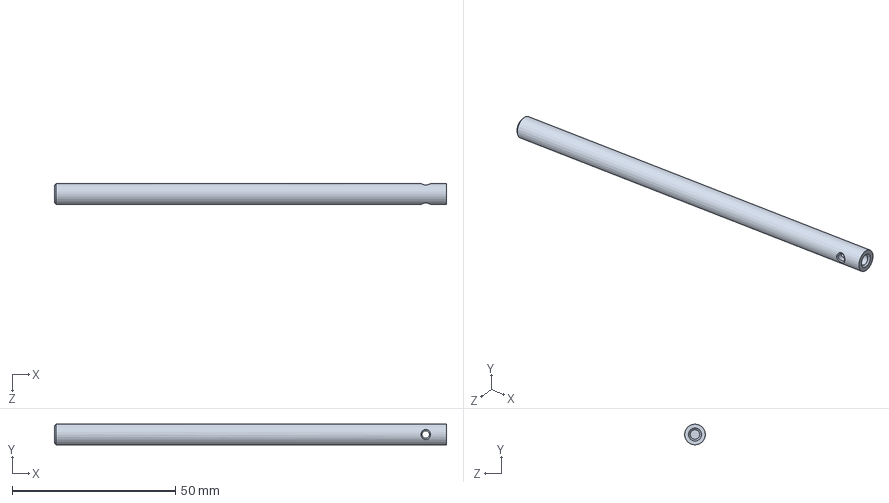
[picture p111: CAD file, 2021-10-25]
CAD RMP/111 Pre-made parts/Mounting_Examples/Wheel connecting shaft.SLDPRT
120.2 x 6.35 x 6.35 mm
