Zephurah/ME250-103/CAD RMP/111 Pre-made parts/Planetary Gear Box/TanSpurLarge.SLDPRT

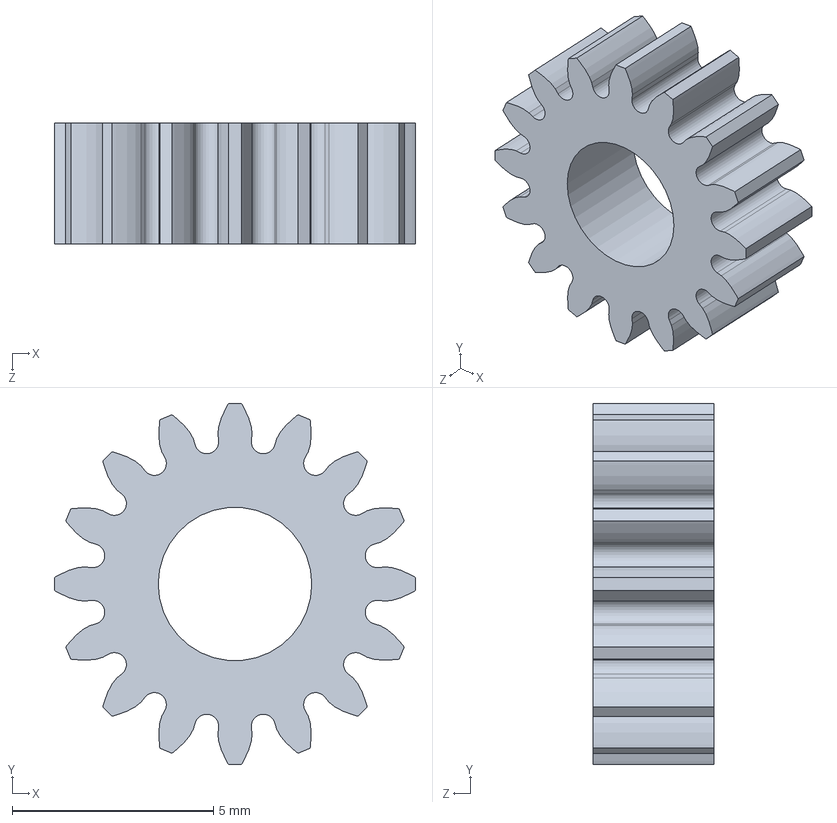
[picture p112: CAD file, 2021-10-25]
CAD RMP/111 Pre-made parts/Planetary Gear Box/TanSpurLarge.SLDPRT
8.96 x 8.96 x 3.01 mm
