Zephurah/ME250-103/CAD RMP/111 Pre-made parts/Mounting_Examples/Base Plate with Bushing Mount pockets.SLDPRT

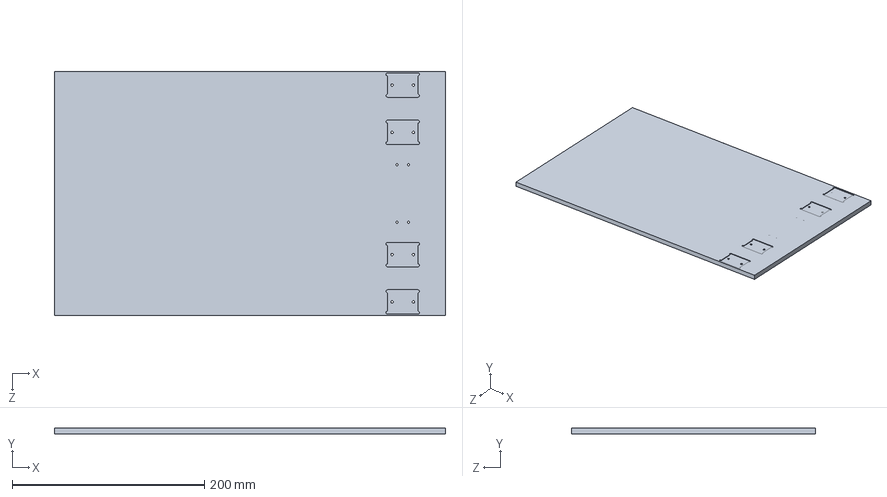
[picture p113: CAD file, 2021-10-25]
CAD RMP/111 Pre-made parts/Mounting_Examples/Base Plate with Bushing Mount pockets.SLDPRT
406.4 x 6.35 x 254.0 mm
