Zephurah/ME250-103/CAD RMP/111 Pre-made parts/Planetary Gear Box/OrangeDriveDisk.SLDPRT

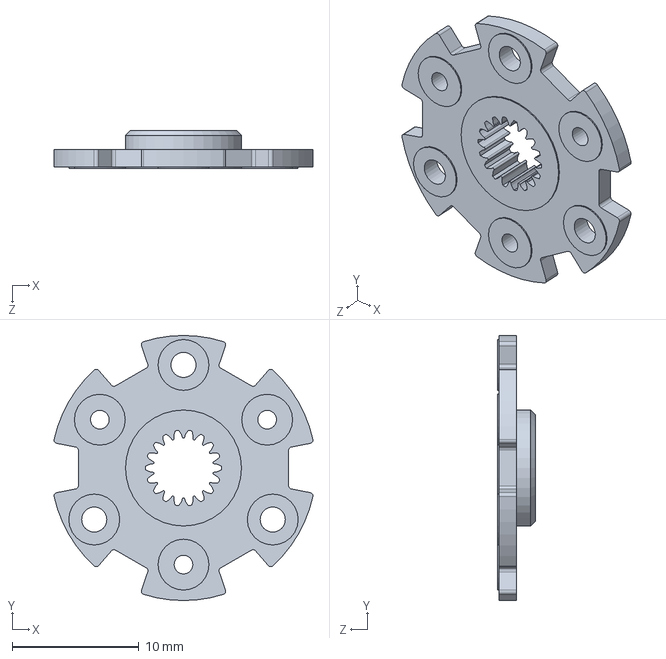
[picture p114: CAD file, 2021-10-25]
CAD RMP/111 Pre-made parts/Planetary Gear Box/OrangeDriveDisk.SLDPRT
20.4 x 20.9 x 2.98 mm
