Zephurah/ME250-103/CAD RMP/Project/Frame.SLDPRT

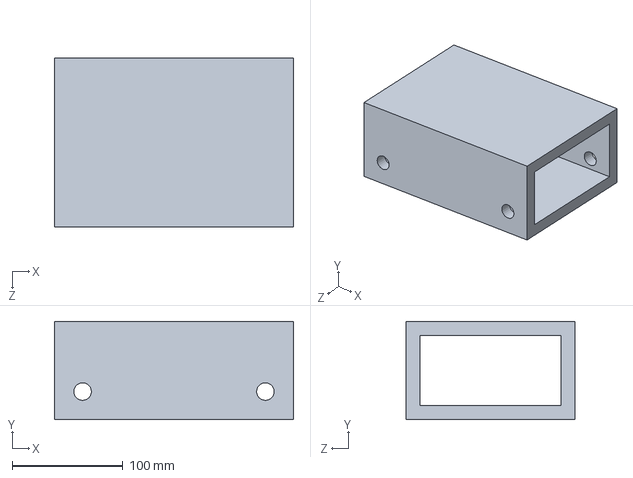
[picture p115: CAD file, 2021-10-25]
CAD RMP/Project/Frame.SLDPRT
215.9 x 88.9 x 152.4 mm
