Zephurah/ME250-103/CAD RMP/111 Pre-made parts/Planetary Gear Box/TanIntermediaryPlate.SLDPRT

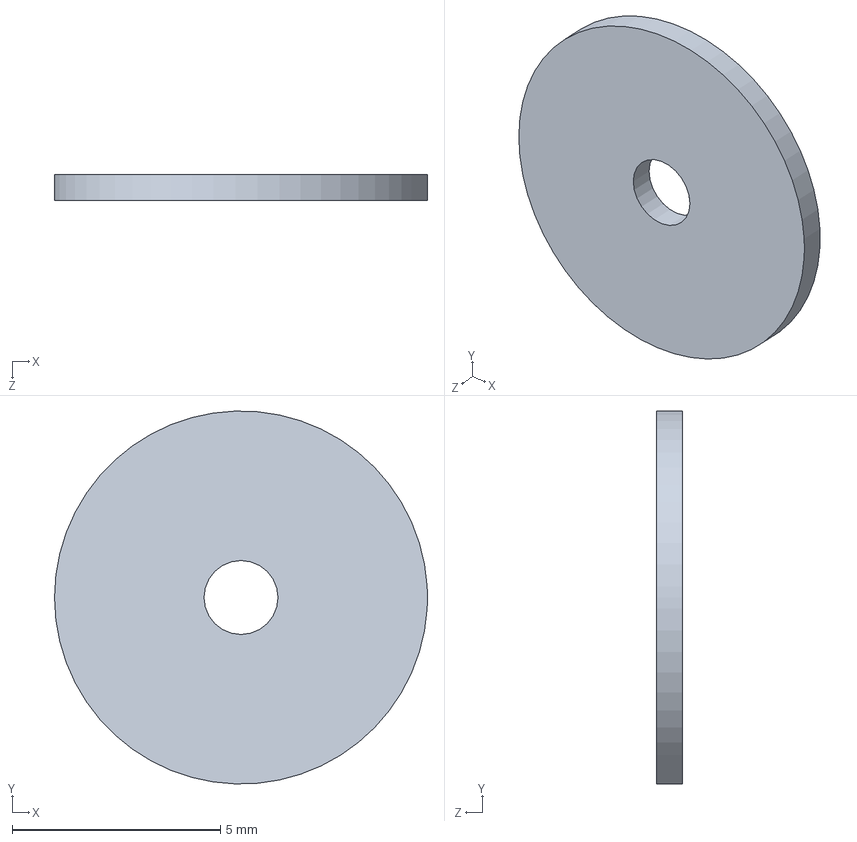
[picture p116: CAD file, 2021-10-25]
CAD RMP/111 Pre-made parts/Planetary Gear Box/TanIntermediaryPlate.SLDPRT
8.97 x 8.96 x 0.635 mm
