Zephurah/ME250-103/CAD RMP/111 Pre-made parts/Mounting_Examples/Wheel Bushing.SLDPRT

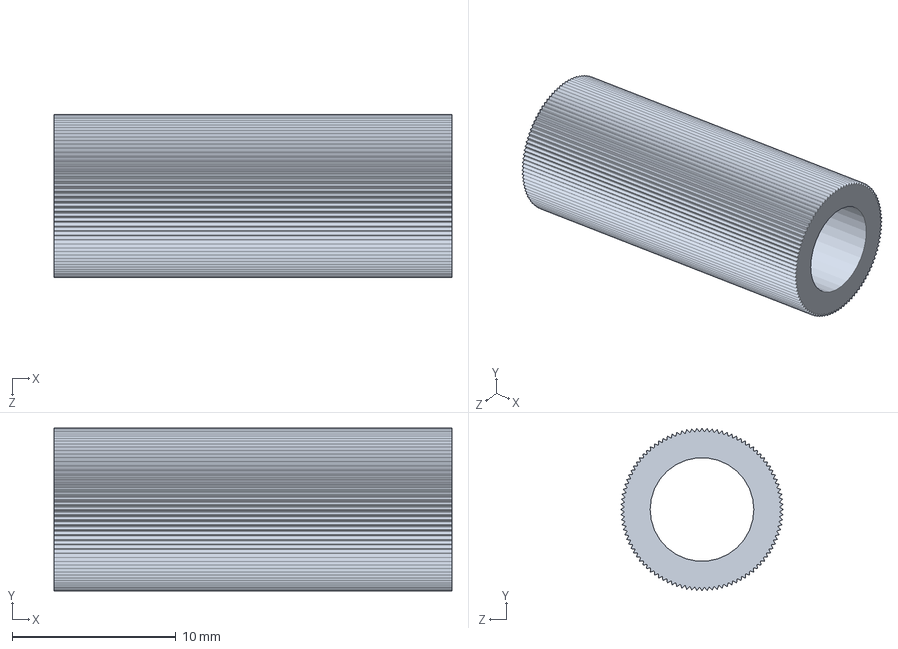
[picture p117: CAD file, 2021-10-25]
CAD RMP/111 Pre-made parts/Mounting_Examples/Wheel Bushing.SLDPRT
24.3 x 9.92 x 9.92 mm
