Zephurah/ME250-103/CAD RMP/111 Pre-made parts/Planetary Gear Box/SpringPin.SLDPRT

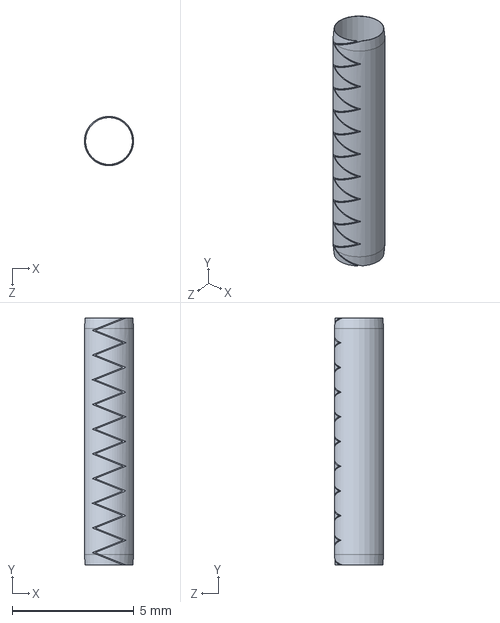
[picture p118: CAD file, 2021-10-25]
CAD RMP/111 Pre-made parts/Planetary Gear Box/SpringPin.SLDPRT
2.03 x 10.2 x 2.03 mm
