Zephurah/ME250-103/CAD RMP/111 Pre-made parts/Planetary Gear Box/MotorCase.SLDPRT

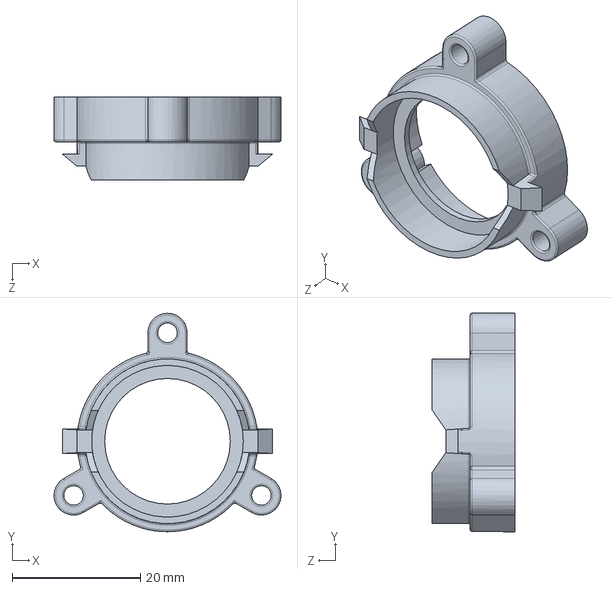
[picture p119: CAD file, 2021-10-25]
CAD RMP/111 Pre-made parts/Planetary Gear Box/MotorCase.SLDPRT
35.4 x 34.0 x 12.9 mm
