Zephurah/ME250-103/CAD RMP/111 Pre-made parts/Planetary Gear Box/HousingCase.SLDPRT

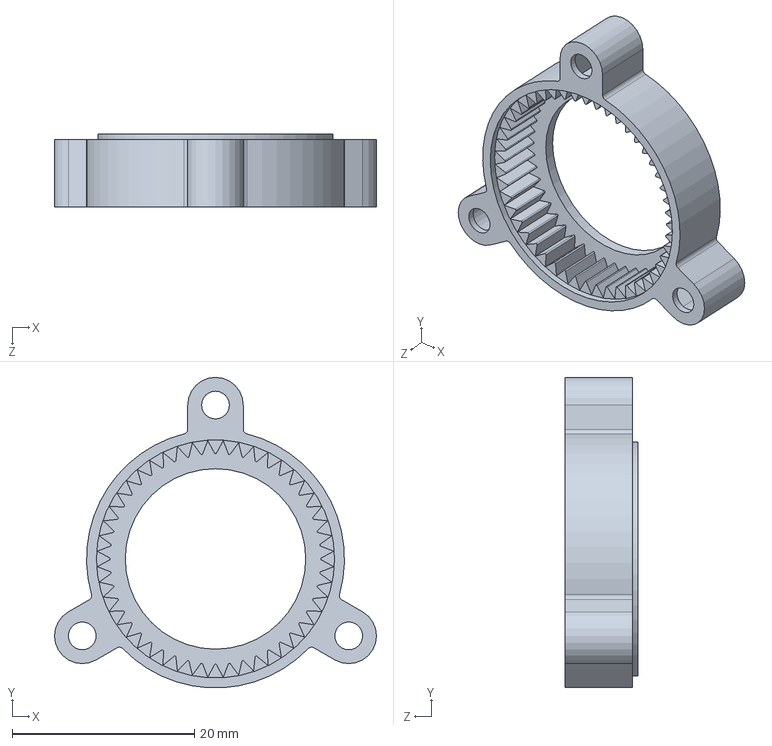
[picture p120: CAD file, 2021-10-25]
CAD RMP/111 Pre-made parts/Planetary Gear Box/HousingCase.SLDPRT
35.4 x 34.1 x 7.98 mm
