Zephurah/ME250-103/CAD RMP/111 Pre-made parts/Planetary Gear Box/EClip.SLDPRT

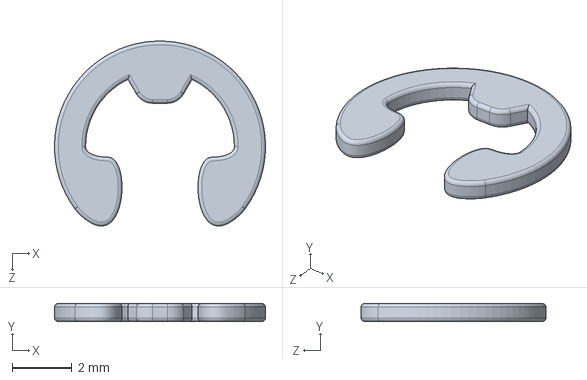
[picture p121: CAD file, 2021-10-25]
CAD RMP/111 Pre-made parts/Planetary Gear Box/EClip.SLDPRT
7.06 x 0.61 x 6.19 mm
