Zephurah/ME250-103/(list of files, cad)

Other CAD files:
CAD RMP/Project/Treads/drive-download-20211011T011059Z-001/WheelTreadAssem.SLDASM
CAD RMP/Project/WheelTreadAssem.SLDASM
CAD RMP/111 Pre-made parts/#6-32 .5.SLDPRT
CAD RMP/Wheel Axle/square bracket.SLDPRT
CAD RMP/111 Pre-made parts/Mounting_Examples/Gear Motor.SLDPRT
CAD RMP/111 Pre-made parts/Planetary Gear Box/OrangeSpurSmall.SLDPRT
CAD RMP/111 Pre-made parts/Mounting_Examples/Gear 1.SLDPRT
CAD RMP/111 Pre-made parts/Mounting_Examples/Bushing.SLDPRT
CAD RMP/111 Pre-made parts/Mounting_Examples/Gear.SLDPRT
CAD RMP/Project/M3Nut.SLDPRT
CAD RMP/111 Pre-made parts/Mounting_Examples/Sample Gear Shaft 24 tooth.SLDPRT
CAD RMP/111 Pre-made parts/Planetary Gear Box/TanDriveDisk.SLDPRT
Approval Plans/Brush Drawings/Brush Bracket.SLDDRW
Approval Plans/Brush Drawings/Brush Support.SLDDRW
Approval Plans/Frame Drawings/Bottom frame.SLDDRW
Approval Plans/Frame Drawings/Top Frame.SLDDRW
Approval Plans/MCS Scooper Drawings/Conncting Shaft Drawing.SLDDRW
Approval Plans/MCS Scooper Drawings/Left Lever Arm APPROVED.SLDDRW
Approval Plans/MCS Scooper Drawings/Lever Arm W motor APPROVED.SLDDRW
Approval Plans/MCS Scooper Drawings/Lever Motor Arm Axel.SLDDRW
Approval Plans/MCS Scooper Drawings/Lever Motor Arm Axle APPROVED.SLDDRW
Approval Plans/MCS Scooper Drawings/ME250 DRAWING TEMPLATE.SLDDRW
Approval Plans/MCS Scooper Drawings/Metal motor drill.SLDDRW
Approval Plans/MCS Scooper Drawings/Motor Bracket.SLDDRW
Approval Plans/MCS Scooper Drawings/ROPE WINDER.SLDDRW
Approval Plans/MCS Scooper Drawings/Scooper APPROVED.SLDDRW
Approval Plans/MCS Scooper Drawings/Small L Bracket.SLDDRW
Approval Plans/ME250 DRAWING TEMPLATE.SLDDRW
Approval Plans/Tread-Axle Drawings/Square Bracket.SLDDRW
Approval Plans/Tread-Axle Drawings/Wheel Axel.SLDDRW
CAD RMP/111 Pre-made parts/2662N25_20 Degree Pressure Angle Plastic Gear.SLDPRT
CAD RMP/111 Pre-made parts/90480A009_Low-Strength Steel Hex Nut.SLDPRT
CAD RMP/111 Pre-made parts/94210A125_Medium-Strength Threaded Rod - 10in.SLDPRT
CAD RMP/111 Pre-made parts/95462A029_Medium-Strength Steel Hex Nut.SLDPRT
CAD RMP/111 Pre-made parts/Example SetScrew SpringPin/0.500 inch Spring Pin.SLDPRT
CAD RMP/111 Pre-made parts/Example SetScrew SpringPin/4-40 Set Screw.SLDPRT
CAD RMP/111 Pre-made parts/Example SetScrew SpringPin/A_SetScrew.SLDASM
CAD RMP/111 Pre-made parts/Example SetScrew SpringPin/A_SpringPin.SLDASM
CAD RMP/111 Pre-made parts/Example SetScrew SpringPin/FemaleRodforSetScrew.SLDPRT
CAD RMP/111 Pre-made parts/Example SetScrew SpringPin/FemaleRodforSpringPin.SLDPRT
CAD RMP/111 Pre-made parts/Example SetScrew SpringPin/MaleRodforSetScrew.SLDPRT
CAD RMP/111 Pre-made parts/Example SetScrew SpringPin/MaleRodforSpringPin.SLDPRT
CAD RMP/111 Pre-made parts/Mounting_Examples/24 tooth Gear.SLDPRT
CAD RMP/111 Pre-made parts/Mounting_Examples/3 mm screw.SLDPRT
CAD RMP/111 Pre-made parts/Mounting_Examples/4-40 set screw.SLDPRT
CAD RMP/111 Pre-made parts/Pan Head Screw 6-40.SLDPRT
CAD RMP/111 Pre-made parts/Planetary Gear Box/GearboxMount.SLDDRW
CAD RMP/111 Pre-made parts/Planetary Gear Box/M3TieBolt.SLDPRT
CAD RMP/111 Pre-made parts/Planetary Gear Box/Motor.SLDDRW
CAD RMP/111 Pre-made parts/Planetary Gear Box/OrangeDriveDisk.SLDDRW
CAD RMP/111 Pre-made parts/Planetary Gear Box/SingleHorn.SLDDRW
CAD RMP/111 Pre-made parts/Planetary Gear Box/TanArmDisk.SLDDRW
CAD RMP/111 Pre-made parts/Screw 1-4in ID .75in length.SLDPRT
CAD RMP/111 Pre-made parts/Screw 1-8in ID .75in length.SLDPRT
CAD RMP/111 Pre-made parts/washer 1-4 OD 1-8 ID.SLDPRT
CAD RMP/111 Pre-made parts/washer 3-4 OD 1-8 ID.SLDPRT
CAD RMP/Arm/Scooper.STL
CAD RMP/Arm/String Winder.STL
CAD RMP/Arm/screw with shoulder REAL.SLDPRT
CAD RMP/Brush/94210A125_Medium-Strength Threaded Rod - 10in.SLDPRT
CAD RMP/Brush/OLD STYLE BRUSH/94210A125_Medium-Strength Threaded Rod - 10in.SLDPRT
CAD RMP/Brush/OLD STYLE BRUSH/Bracket.SLDPRT
CAD RMP/Brush/OLD STYLE BRUSH/Brush Arm.SLDASM
CAD RMP/Brush/OLD STYLE BRUSH/Brush.SLDPRT
CAD RMP/Brush/OLD STYLE BRUSH/Locking pin.SLDPRT
CAD RMP/Brush/OLD STYLE BRUSH/support.SLDPRT
CAD RMP/Project/Treads/drive-download-20211011T011059Z-001/Screw 1-4in ID .75in length.SLDPRT
CAD RMP/Project/Treads/drive-download-20211011T011059Z-001/Screw 1-8in ID .75in length.SLDPRT
CAD RMP/Project/Treads/drive-download-20211011T011059Z-001/WheelTreads W screws.SLDASM
CAD RMP/Project/Treads/drive-download-20211011T011059Z-001/washer 1-4 OD 1-8 ID.SLDPRT
CAD RMP/Project/Treads/drive-download-20211011T011059Z-001/washer 3-4 OD 1-8 ID.SLDPRT
CAD RMP/Treads/WheelTreads W screws.SLDASM
CAD RMP/Wheel Axle/DOUBLE GEAR BOX ADAPTER SHAFT.SLDDRW
