Zephurah/ME250-103/MS5 Submission/BOM ME250 Team 103 - BOM Team 103.pdf

## BOM ME250 Team 103

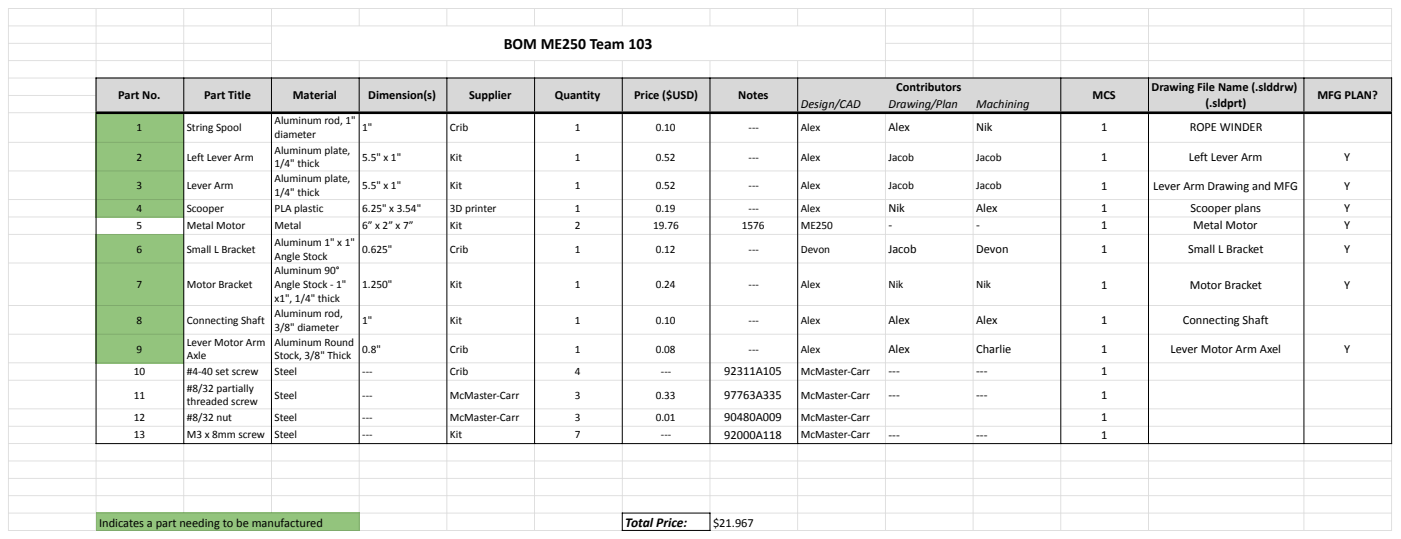
[picture p137: page 1]
Indicates a part needing to be manufactured; Total Price:

Part No. | Part Title | Material | Dimension(s) | Supplier | Quantity | Price ($USD) | Notes | Contributors Drawing/Plan Machining | MCS | Drawing File Name (.slddrw) (.sldprt) | MFG PLAN? Design/CAD

1 2 3 4 5 6 7 8 9 10 11 12 13 | String Spool Left Lever Arm Lever Arm Scooper Metal Motor Small L Bracket Motor Bracket Connecting Shaft Lever Motor Arm Axle #4-40 set screw #8/32 partially threaded screw #8/32 nut M3 x 8mm screw | Aluminum rod, 1" diameter Aluminum plate, 1/4" thick Aluminum plate, 1/4" thick PLA plastic Metal Aluminum 1" x 1" Angle Stock Aluminum 90° Angle Stock - 1" x1", 1/4" thick Aluminum rod, 3/8" diameter Aluminum Round Stock, 3/8" Thick Steel Steel Steel Steel | 1" 5.5" x 1" 5.5" x 1" 6.25" x 3.54" 6” x 2” x 7” 0.625" 1.250" 1" 0.8" ------------ | Crib Kit Kit 3D printer Kit Crib Kit Kit Crib Crib McMaster-Carr McMaster-Carr Kit | 1 1 1 1 2 1 1 1 1 4 3 3 7 | 0.10 0.52 0.52 0.19 19.76 0.12 0.24 0.10 0.08 ---0.33 0.01 --- | ------------1576 ------------92311A105 97763A335 90480A009 92000A118 | Alex Alex Nik Alex Jacob Jacob Alex Jacob Jacob Alex Nik Alex ME250 --Devon Jacob Devon Alex Nik Nik Alex Alex Alex Alex Alex Charlie McMaster-Carr ------McMaster-Carr ------McMaster-Carr McMaster-Carr ------ | 1 1 1 1 1 1 1 1 1 1 1 1 1 | ROPE WINDER Left Lever Arm Lever Arm Drawing and MFG Scooper plans Metal Motor Small L Bracket Motor Bracket Connecting Shaft Lever Motor Arm Axel | Y Y Y Y Y Y Y
