Zephurah/ME250-103/Approval Plans/ONLY FULLY APPROVED PDFS/Left Lever Arm FULLY APPROVED - Alex Birnbaum.pdf

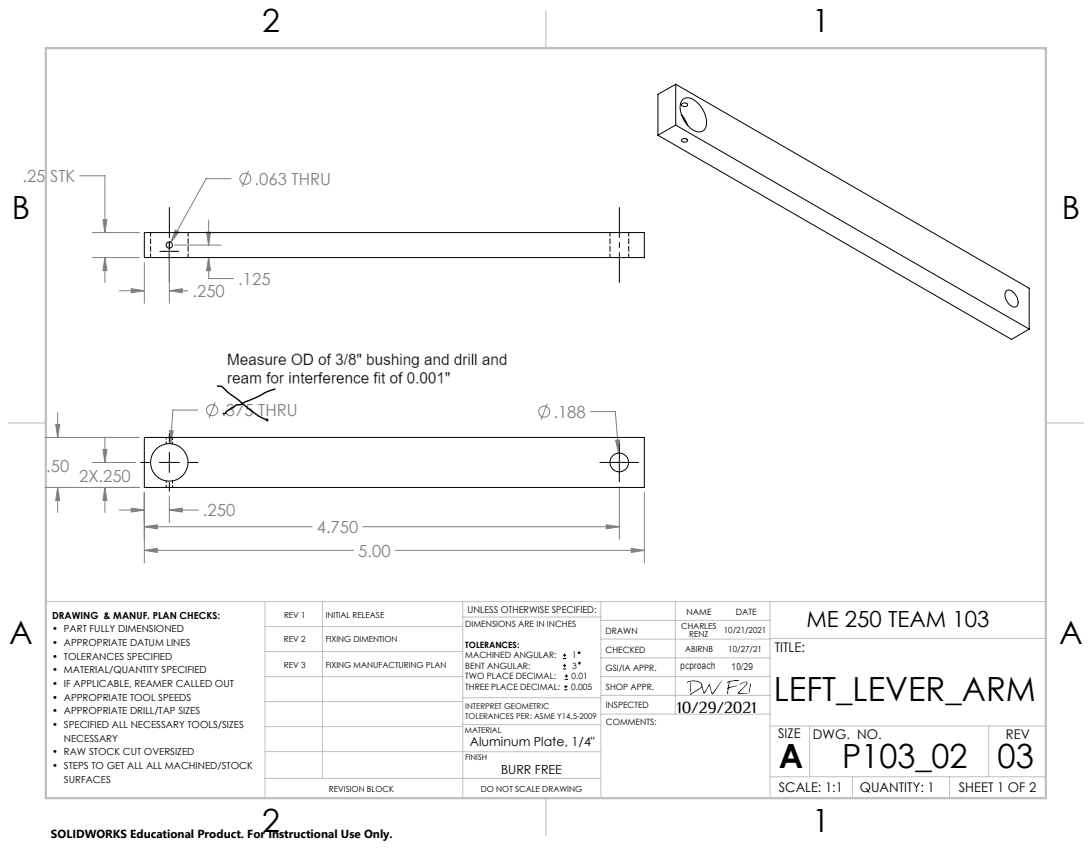
[picture p139: page 1]
.375 THRU; .25 STK; .063 THRU

DRAWING & MANUF. PLAN CHECKS: • PART FULLY DIMENSIONED • APPROPRIATE DATUM LINES • TOLERANCES SPECIFIED • MATERIAL/QUANTITY SPECIFIED • IF APPLICABLE, REAMER CALLED OUT • APPROPRIATE TOOL SPEEDS • APPROPRIATE DRILL/TAP SIZES • SPECIFIED ALL NECESSARY TOOLS/SIZES NECESSARY • RAW STOCK CUT OVERSIZED • STEPS TO GET ALL ALL MACHINED/STOCK SURFACES | REV 1 | INITIAL RELEASE | UNLESS OTHERWISE SPECIFIED: | | NAME DATE | ME 250 TEAM 103

DIMENSIONS ARE IN INCHES TOLERANCES: MACHINED ANGULAR: 1 BENT ANGULAR: 3 TWO PLACE DECIMAL: 0.01 THREE PLACE DECIMAL: 0.005 | DRAWN | CHARLES 10/21/2021 RENZ REV 2

FIXING DIMENTION

CHECKED | ABIRNB 10/27/21 | TITLE: LEFT_LEVER_ARM

REV 3 | FIXING MANUFACTURING PLAN

GSI/IA APPR.
SHOP APPR.

INTERPRET GEOMETRIC TOLERANCES PER: ASME Y14.5-2009 | INSPECTED | 10/29/2021
MATERIAL Aluminum Plate, 1/4" | | SIZE A | DWG. NO. P103_02 | REV 03

FINISH BURR FREE

REVISION BLOCK | DO NOT SCALE DRAWING | | SCALE: 1:1 | QUANTITY: 1 | SHEET 1 OF 2

SOLIDWORKS Educational Product. For Instructional Use Only.

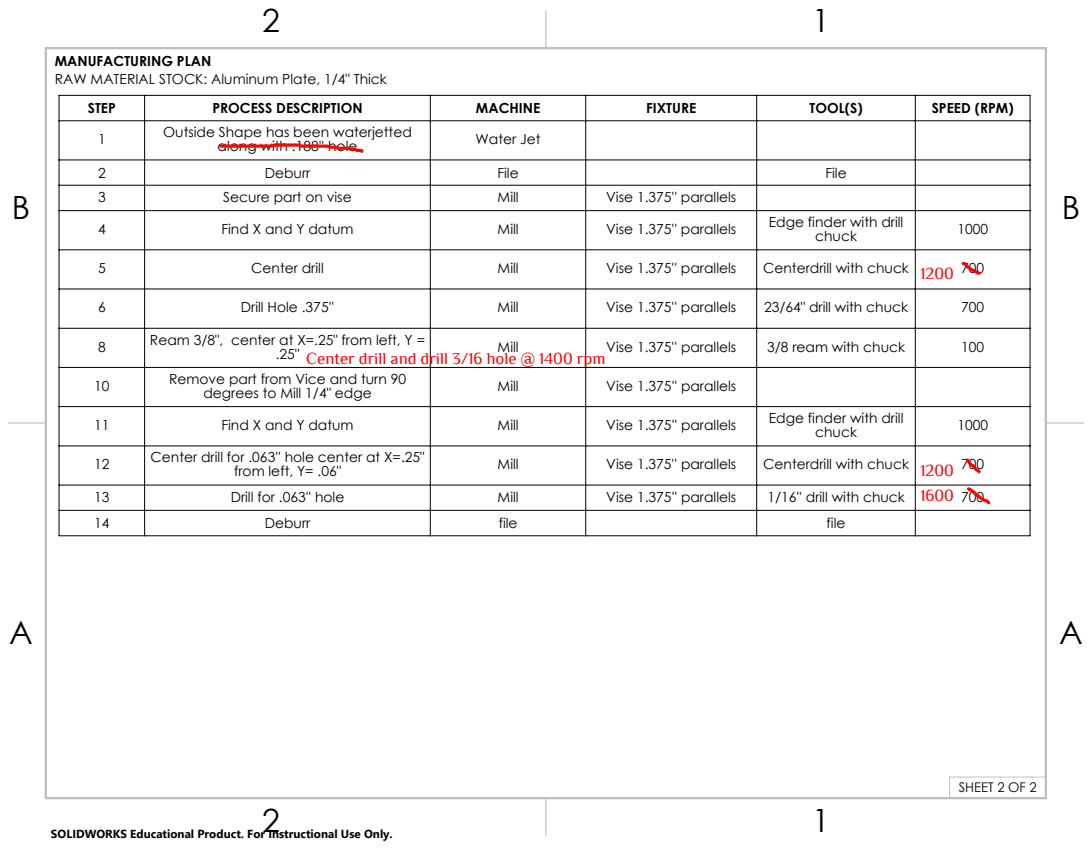
[picture p140: page 2]
SHEET 2 OF 2

MANUFACTURING PLAN
RAW MATERIAL STOCK: Aluminum Plate, 1/4" Thick

STEP | PROCESS DESCRIPTION | MACHINE | FIXTURE | TOOL(S) | SPEED (RPM)
1 Outside Shape has been waterjetted | along with .188'' hole | Water Jet

2 | Deburr | File | | File
3 | Secure part on vise | Mill | Vise 1.375'' parallels
4 | Find X and Y datum | Mill | Vise 1.375'' parallels | Edge finder with drill chuck | 1000

5 | Center drill | Mill | Vise 1.375'' parallels | Centerdrill with chuck | 700 1200

6 | Drill Hole .375'' | Mill | Vise 1.375'' parallels | 23/64" drill with chuck | 700
8 Ream 3/8", center at X=.25" from left, Y = | .25" Center drill and drill 3/16 hole @ 1400 rpm | Mill | Vise 1.375'' parallels | 3/8 ream with chuck | 100

10 Remove part from Vice and turn 90 | degrees to Mill 1/4" edge | Mill | Vise 1.375'' parallels

11 | Find X and Y datum | Mill | Vise 1.375'' parallels | Edge finder with drill chuck | 1000

12 Center drill for .063'' hole center at X=.25" | from left, Y= .06" | Mill | Vise 1.375'' parallels | Centerdrill with chuck | 700 1200

13 | Drill for .063'' hole | Mill | Vise 1.375'' parallels | 1/16'' drill with chuck | 1600 700
14 | Deburr | file | | file

SOLIDWORKS Educational Product. For Instructional Use Only.
