Zephurah/ME250-103/Approval Plans/ONLY FULLY APPROVED PDFS/Lever Arm W motor FULLY APPROVED - Alex Birnbaum.pdf

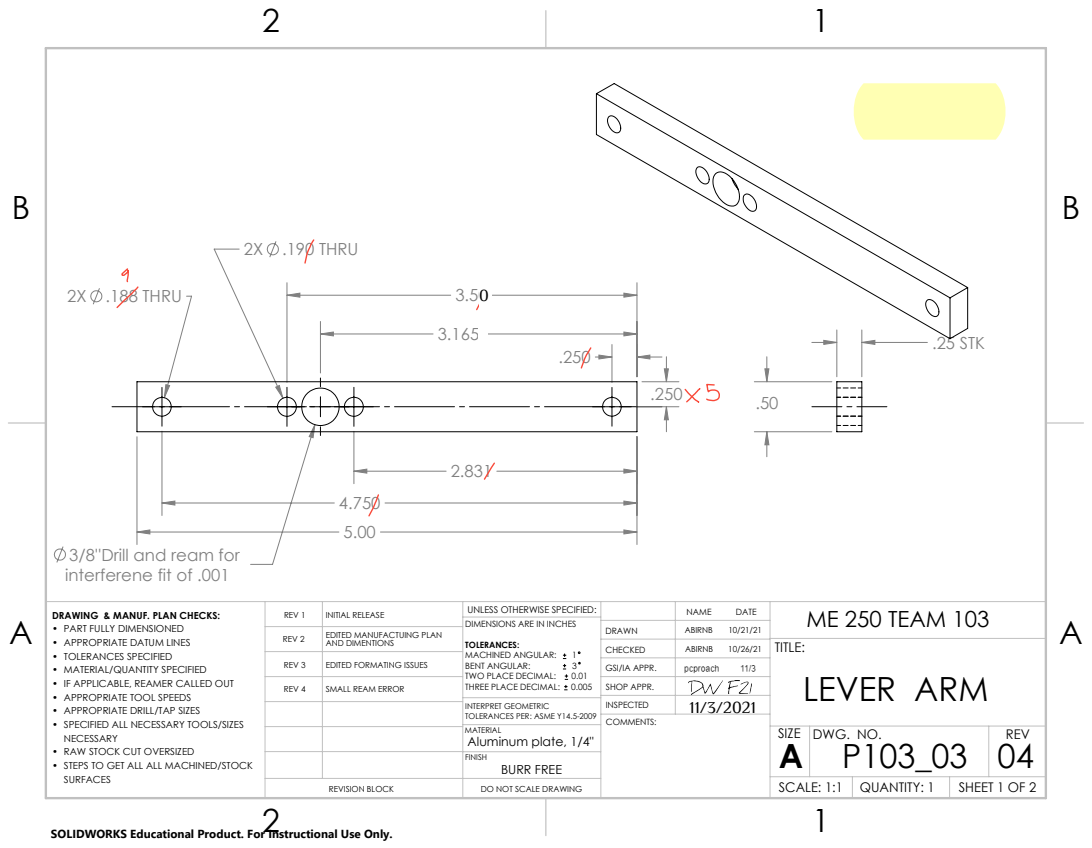
[picture p141: page 1]
2X .190 THRU; 2X .188 THRU; .25 STK

3/8''Drill and ream for
interferene fit of .001

DRAWING & MANUF. PLAN CHECKS: • PART FULLY DIMENSIONED • APPROPRIATE DATUM LINES • TOLERANCES SPECIFIED • MATERIAL/QUANTITY SPECIFIED • IF APPLICABLE, REAMER CALLED OUT • APPROPRIATE TOOL SPEEDS • APPROPRIATE DRILL/TAP SIZES • SPECIFIED ALL NECESSARY TOOLS/SIZES NECESSARY • RAW STOCK CUT OVERSIZED • STEPS TO GET ALL ALL MACHINED/STOCK SURFACES | REV 1 | INITIAL RELEASE | UNLESS OTHERWISE SPECIFIED: | | NAME DATE | ME 250 TEAM 103

DIMENSIONS ARE IN INCHES TOLERANCES: MACHINED ANGULAR: 1 BENT ANGULAR: 3 TWO PLACE DECIMAL: 0.01 THREE PLACE DECIMAL: 0.005 | DRAWN | ABIRNB 10/21/21

REV 2 | EDITED MANUFACTUING PLAN AND DIMENTIONS

CHECKED | ABIRNB 10/26/21 | TITLE: LEVER ARM

REV 3 | EDITED FORMATING ISSUES
REV 4 | SMALL REAM ERROR | | SHOP APPR.

GSI/IA APPR.

INTERPRET GEOMETRIC TOLERANCES PER: ASME Y14.5-2009 | INSPECTED | 11/3/2021
MATERIAL Aluminum plate, 1/4" | | SIZE A | DWG. NO. P103_03 | REV 04

FINISH BURR FREE

REVISION BLOCK | DO NOT SCALE DRAWING | | SCALE: 1:1 | QUANTITY: 1 | SHEET 1 OF 2

SOLIDWORKS Educational Product. For Instructional Use Only.

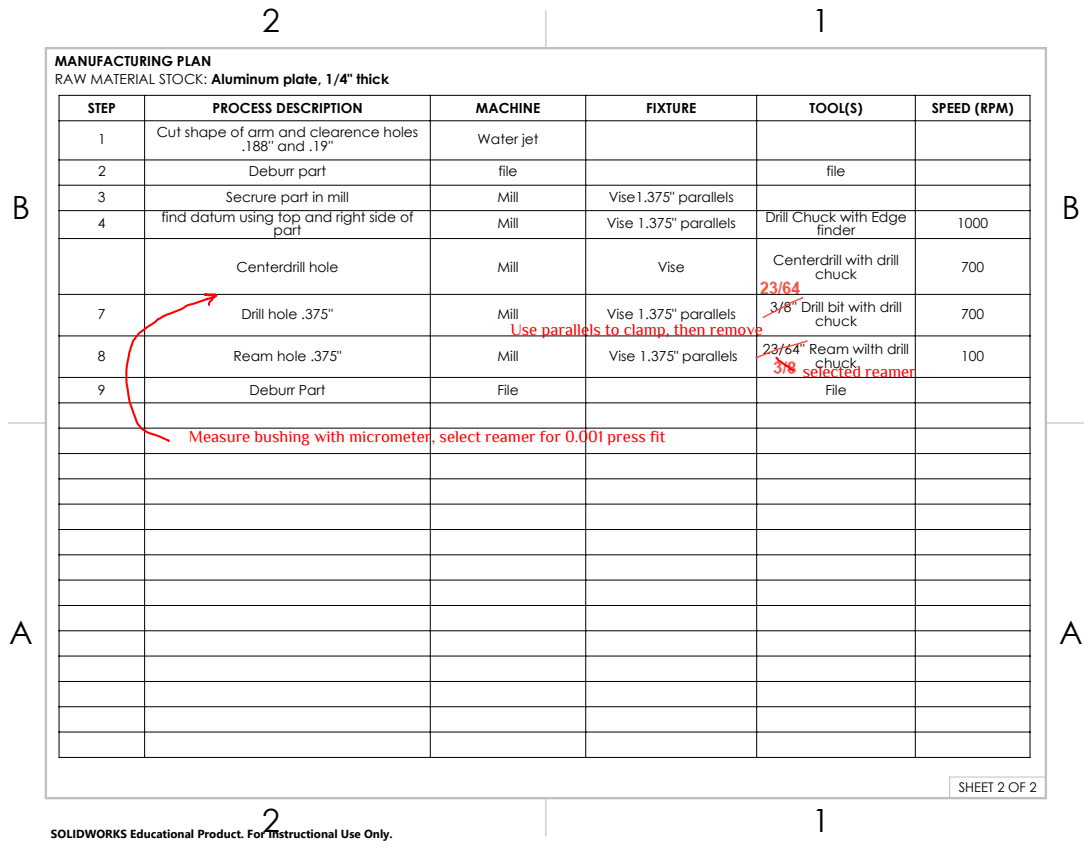
[picture p142: page 2]
STEP; PROCESS DESCRIPTION; MACHINE; FIXTURE; TOOL(S); SPEED (RPM); Cut shape of arm and clearence holes; .188'' and .19''; Water jet; Deburr part; file; Secrure part in mill; Mill; Vise1.375" parallels; find datum using top and right side of; part; Vise 1.375" parallels; Drill Chuck with Edge; Centerdrill hole; Vise; Centerdrill with drill; Drill hole .375''; 3/8'' Drill bit with drill; Ream hole .375"; 23/64'' Ream wilth drill; Deburr Part; File; SHEET 2 OF 2; selected reamer

MANUFACTURING PLAN
RAW MATERIAL STOCK: Aluminum plate, 1/4" thick

Use parallels to clamp, then remove

Measure bushing with micrometer, select reamer for 0.001 press fit

SOLIDWORKS Educational Product. For Instructional Use Only.
