Zephurah/ME250-103/Approval Plans/ONLY FULLY APPROVED PDFS/ROPE WINDER FULLY APPROVED - Alex Birnbaum.pdf

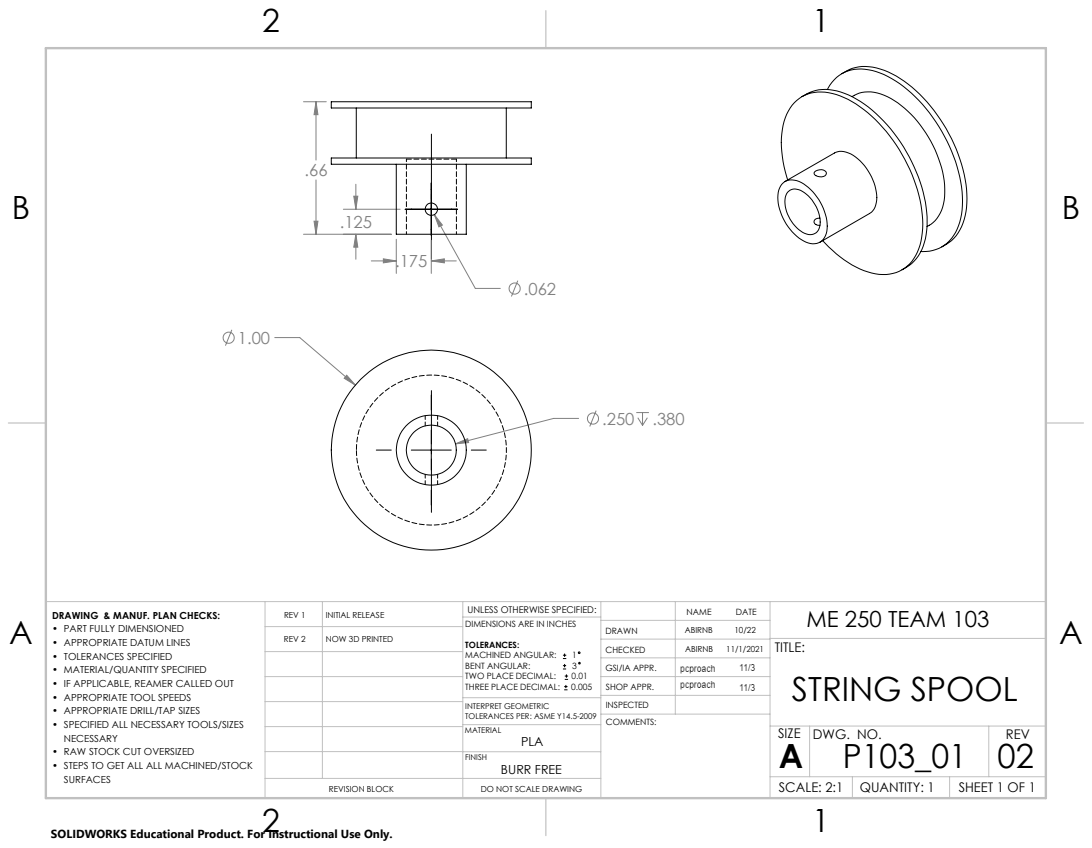
[picture p143: page 1]
REV 2; NOW 3D PRINTED

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

DIMENSIONS ARE IN INCHES TOLERANCES: MACHINED ANGULAR: 1 BENT ANGULAR: 3 TWO PLACE DECIMAL: 0.01 THREE PLACE DECIMAL: 0.005 | DRAWN | ABIRNB 10/22

CHECKED | ABIRNB 11/1/2021 | TITLE: STRING SPOOL

GSI/IA APPR.
SHOP APPR.

INTERPRET GEOMETRIC TOLERANCES PER: ASME Y14.5-2009 | INSPECTED
MATERIAL PLA | | SIZE A | DWG. NO. P103_01 | REV 02

FINISH BURR FREE

REVISION BLOCK | DO NOT SCALE DRAWING | | SCALE: 2:1 | QUANTITY: 1 | SHEET 1 OF 1

SOLIDWORKS Educational Product. For Instructional Use Only.
