Zephurah/ME250-103/Approval Plans/PDF Files/All Part PDFs/18 BOTTOM FRAME.PDF

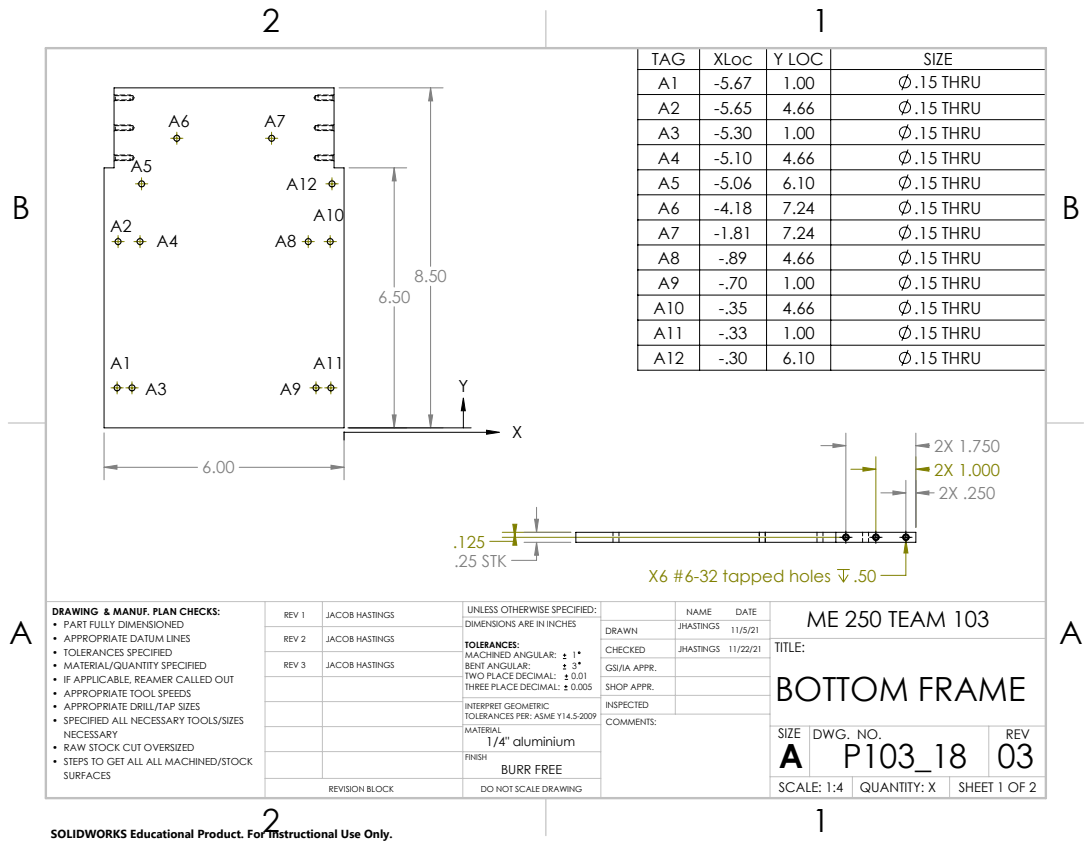
[picture p146: page 1]
X6 #6-32 tapped holes .50; .25 STK

TAG | XLoc | Y LOC | SIZE
A1 | -5.67 | 1.00 | .15 THRU
A2 | -5.65 | 4.66 | .15 THRU
A3 | -5.30 | 1.00 | .15 THRU
A4 | -5.10 | 4.66 | .15 THRU
A5 | -5.06 | 6.10 | .15 THRU
A6 | -4.18 | 7.24 | .15 THRU
A7 | -1.81 | 7.24 | .15 THRU
A8 | -.89 | 4.66 | .15 THRU
A9 | -.70 | 1.00 | .15 THRU
A10 | -.35 | 4.66 | .15 THRU
A11 | -.33 | 1.00 | .15 THRU
A12 | -.30 | 6.10 | .15 THRU

DRAWING & MANUF. PLAN CHECKS: • PART FULLY DIMENSIONED • APPROPRIATE DATUM LINES • TOLERANCES SPECIFIED • MATERIAL/QUANTITY SPECIFIED • IF APPLICABLE, REAMER CALLED OUT • APPROPRIATE TOOL SPEEDS • APPROPRIATE DRILL/TAP SIZES • SPECIFIED ALL NECESSARY TOOLS/SIZES NECESSARY • RAW STOCK CUT OVERSIZED • STEPS TO GET ALL ALL MACHINED/STOCK SURFACES | REV 1 | JACOB HASTINGS | UNLESS OTHERWISE SPECIFIED: | | NAME DATE | ME 250 TEAM 103

DIMENSIONS ARE IN INCHES TOLERANCES: MACHINED ANGULAR: 1 BENT ANGULAR: 3 TWO PLACE DECIMAL: 0.01 THREE PLACE DECIMAL: 0.005 | DRAWN | JHASTINGS 11/5/21

REV 2 | JACOB HASTINGS

CHECKED | JHASTINGS 11/22/21 | TITLE: BOTTOM FRAME

REV 3 | JACOB HASTINGS

GSI/IA APPR.
SHOP APPR.

INTERPRET GEOMETRIC TOLERANCES PER: ASME Y14.5-2009 | INSPECTED
MATERIAL 1/4" aluminium | | SIZE A | DWG. NO. P103_18 | REV 03

FINISH BURR FREE

REVISION BLOCK | DO NOT SCALE DRAWING | | SCALE: 1:4 | QUANTITY: X | SHEET 1 OF 2

SOLIDWORKS Educational Product. For Instructional Use Only.

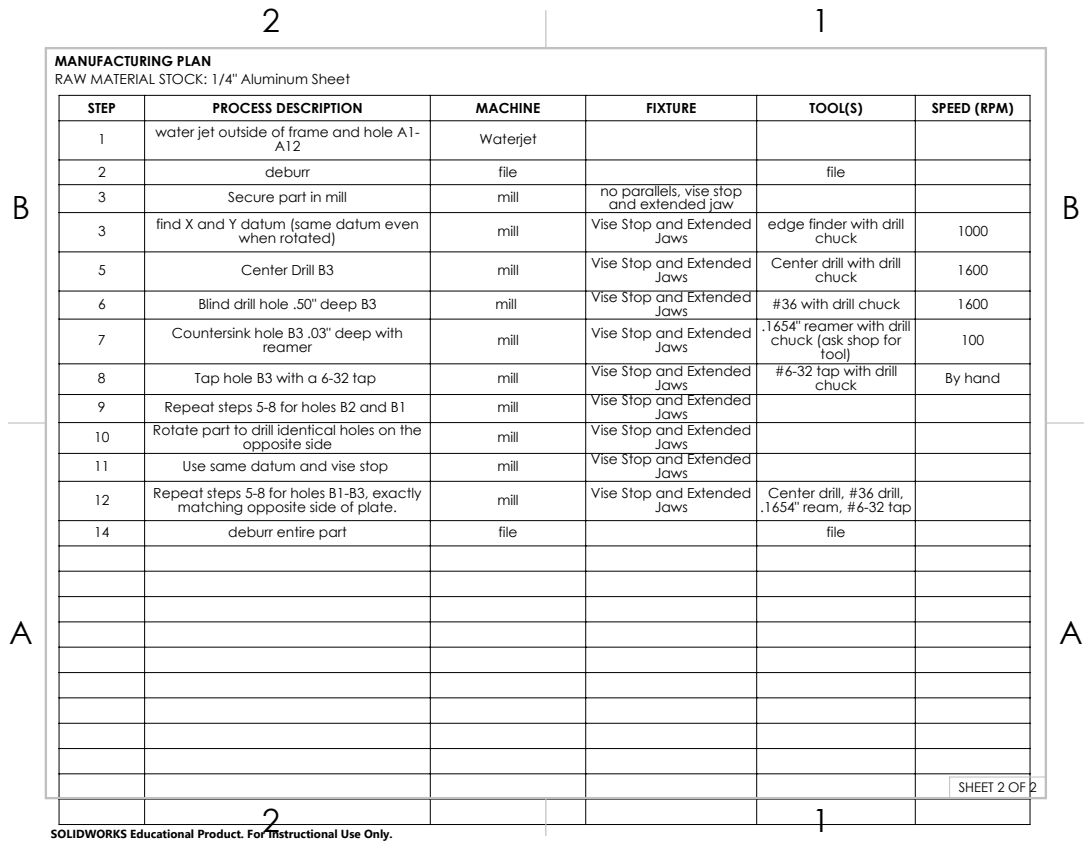
[picture p147: page 2]
STEP; PROCESS DESCRIPTION; MACHINE; FIXTURE; TOOL(S); SPEED (RPM); water jet outside of frame and hole A1-; Secure part in mill; mill; no parallels, vise stop; find X and Y datum (same datum even; when rotated); Vise Stop and Extended; Center Drill B3; Blind drill hole .50" deep B3; Jaws; #36 with drill chuck; Countersink hole B3 .03" deep with; reamer; Tap hole B3 with a 6-32 tap; chuck; By hand; Repeat steps 5-8 for holes B2 and B1; Rotate part to drill identical holes on the; opposite side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

MANUFACTURING PLAN
RAW MATERIAL STOCK: 1/4" Aluminum Sheet

and extended jaw
Jaws

edge finder with drill
Center drill with drill

.1654" reamer with drill
chuck (ask shop for
tool)
#6-32 tap with drill

Center drill, #36 drill,
.1654" ream, #6-32 tap

SOLIDWORKS Educational Product. For Instructional Use Only.
