Zephurah/ME250-103/Approval Plans/PDF Files/All Part PDFs/23 METAL MOTOR DRILL.pdf

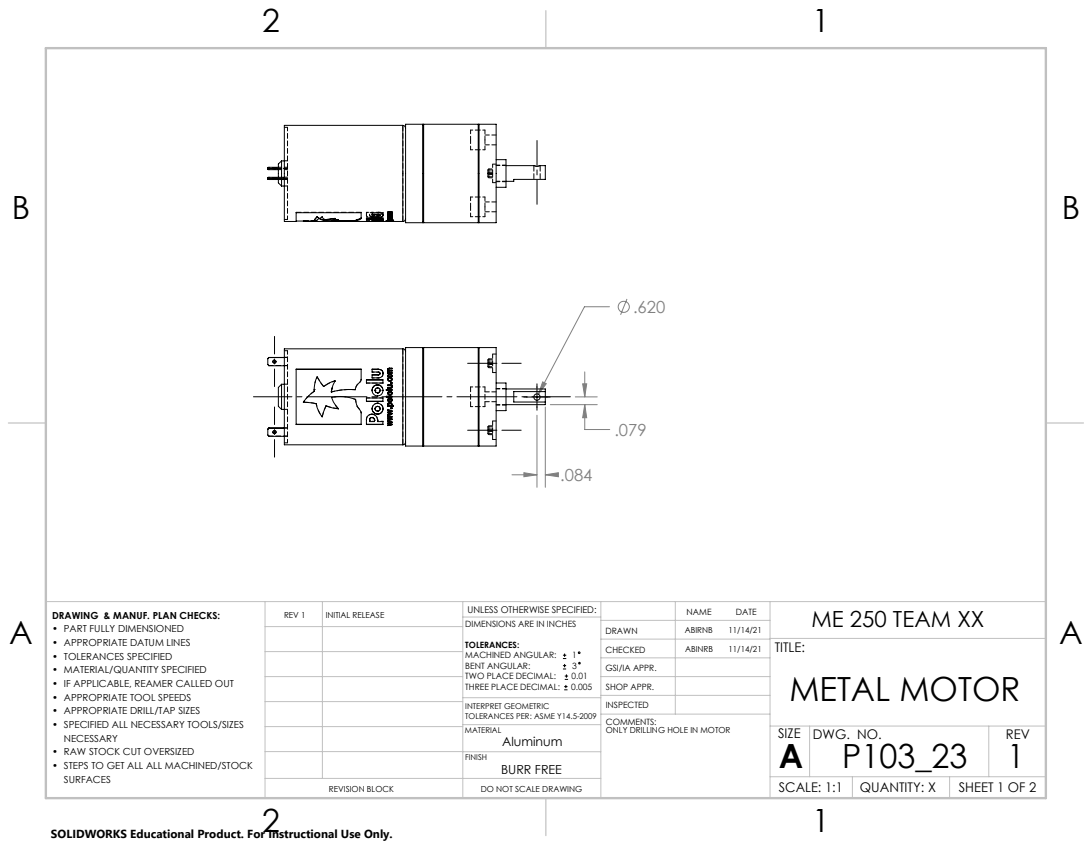
[picture p148: page 1]

DRAWING & MANUF. PLAN CHECKS: • PART FULLY DIMENSIONED • APPROPRIATE DATUM LINES • TOLERANCES SPECIFIED • MATERIAL/QUANTITY SPECIFIED • IF APPLICABLE, REAMER CALLED OUT • APPROPRIATE TOOL SPEEDS • APPROPRIATE DRILL/TAP SIZES • SPECIFIED ALL NECESSARY TOOLS/SIZES NECESSARY • RAW STOCK CUT OVERSIZED • STEPS TO GET ALL ALL MACHINED/STOCK SURFACES | REV 1 | INITIAL RELEASE | UNLESS OTHERWISE SPECIFIED: | | NAME DATE | ME 250 TEAM XX

DIMENSIONS ARE IN INCHES TOLERANCES: MACHINED ANGULAR: 1 BENT ANGULAR: 3 TWO PLACE DECIMAL: 0.01 THREE PLACE DECIMAL: 0.005 | DRAWN | ABIRNB 11/14/21

CHECKED | ABINRB 11/14/21 | TITLE: METAL MOTOR

GSI/IA APPR.
SHOP APPR.

INTERPRET GEOMETRIC TOLERANCES PER: ASME Y14.5-2009 | INSPECTED
MATERIAL Aluminum | | SIZE A | DWG. NO. P103_23 | REV 1

COMMENTS:
ONLY DRILLING HOLE IN MOTOR

FINISH BURR FREE

REVISION BLOCK | DO NOT SCALE DRAWING | | SCALE: 1:1 | QUANTITY: X | SHEET 1 OF 2

SOLIDWORKS Educational Product. For Instructional Use Only.

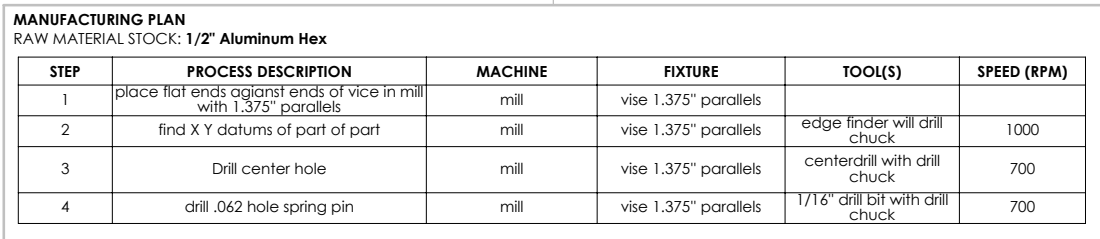
[picture p149: page 2]
SHEET 2 OF 2

MANUFACTURING PLAN
RAW MATERIAL STOCK: 1/2" Aluminum Hex

STEP | PROCESS DESCRIPTION | MACHINE | FIXTURE | TOOL(S) | SPEED (RPM)
1 | place flat ends agianst ends of vice in mill with 1.375'' parallels | mill | vise 1.375'' parallels
2 | find X Y datums of part of part | mill | vise 1.375'' parallels | edge finder will drill chuck | 1000
3 | Drill center hole | mill | vise 1.375'' parallels | centerdrill with drill chuck | 700
4 | drill .062 hole spring pin | mill | vise 1.375'' parallels | 1/16'' drill bit with drill chuck | 700

SOLIDWORKS Educational Product. For Instructional Use Only.
