Zephurah/ME250-103/Approval Plans/PDF Files/All Part PDFs/6 SMALL L BRACKET.pdf

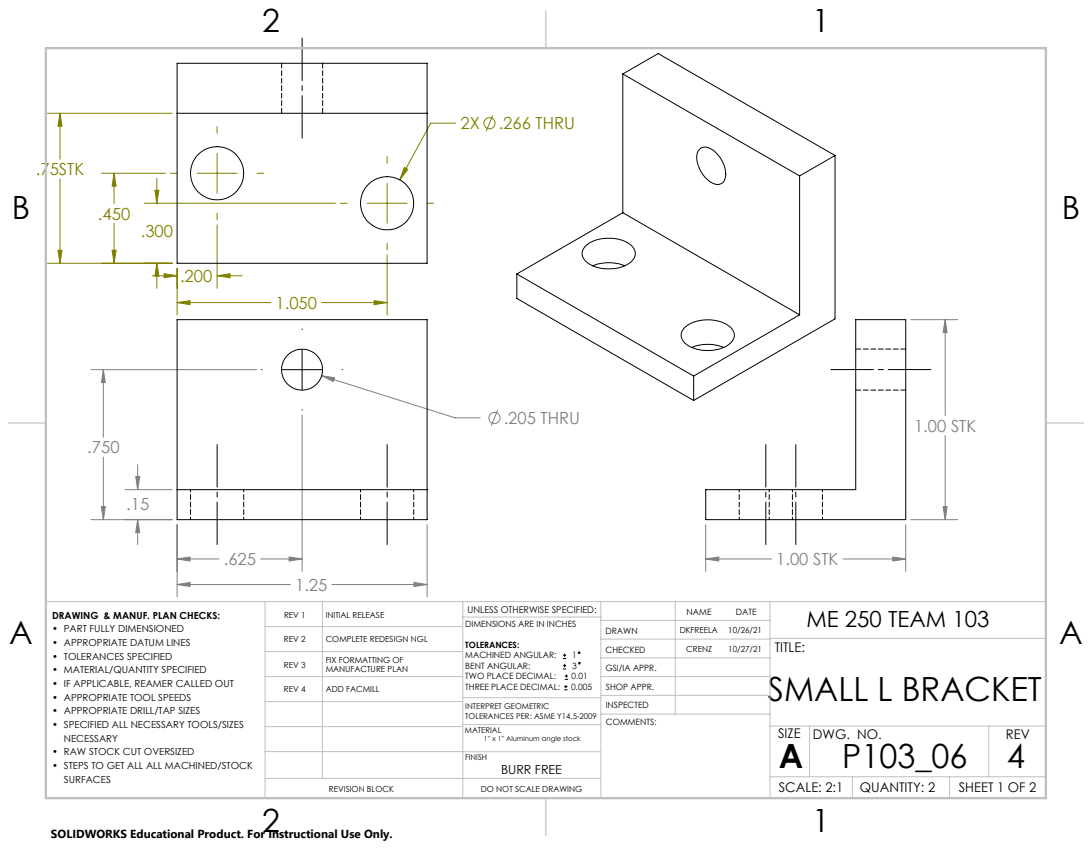
[picture p150: page 1]
.205 THRU; 2X .266 THRU; 1.00 STK

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

DIMENSIONS ARE IN INCHES TOLERANCES: MACHINED ANGULAR: 1 BENT ANGULAR: 3 TWO PLACE DECIMAL: 0.01 THREE PLACE DECIMAL: 0.005 | DRAWN | DKFREELA 10/26/21

REV 2 | COMPLETE REDESIGN NGL

CHECKED | CRENZ 10/27/21 | TITLE: SMALL L BRACKET

REV 3 | FIX FORMATTING OF MANUFACTURE PLAN

GSI/IA APPR.

REV 4 | ADD FACMILL | | SHOP APPR.

INTERPRET GEOMETRIC TOLERANCES PER: ASME Y14.5-2009 | INSPECTED
MATERIAL 1'' x 1'' Aluminum angle stock | | SIZE A | DWG. NO. P103_06 | REV 4

FINISH BURR FREE

REVISION BLOCK | DO NOT SCALE DRAWING | | SCALE: 2:1 | QUANTITY: 2 | SHEET 1 OF 2

SOLIDWORKS Educational Product. For Instructional Use Only.

MANUFACTURING PLAN
RAW MATERIAL STOCK: 1" x 1" x 1/4" Aluminum Angle Stock
STEP | PROCESS DESCRIPTION | MACHINE | FIXTURE | TOOL(S) | SPEED (RPM)
1 | Cut Raw Stock 1.30" | Bandsaw | Bandsaw Vise | --- | ---
2 | Deburr part | File | | File
3 | Face Both side and measure with caliper | Mill | Vise L-Stock Block | 1/2'' endmill with collet | 800
4 | Sercure Angle stock in mill with the back edge on top and other edge around .25" away from vice and use vice stop to constrain in X direction | Mill | Vise L-Stock Block
5 | Cut Down to size of 1.25'' | Mill | Vice L-Stock Block | 1/4'' endmill with chuck | 1000
6 | Find Center using the edge where the 90 degree angle occurs and the top edge | Mill | 1.375" parallels | Edge Finder with Chuck | 1000
7 | centerdrill | Mill | 1.375" parallels | Centerdrill with chuck | 1000
8 | Drill .266" clearance hole through the material | Mill | 1.375" parallels | H Drill Bit with chuck | 1000
9 | Repeat steps 6 and 7 for other 0.266 hole
10 | Rotate Part
11 | centerdrill | Mill | 1.375" parallels | Centerdrill with chuck | 1200
12 | Drill the left .205" clearance hole through the material | Mill | 1.375" parallels | #5 Drill Bit with chuck | 1200
13 | Facemill .25 STK down to .15 | Mill | 1.375'' parallels | 1/2'' endmill with collet | 800
13 | Deburr part | file | | file

SHEET 2 OF 2
2 | 1

A

B

A

B

2 | 1

SOLIDWORKS Educational Product. For Instructional Use Only.
