Zephurah/ME250-103/Approval Plans/PDF Files/All Part PDFs/7 MOTOR BRACKET.pdf

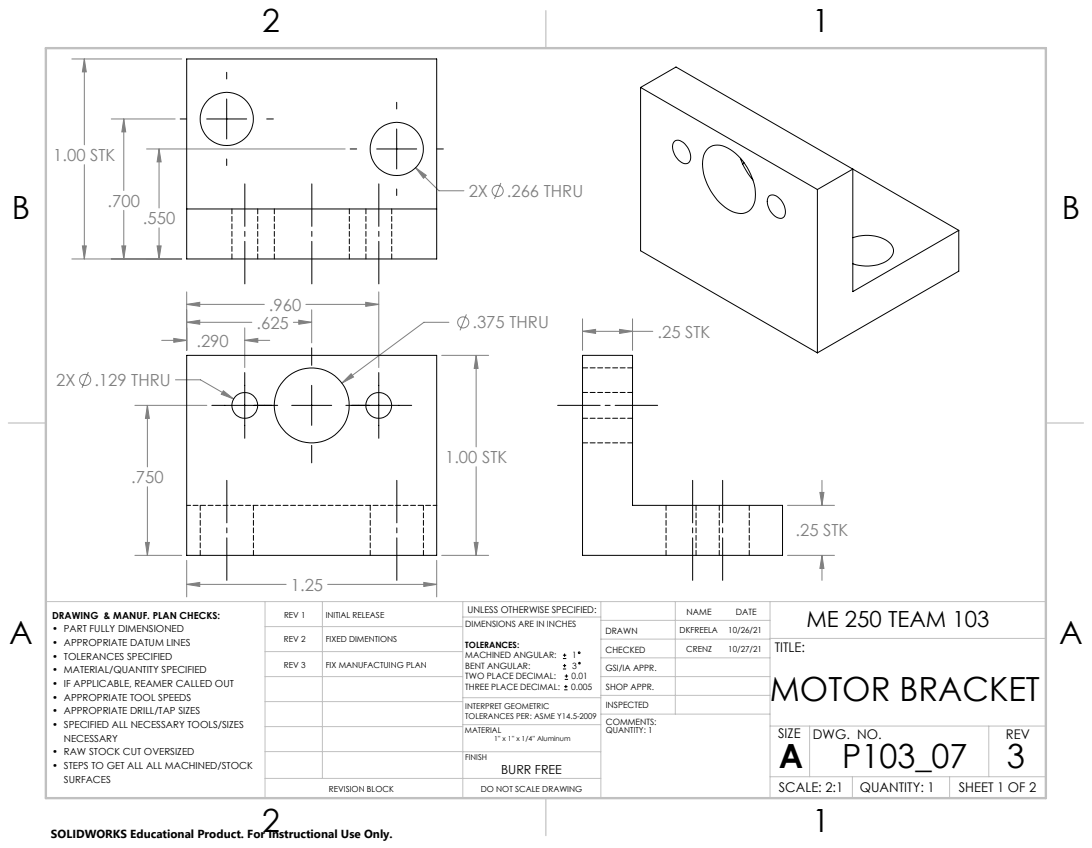
[picture p151: page 1]
2X .129 THRU; .375 THRU; 1.00 STK; .25 STK; 2X .266 THRU; QUANTITY: 1

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

REV 2 | FIXED DIMENTIONS

CHECKED | CRENZ 10/27/21 | TITLE: MOTOR BRACKET

REV 3 | FIX MANUFACTUING PLAN

GSI/IA APPR.
SHOP APPR.

INTERPRET GEOMETRIC TOLERANCES PER: ASME Y14.5-2009 | INSPECTED
MATERIAL 1'' x 1'' x 1/4'' Aluminum | | SIZE A | DWG. NO. P103_07 | REV 3

FINISH BURR FREE

REVISION BLOCK | DO NOT SCALE DRAWING | | SCALE: 2:1 | QUANTITY: 1 | SHEET 1 OF 2

SOLIDWORKS Educational Product. For Instructional Use Only.

MANUFACTURING PLAN
RAW MATERIAL STOCK: 1" x 1" x 1/4" Aluminum Angle Stock
STEP | PROCESS DESCRIPTION | MACHINE | FIXTURE | TOOL(S) | SPEED (RPM)
1 | Cut Raw Stock 1.250" | Bandsaw | Bandsaw Vise | --- | ---
2 | Deburr part | File | | File
3 | Face off both sides and meausre with caliper | Mill | Vise L - stock Block | 1/4'' endmill with chuck | 1000
4 | Sercure Angle stock in mill with the back edge on top and other edge on the outside of the parallels around .25" away from vice and use vice stop to constrain in X direction | Mill | Vise L - stock Block
5 | Cut to length step with L-stock block | Mill | Vice L - stock Blcok | 1/4'' endmill with chuck | 1000
6 | Find Center using the edge where the 90 degree angle occurs and the top edge | Mill | 1.375" parallels | Edge Finder with Chuck | 1000
7 | centerdrill | Mill | 1.375" parallels | Centerdrill with chuck | 800
8 | Drill center .375" clearance hole through the material | Mill | 1.375" parallels | 3/8 Drill Bit with chuck | 800
9 | centerdrill | Mill | 1.375" parallels | Centerdrill with chuck | 1600
10 | Drill the left .129" clearance hole through the material | Mill | 1.375" parallels | #30 Drill Bit with chcuk | 1600
11 | centerdrill | Mill | 1.375" parallels | Centerdrill with chuck | 1600
12 | Drill the right .129" clearance hole through the material | Mill | 1.375" parallels | #30 Drill Bit with chuck | 1600
13 | Rotate Part
14 | Part is already centered using the same vice stop location | Mill | 1.375" parallels | Edge Finder | 1000
15 | centerdrill | Mill | 1.375" parallels | Centerdrill with chuck | 1400
16 | Drill the left .266" clearance hole through the material | Mill | 1.375" parallels | .266 Drill Bitt with chuck | 1400
17 | centerdrill | Mill | 1.375" parallels | Centerdrill with chuck | 1400
18 | Drill the right .266" clearance hole through the material | Mill | 1.375" parallels | .266 Drill Bit with chuck | 1400
19 | Deburr part | file | | file

SHEET 2 OF 2
2 | 1

A

B

A

B

2 | 1

SOLIDWORKS Educational Product. For Instructional Use Only.
