Zephurah/ME250-103/Approval Plans/PDF Files/All Part PDFs/8 CONNECTING SHAFT.pdf

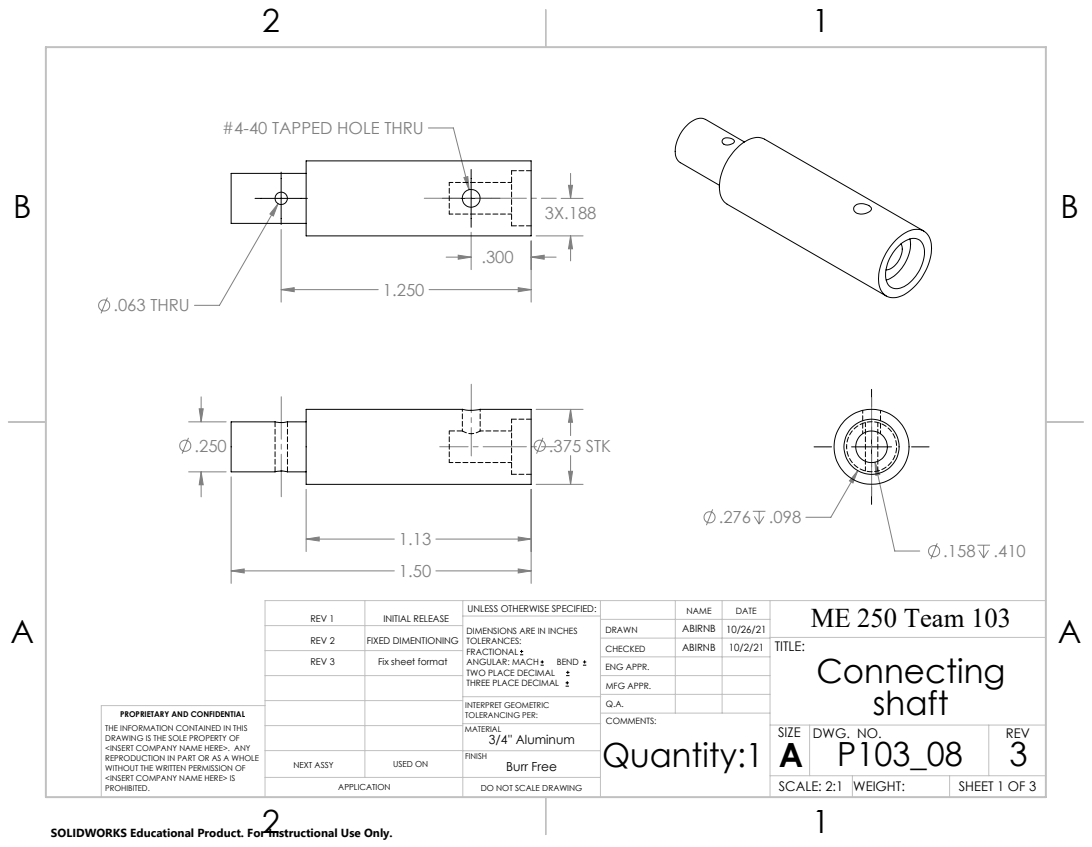
[picture p152: page 1]
.375 STK; .063 THRU

#4-40 TAPPED HOLE THRU

REV 1 | INITIAL RELEASE | UNLESS OTHERWISE SPECIFIED: | | | DATE | ME 250 Team 103 NAME

DIMENSIONS ARE IN INCHES TOLERANCES: FRACTIONAL ANGULAR: MACH BEND TWO PLACE DECIMAL THREE PLACE DECIMAL | DRAWN | ABIRNB | 10/26/21

REV 2 | FIXED DIMENTIONING
REV 3 | Fix sheet format

CHECKED | ABIRNB | 10/2/21 | TITLE: Connecting shaft

ENG APPR.
MFG APPR.

INTERPRET GEOMETRIC TOLERANCING PER: | Q.A.
MATERIAL 3/4'' Aluminum | | SIZE A | DWG. NO. P103_08 | REV 3

PROPRIETARY AND CONFIDENTIAL
THE INFORMATION CONTAINED IN THIS
DRAWING IS THE SOLE PROPERTY OF
<INSERT COMPANY NAME HERE>. ANY
REPRODUCTION IN PART OR AS A WHOLE
WITHOUT THE WRITTEN PERMISSION OF
<INSERT COMPANY NAME HERE> IS
PROHIBITED.

NEXT ASSY | USED ON | Burr Free FINISH

APPLICATION | DO NOT SCALE DRAWING | | SCALE: 2:1 | WEIGHT: | SHEET 1 OF 3

SOLIDWORKS Educational Product. For Instructional Use Only.

MANUFACTURING PLAN
RAW MATERIAL STOCK: 3/4'' Aluminum Round Stock
STEP | PROCESS DESCRIPTION | MACHINE | FIXTURE | TOOL(S) | SPEED (RPM)
STEP | PROCESS DESCRIPTION | MACHINE | FIXTURE | TOOL(S) | SPEED (RPM)
1 | Cut out .625'' of 3/8'' aluminum stock | - | - | - | 300 ft/min
2 | Deburr the ends of the surfaces | Lathe | - | FIle | -
3 | Place in lathe and face off to get a machined surface | Lathe | 3/4 '' Collet | Cutting tool | 750
4 | Deburr the part | - | - | File
5 | Remove part from lathe and flip | - | - | - | -
6 | Repeat steps 3 and 4 | Callipers | - | - | 750
7 | Remove part from lathe and measure with callipers | Lathe | - | - | -
8 | touch off with parting tool and zero x. Cut to length taking passes of 0.050" or less | Lathe | 3/4 '' Collet | Parting Tool | 750
9 | Trim the final .375 inches down to a 0.25" diameter | Lathe | 3/4'' Collet | Parting Tool | 750
10 | Centerdrill | Lathe | 3/4'' Collet | Centrerdrill with drill Chuck | 1000
11 | On the thicker side of the shaft, drill a .277" diamter hole .098 deep | Lathe | 3/4'' Collet | Size J drill with drill chuck | 1000
12 | Center Drill | Lathe | 3/4'' Collet | Centerdrill with drill chuck | -
13 | Zero Out drill at the end of the big hole and drill in .410" with diameter .159" | - | 3/4'' Collet | 21 drill bit Drill Chuck | 1400
14 | Deburr the part | Mill | - | File

SHEET 2 OF 3 -
2 | 1

A

B

A

B

2 | 1

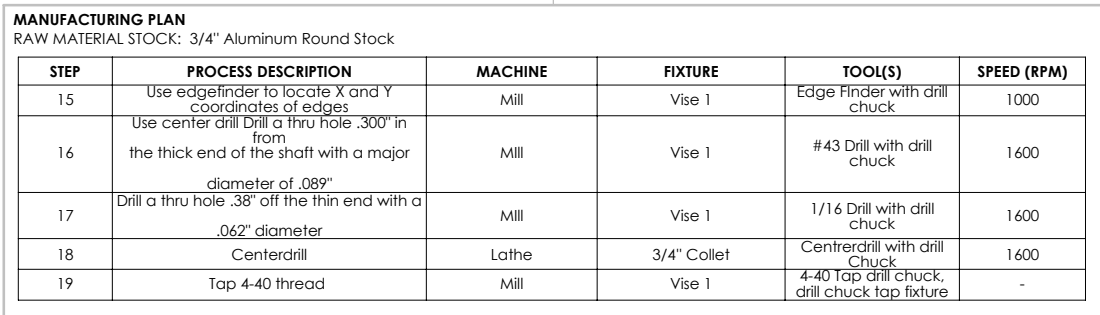
[picture p153: page 3]
SHEET 3 OF 3

MANUFACTURING PLAN
RAW MATERIAL STOCK: 3/4'' Aluminum Round Stock

STEP | PROCESS DESCRIPTION | MACHINE | FIXTURE | TOOL(S) | SPEED (RPM)
15 | Use edgefinder to locate X and Y coordinates of edges | Mill | Vise 1 | Edge FInder with drill chuck | 1000
16 | Use center drill Drill a thru hole .300" in from the thick end of the shaft with a major diameter of .089" | MIll | Vise 1 | #43 Drill with drill chuck | 1600

17 | Drill a thru hole .38" off the thin end with a .062" diameter | MIll | Vise 1 | 1/16 Drill with drill chuck | 1600

18 | Centerdrill | Lathe | 3/4'' Collet | Centrerdrill with drill Chuck | 1600
19 | Tap 4-40 thread | Mill | Vise 1 | 4-40 Tap drill chuck, drill chuck tap fixture | -
