Zephurah/ME250-103/Approval Plans/PDF Files/All Part PDFs/15 SQUARE BRACKET.pdf

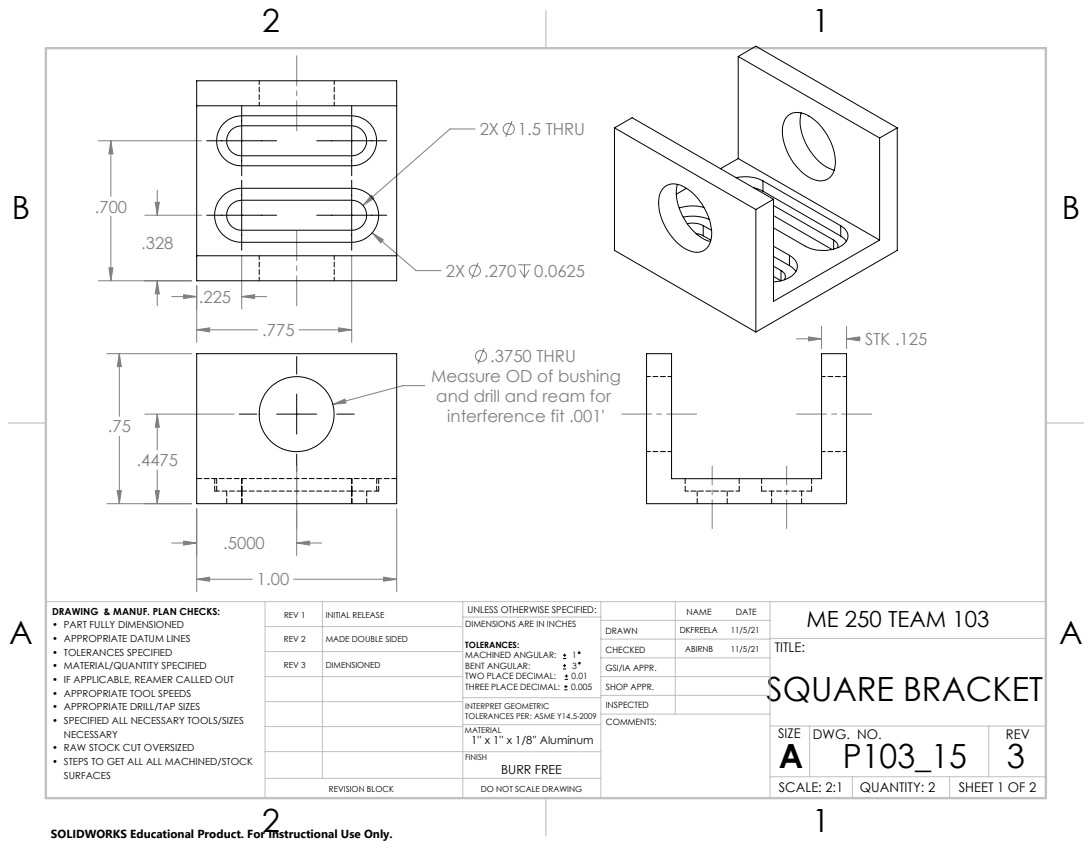
[picture p154: page 1]
STK .125; 2X 1.5 THRU; SQUARE BRACKET

.3750 THRU
Measure OD of bushing
and drill and ream for
interference fit .001'

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

DIMENSIONS ARE IN INCHES TOLERANCES: MACHINED ANGULAR: 1 BENT ANGULAR: 3 TWO PLACE DECIMAL: 0.01 THREE PLACE DECIMAL: 0.005 | DRAWN | DKFREELA 11/5/21

REV 2 | MADE DOUBLE SIDED

CHECKED | ABIRNB 11/5/21 | TITLE:

REV 3 | DIMENSIONED

GSI/IA APPR.
SHOP APPR.

INTERPRET GEOMETRIC TOLERANCES PER: ASME Y14.5-2009 | INSPECTED
MATERIAL 1'' x 1'' x 1/8'' Aluminum | | SIZE A | DWG. NO. P103_15 | REV 3

FINISH BURR FREE

REVISION BLOCK | DO NOT SCALE DRAWING | | SCALE: 2:1 | QUANTITY: 2 | SHEET 1 OF 2

SOLIDWORKS Educational Product. For Instructional Use Only.

MANUFACTURING PLAN
RAW MATERIAL STOCK: 1" x 1" x 1/8" Square Aluminum Tube
STEP | PROCESS DESCRIPTION | MACHINE | FIXTURE | TOOL(S) | SPEED (RPM)
1 | Cut down to 1.25'' in bandsaw | bandsaw | | | 300 ft/sec
2 | place in vise | Mill | Vise with 1.375'' parallels
3 | Face Off | Mill | Vise with 1.375'' parallels | 1/4'' endmill and collet | 700
3 | Cut down to 1.00'' | Mill | Cutting tool | 1/4'' endmill and collet | 700
4 | Centerdrill | Mill | Vise with 1.375'' parallels | Drill Chuck and centerdrill | 100
5 | Drill .375'' hole thru | Mill | Vise with 1.375'' parallels | H bit with drill chuck | 700
6 | Ream hole | Mill | Vise with 1.375'' parallels | 3/8" Ream | 100
7 | Filp part | Mill | Vise with 1.375'' parallels | - | -
8 | Cut off top of part with passes | Mill | Vise with 1.375'' parallels | 3/8" Endmill with collet | 700
9 | Cut Counterbore with H cutting bit with .0625'' depth | Mill | Vise with 1.375'' parallels | H bit with collet | 700
10 | Cut slot thru | Mill | Vise with 1.375'' parallels | #25 Bit with collet | 1100
11 | Deburr | file | - | file

SHEET 2 OF 2
2 | 1

A

B

A

B

2 | 1

SOLIDWORKS Educational Product. For Instructional Use Only.
