Zephurah/ME250-103/Approval Plans/PDF Files/All Part PDFs/14 BRUSH BRACKET.pdf

B

B

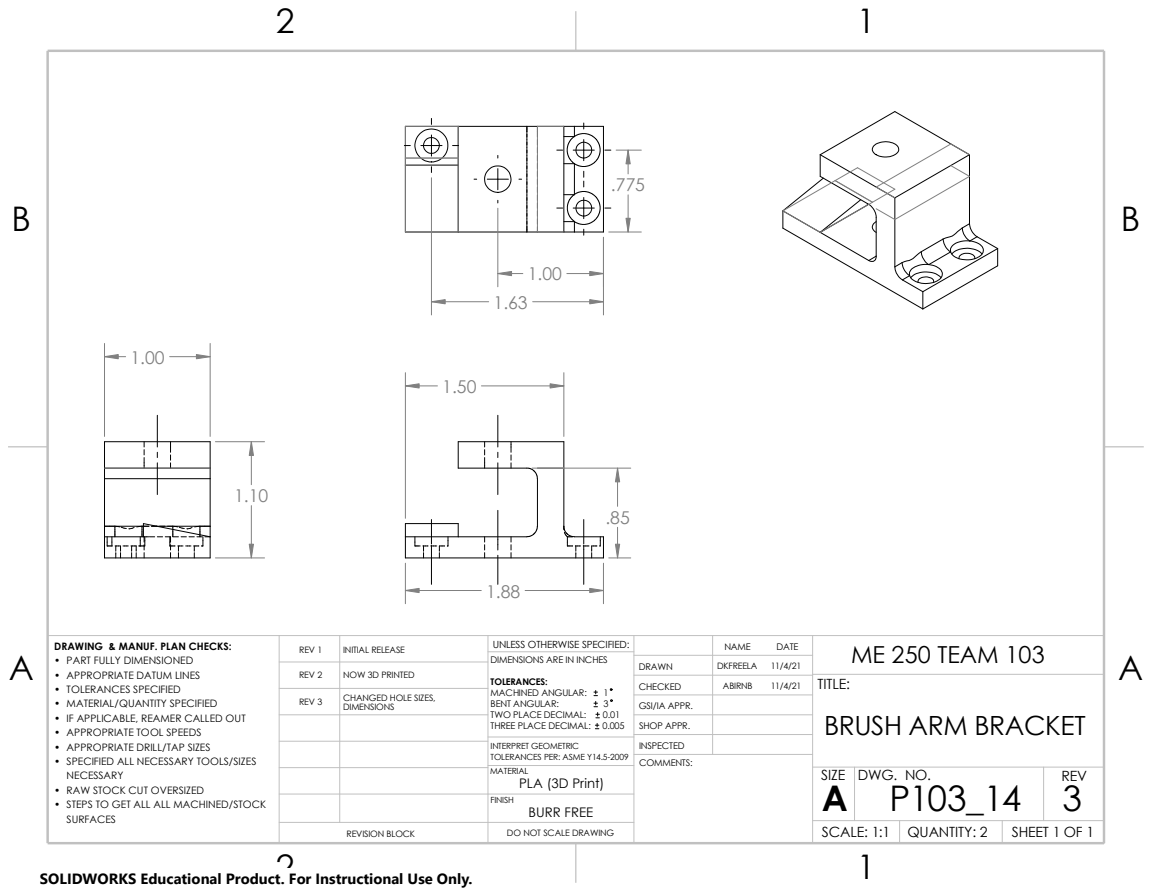
[picture p155: page 1]
COMMENTS:

DRAWING & MANUF. PLAN CHECKS: • PART FULLY DIMENSIONED • APPROPRIATE DATUM LINES • TOLERANCES SPECIFIED • MATERIAL/QUANTITY SPECIFIED • IF APPLICABLE, REAMER CALLED OUT • APPROPRIATE TOOL SPEEDS • APPROPRIATE DRILL/TAP SIZES • SPECIFIED ALL NECESSARY TOOLS/SIZES NECESSARY • RAW STOCK CUT OVERSIZED • STEPS TO GET ALL ALL MACHINED/STOCK | REV 1 | INITIAL RELEASE | UNLESS OTHERWISE SPECIFIED: | | NAME DATE | ME 250 TEAM 103

DIMENSIONS ARE IN INCHES TOLERANCES: MACHINED ANGULAR: 1 BENT ANGULAR: 3 TWO PLACE DECIMAL: 0.01 THREE PLACE DECIMAL: 0.005 | DRAWN | DKFREELA 11/4/21

REV 2 | NOW 3D PRINTED

CHECKED | ABIRNB 11/4/21 | TITLE: BRUSH ARM BRACKET

CHANGED HOLE SIZES, REV 3 DIMENSIONS

GSI/IA APPR.
SHOP APPR.

INTERPRET GEOMETRIC TOLERANCES PER: ASME Y14.5-2009 | INSPECTED
MATERIAL PLA (3D Print) | | SIZE A | DWG. NO. P103_14 | REV 3

FINISH BURR FREE SURFACES

REVISION BLOCK | DO NOT SCALE DRAWING | | SCALE: 1:1 | QUANTITY: 2 | SHEET 1 OF 1

SOLIDWORKS Educational Product. For Instructional Use Only.
