Zephurah/ME250-103/Approval Plans/PDF Files/All Part PDFs/22 DOUBLE GEAR BOX ADAPTER SHAFT.pdf

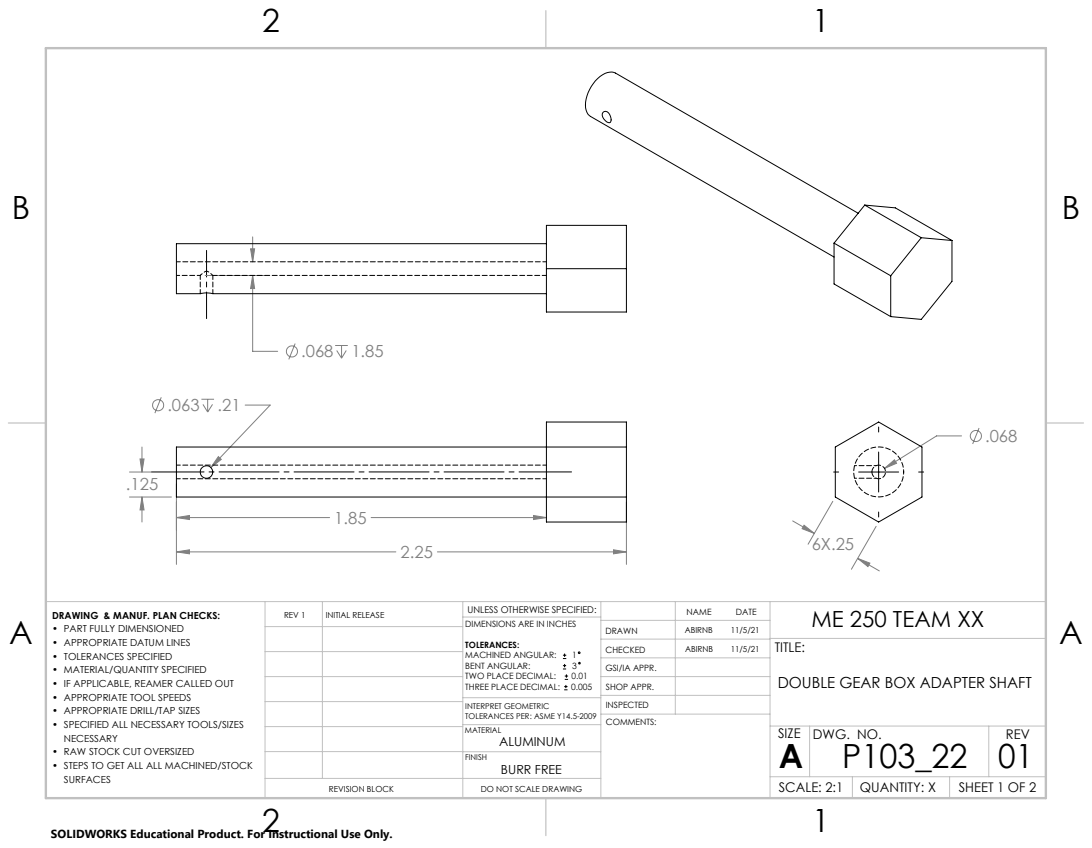
[picture p156: page 1]
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

DIMENSIONS ARE IN INCHES TOLERANCES: MACHINED ANGULAR: 1 BENT ANGULAR: 3 TWO PLACE DECIMAL: 0.01 THREE PLACE DECIMAL: 0.005 | DRAWN | ABIRNB 11/5/21

CHECKED | ABIRNB 11/5/21 | TITLE: DOUBLE GEAR BOX ADAPTER SHAFT

GSI/IA APPR.
SHOP APPR.

INTERPRET GEOMETRIC TOLERANCES PER: ASME Y14.5-2009 | INSPECTED
MATERIAL ALUMINUM | | SIZE A | DWG. NO. P103_22 | REV 01

FINISH BURR FREE

REVISION BLOCK | DO NOT SCALE DRAWING | | SCALE: 2:1 | QUANTITY: X | SHEET 1 OF 2

SOLIDWORKS Educational Product. For Instructional Use Only.

MANUFACTURING PLAN
RAW MATERIAL STOCK: 1/2" Aluminum Hex
STEP | PROCESS DESCRIPTION | MACHINE | FIXTURE | TOOL(S) | SPEED (RPM)
1 | Cut down to 2.5'' | Band Saw | - | - | 300 ft/min
2 | Deburr the ends of the surfaces | Lathe | - | FIle | -
3 | Place in lathe and face off to get a machined surface | Lathe | Collet | -
4 | Deburr the part | - | Collet | File | 750
5 | Remove part from lathe and flip | - | - | - | -
6 | Repeat steps 3 and 4 | Callipers | - | - | -
7 | Remove part from lathe and measure with callipers | Lathe | - | - | -
8 | touch off with parting tool and zero x. Cut to length taking passes of 0.050" or less | Lathe | Collet | Parting Tool | 750
9 | Trim down to 2.25'' | Lathe | Collet | Parting Tool | 750
10 | Mill down 1.85'' to a diameter of .25'' | Lathe | Collet | Cutting Tool
11 | Centerdill | Lathe | Collet | Denter Drill with Drill chuck | 100
12 | Drill .068'' drill to depth of 1.85;; | Lathe | Collet | Drill with Drill chuck | 700
13 | Deburr the part | File | - | File | -
14 | Use edgefinder to locate X and Y coordinates of edges | Mill | - | Edge FInder | 1000
15 | Use center drill Drill a thru hole .26" in from the thick end of the shaft with a major diameter of .089" | Mill | Vise 1.375'' | #43 Drill | 1000
16 | Drill a thru hole .15" off the thin end with a .063" diameter | Mill | Vise 1.375'' | 1/16 Drill | 1000

SHEET 2 OF 2
2 | 1

A

B

A

B

2 | 1

SOLIDWORKS Educational Product. For Instructional Use Only.
