Zephurah/ME250-103/Approval Plans/PDF Files/All Part PDFs/20 BRUSH SUPPORT.pdf

B

B

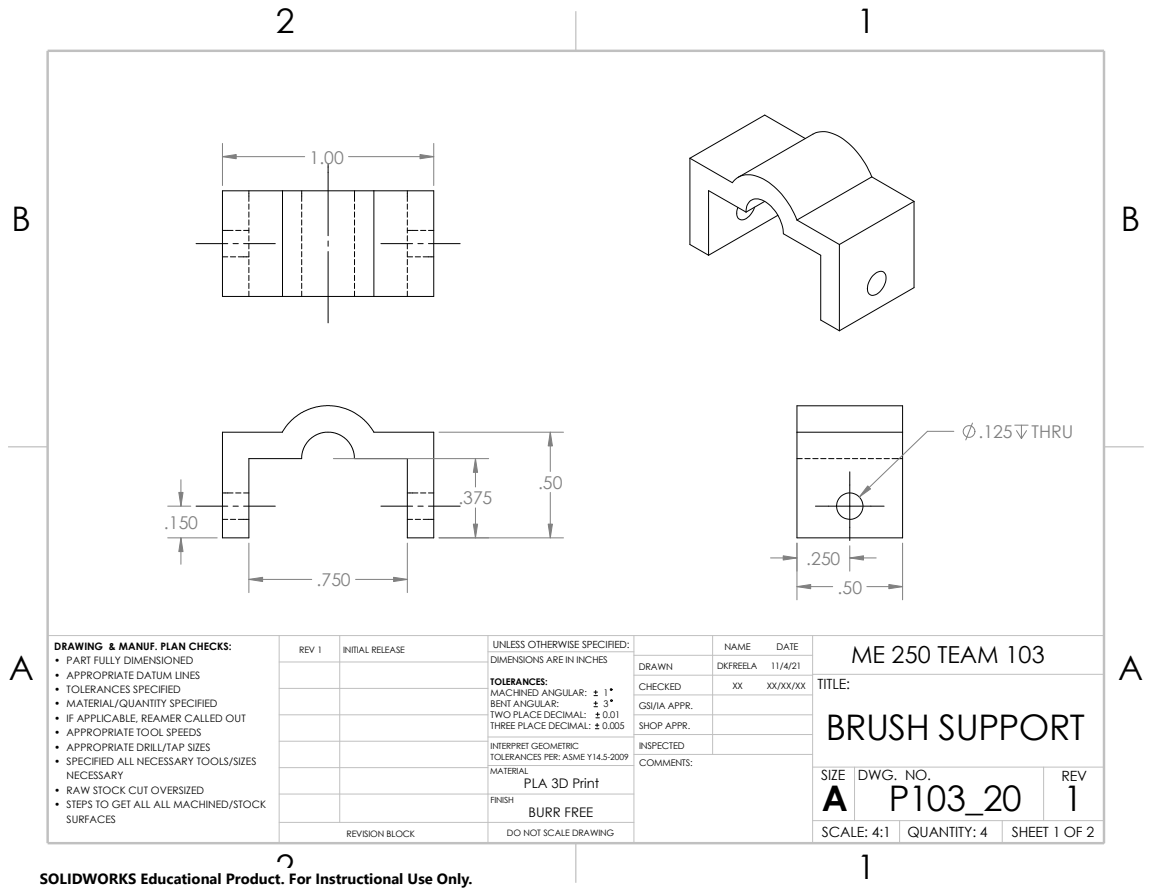
[picture p157: page 1]
COMMENTS:; THRU

DRAWING & MANUF. PLAN CHECKS: • PART FULLY DIMENSIONED • APPROPRIATE DATUM LINES • TOLERANCES SPECIFIED • MATERIAL/QUANTITY SPECIFIED • IF APPLICABLE, REAMER CALLED OUT • APPROPRIATE TOOL SPEEDS • APPROPRIATE DRILL/TAP SIZES • SPECIFIED ALL NECESSARY TOOLS/SIZES NECESSARY • RAW STOCK CUT OVERSIZED • STEPS TO GET ALL ALL MACHINED/STOCK SURFACES | REV 1 | INITIAL RELEASE | UNLESS OTHERWISE SPECIFIED: | | NAME DATE | ME 250 TEAM 103

DIMENSIONS ARE IN INCHES TOLERANCES: MACHINED ANGULAR: 1 BENT ANGULAR: 3 TWO PLACE DECIMAL: 0.01 THREE PLACE DECIMAL: 0.005 | DRAWN | DKFREELA 11/4/21

CHECKED | XX XX/XX/XX | TITLE: BRUSH SUPPORT

GSI/IA APPR.
SHOP APPR.

INTERPRET GEOMETRIC TOLERANCES PER: ASME Y14.5-2009 | INSPECTED
MATERIAL PLA 3D Print | | SIZE A | DWG. NO. P103_20 | REV 1

FINISH BURR FREE

REVISION BLOCK | DO NOT SCALE DRAWING | | SCALE: 4:1 | QUANTITY: 4 | SHEET 1 OF 2

SOLIDWORKS Educational Product. For Instructional Use Only.

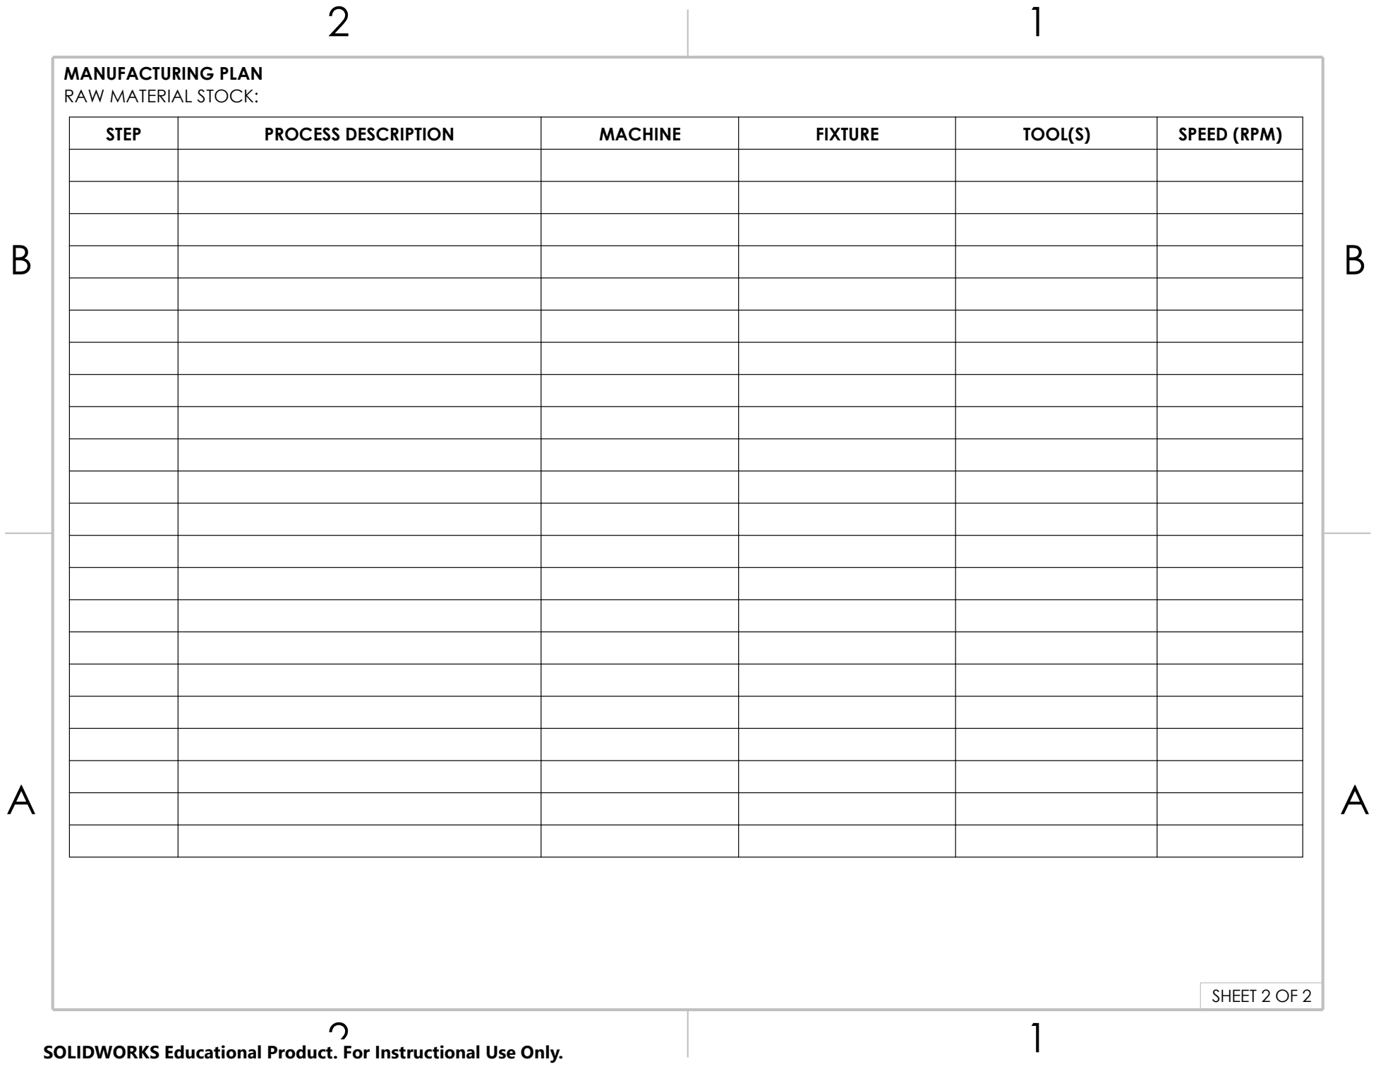
[picture p158: figure]
SHEET 2 OF 2; MANUFACTURING PLAN RAW MATERIAL STOCK:

STEP | PROCESS DESCRIPTION | MACHINE | FIXTURE | TOOL(S) | SPEED (RPM)

SOLIDWORKS Educational Product. For Instructional Use Only.
