Zephurah/ME250-103/Approval Plans/PDF Files/All Part PDFs/4 SCOOPER.pdf

B B

2

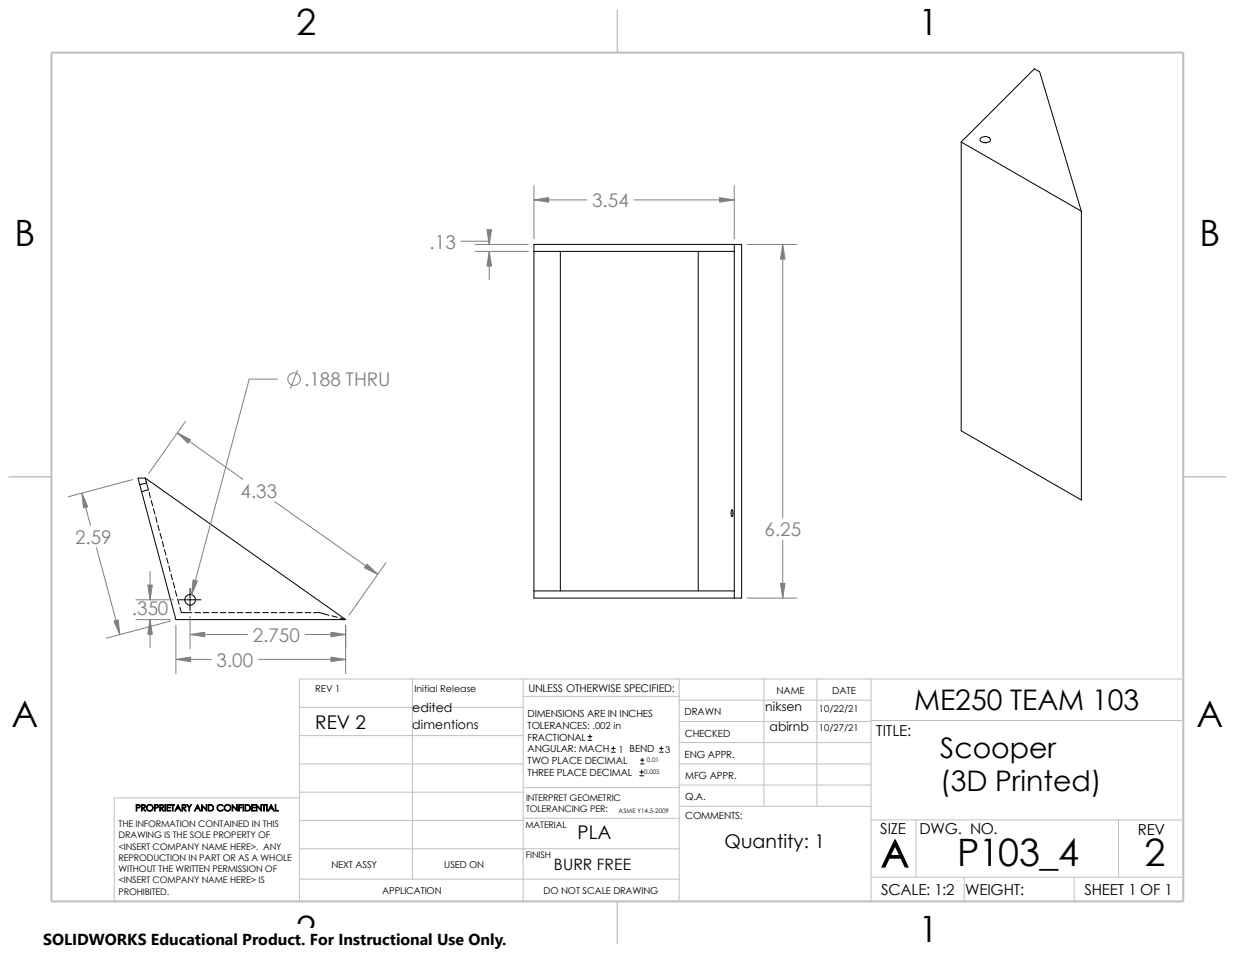
[picture p161: page 1]
COMMENTS:; INTERPRET GEOMETRIC; PROPRIETARY AND CONFIDENTIAL; TOLERANCING PER:; dimentions; Quantity: 1; ASME Y14.5-2009; REV 2; .188 THRU

REV 1 | Initial Release edited | UNLESS OTHERWISE SPECIFIED: | | NAME | DATE | ME250 TEAM 103

DIMENSIONS ARE IN INCHES TOLERANCES: .002 in FRACTIONAL ANGULAR: MACH 1 3 BEND TWO PLACE DECIMAL 0.01 THREE PLACE DECIMAL 0.005 | DRAWN | niksen | 10/22/21

CHECKED | abirnb | 10/27/21 | TITLE: Scooper (3D Printed)

ENG APPR.
MFG APPR.

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

MATERIAL PLA | | SIZE A P103_4 | DWG. NO. | REV 2

NEXT ASSY | USED ON | FINISH BURR FREE

APPLICATION | DO NOT SCALE DRAWING | | SCALE: 1:2 | WEIGHT: | SHEET 1 OF 1

SOLIDWORKS Educational Product. For Instructional Use Only.
