Zephurah/ME250-103/(commit log)

2021-10-25 Added current
    [.063 Alum Plate.SLDPRT, .3 X.5 .0625TH L bracket.SLDPRT, 0.500 inch Spring Pin.SLDPRT, 1-4 bushing.SLDPRT, 24 tooth Gear.SLDASM, 24 tooth Gear.SLDPRT, 2662N25_20 Degree Pressure Angle Plastic Gear.SLDPRT, 3 X.5 .0625TH L bracket.SLDPRT]
2021-10-25 Lig
    Ligma
    [Conncting Shaft Drawing.SLDDRW]
2021-10-26 approval plans
    [Left Lever Arm.SLDDRW, Lever Arm Drawing and MFG.SLDDRW, Lever Motor Arm Axel.SLDDRW, Lever Motor Arm.SLDDRW]
2021-10-27 added small l bracket drawing
    [ME250 DRAWING TEMPLATE.SLDDRW, Small L Bracket.SLDDRW]
2021-10-27 moved pdf drawings, added motor bracket and connecting shaft drawing
    [Connecting Shaft.SLDDRW, Motor Bracket.SLDDRW]
2021-10-27 fixed bracket
    [Small L Backet.SLDPRT, Small L Bracket.SLDDRW]
2021-10-27 scooper
    updated according to patrick's comments
    [Scooper plans.SLDDRW]
2021-10-27 update
    update
    [Scooper plans.SLDDRW, Small L Backet.SLDPRT, Small L Bracket.SLDDRW]
2021-10-27 updated assemblies
    [Connecting Shaft.SLDPRT, Final Arm Assembly.SLDASM, Gear Motor Bracket Assy 2.SLDASM]
2021-10-28 motor bracket
    updated thickness
    [Motor Bracket.SLDDRW, Motor Bracket.SLDPRT]
2021-10-28 removed ~$ files, fixed assembly
    [3 mm screw.SLDPRT, 4-40 set screw.SLDPRT, Final Arm Assembly.SLDASM, Final Driving Lever Arm.SLDASM, Spring Pin.SLDPRT]
2021-10-28 changed part numbers for clarity
    [Connecting Shaft.SLDDRW, Left Lever Arm.SLDDRW, Lever Arm Drawing and MFG.SLDDRW, Motor Bracket.SLDDRW, ROPE WINDER.SLDDRW, Small L Bracket.SLDDRW]
2021-10-28 added new pdf files with correct part numbers, names
    [Scooper plans.SLDDRW]
2021-10-28 Create screw with shoulder REAL.SLDPRT
    [screw with shoulder REAL.SLDPRT]
2021-10-28 added nuts to assem
    [Final Arm Assembly.SLDASM]
2021-10-28 added ms5 submission
    [Final Arm Assembly.SLDASM]
2021-10-30 Too much
    [0.500 inch Spring Pin.SLDPRT, Conncting Shaft Drawing.SLDDRW, Connecting Shaft.SLDDRW, Final Arm Assembly.SLDASM, Final Driving Lever Arm.SLDASM, Left Lever Arm APPROVED.SLDDRW, Lever Arm W motor APPROVED.SLDDRW, Lever Motor Arm Axel.SLDDRW]
2021-11-01 updated brush design
    changed brush from old design to new in the file system
    [1-4 bushing.SLDPRT, 94210A125_Medium-Strength Threaded Rod - 10in.SLDPRT, Bracket.SLDPRT, Brush Arm.SLDASM, Brush arm bracket mirrored.SLDPRT, Brush.SLDPRT, Locking pin.SLDPRT, support.SLDPRT]
2021-11-01 new RMP assembly
    created new assembly incorporating the frame, brush, and arm changes to be more cohesive.
    May have broken other links
    [Gear Motor Bracket Assy 2.SLDASM, Gear Motor Bracket Assy with String.SLDASM, New Frame with individual sides.SLDASM, The Final Assembly.SLDASM, WheelTreadAssem.SLDASM]
2021-11-01 name change
    [Scooper APPROVED.SLDDRW]
2021-11-02 Frame changes
    [Bottom frame.SLDPRT, New Control Box rough dimensions.SLDPRT, New Frame with individual sides.SLDASM, Side frame.SLDPRT, Top frame.SLDPRT]
2021-11-02 Frame work
    [#6-32 .5.SLDPRT, Bottom frame.SLDPRT, New Frame with individual sides.SLDASM, Top frame.SLDPRT]
2021-11-03 shortened frame
    made frame a few inches shorter
    [New Frame with individual sides.SLDASM, Side frame.SLDPRT]
2021-11-04 updated brush and new bracket
    brush mounting bracket and axle mounting bracket updated
    [Axle and Brush Bracket.SLDPRT, Bracket.SLDPRT, Brush Arm.SLDASM]
2021-11-04 added brush bracket drawing
    [Bracket.SLDPRT, Brush Arm.SLDASM, Brush Bracket.SLDDRW]
2021-11-04 drawings made
    created drawings for axle and brush bracket
    [Axle Bracket.SLDDRW, Brush Bracket.SLDDRW]
2021-11-04 Update Conncting Shaft Drawing.SLDDRW
    [Conncting Shaft Drawing.SLDDRW]
2021-11-05 update 3
    created brush support drawing, updated brush bracket quantity
    [Brush Bracket 2.SLDDRW, Brush Support.SLDDRW]
2021-11-05 Update ~$Motor Bracket.SLDDRW
2021-11-05 Create ~$Conncting Shaft Drawing.SLDDRW
2021-11-05 axle and treads
    [Finished treads with axle.SLDASM, Scooper.STL, WheelTreads W screws.SLDASM]
2021-11-05 front axle
    [Front axle.SLDASM, Wheel axle.SLDPRT, motor shaft.SLDPRT]
2021-11-06 update from patrick
    [Conncting Shaft Drawing.SLDDRW, Connecting Shaft.SLDDRW, Connecting Shaft.SLDPRT, Scooper plans.SLDDRW]
2021-11-06 square bracket.SLDPRT
    [square bracket.SLDPRT]
2021-11-06 Square Bracket.SLDDRW
    [Square Bracket.SLDDRW]
2021-11-06 Square Bracket
    [Square Bracket.SLDDRW]
2021-11-06 top frame approval plan
    [Top Frame.SLDDRW]
2021-11-09 Clean up, frame rework
    [Axle Bracket.SLDDRW, Bottom frame.SLDDRW, Bottom frame.SLDPRT, Brush Bracket.SLDDRW, Brush Support.SLDDRW, Conncting Shaft Drawing.SLDDRW, Connecting Shaft.SLDDRW, Lever Motor Arm Axel.SLDDRW]
2021-11-09 updated brush bracket
    [Bracket.SLDPRT, Brush Bracket.SLDDRW, Brush Support.SLDDRW]
2021-11-09 changed square bracket
    [Square Bracket.SLDDRW]
2021-11-09 Create Lever Motor Arm Axel.SLDDRW
    [Lever Motor Arm Axel.SLDDRW]
2021-11-24 bottom frame aprv plan
    [Bottom frame.SLDDRW, Bottom frame.SLDPRT]
